thorpej/Electronics/Power_Supplies/RPI_Remote_Power_Controller/RPI_Remote_Power_Controller-pcb-front.jpg

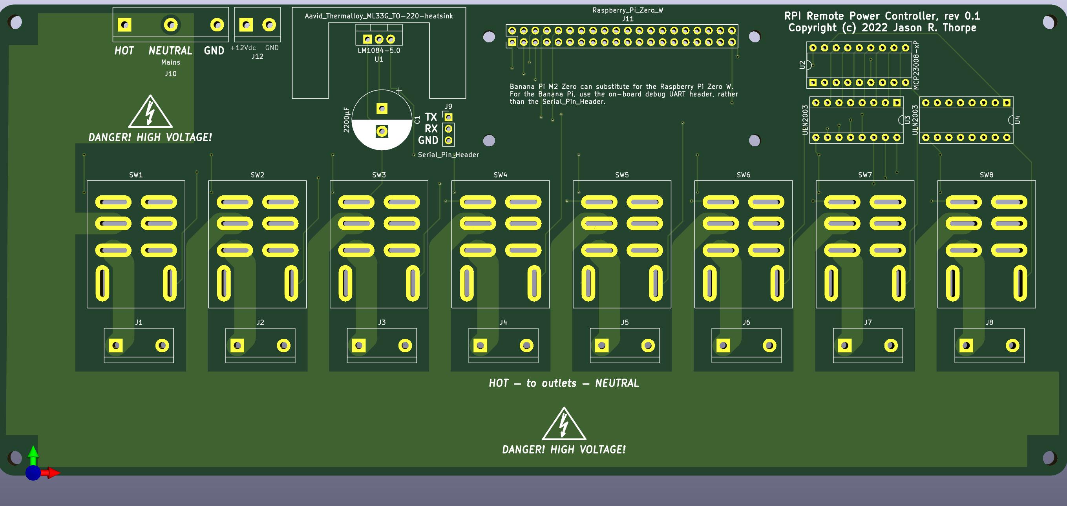
Power_Supplies/RPI_Remote_Power_Controller/RPI_Remote_Power_Controller-pcb-front.jpg
