thorpej/Electronics/Tube_Audio/Helper_Circuits/9A_9AJ_Heater_Helper/9A_9AJ_Heater_Helper-pcb.jpg

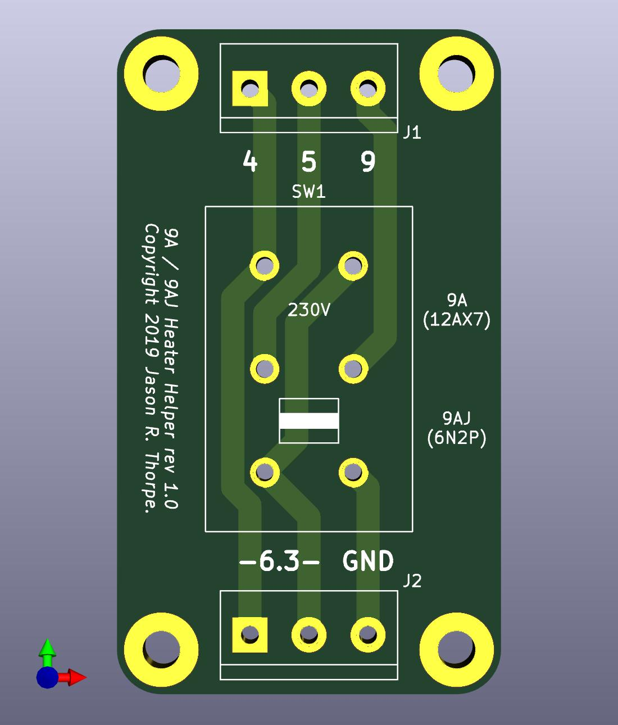
Tube_Audio/Helper_Circuits/9A_9AJ_Heater_Helper/9A_9AJ_Heater_Helper-pcb.jpg
