thorpej/Electronics/README.md

# Electronics
thorpej's electronics projects repository.  Tube audio, other tube stuff, and stuff with computers in it.

# **WARNING**
Some of the materials in this repository desribe circuits that employ **HIGH VOLTAGES** that can be **LETHAL**.
If you build or otherwise use any of these circuits, you do so **AT YOUR OWN RISK**.
