thorpej/Electronics/Tube_Audio/Helper_Circuits/Bias_Balance_Helper_x2/README.md

# 2-Channel Bias-Balance Helper

This is a simple helper board that helps simplify the wiring of a particular output tube
bias-balance circuit that I like to use:

	               A
	               |
	      +---R1---+-----C1-)|----+
	      |        |              |
	      |        |              |
	C- ---+       RV1<---R3---RV2-+-GND
	      |        |           ^--+
	      |        |              |
	      +---R2---+-----C2-)|----+
	               |
	               B

Where:
* C- is the input negative bias voltage from the bias supply.
* RV1 is the "balance" pot used to balance the quiescent current of the two output tubes.
* RV2 is the "bias" pot used to set the nominal bias voltage.  The wiper is connected to one end of the pot such that if the wiper fails for some reason, the maxiumum negative bias voltage will be applied to the output tubes, thereby preventing the tubes from melting down.

The circuit is essentially 2 parallel voltage dividers.  The divider for tube "A" is formed by R1,
RV1, R3, and RV2.  The divider for tube "B" formed by R2, RV1, R3, and RV2.  C1 and C2 are
there to smooth any ripple out of the bias voltage applied to the output tube grids.

This little board has connections for GND, C-, and 2 channels worth of R1, R2, C1, and C2.
All that is required finish the complete circuit is to make the appropriate connections to the pots
(RV1 and RV2) whereever they happen to be mounted (usually next to each other on the deck
so it's easy to adjust).  The wiper of RV1 is connected to one end of RV2 with R3, and that can
easily be done directly on the pots themselves.

The resistor footprints on the board can accommodate resistors 2.5mm in diameter; the pad
spacing is 10.16mm.  The capacitor footprints on the board can accommodate  radial electrolytics
up to 10mm in diameter; the lead spacing is 2.5mm.  The electrolytics must have a voltage rating
sufficient for the largest negative voltage your voltage divider network supply will produce.
