thorpej/Electronics/Power_Supplies/KWard_Adjustable_Bench_Power_Supply/design-files/panel-supply/README.md

# Panel supply

The panel supply board provides a regulated supply to the pass tube array's
cooling fan and the PSU's meters: B+ voltage, B+ current, and C- voltage.

The board is powered by a 12Vac @ 1A transformer, such as the Triad F5-12.
The AC input is rectified by a Rectron DB101 diode bridge chip, filtered,
and fed to an LM2940 12V LDO regulator.

The 12Vdc output for the cooling fan has a provision for a resistor that can
be used to limit the current or drop the voltage to the fan, if desired.  If
you don't want to put a resistor there, just install a jumper wire at the R1
position.  Note the resistor is mounted vertically (to save board space).

The board also has a provisions for 3 Murata MEE1S12xxDC DC-DC converters.
Even if your meters can operate on 12Vdc, use of these DC-DC converters is
**mandatory** because the inexpensive panel meters widely available from China
typically require isolated power supplies.  (Speculation: they are floating
their own internal supply on top of measured voltage?)

There is room on the board for a small heat sink for the LM2940, if necessary,
although there is no dedicated footprint outline for it.  If your LM2940 is
getting warm, there are a variety of heat sinks availble from outlets such as
Amazon (just search for "TO-220 heatsink") that should fit in the alotted space.

The board has standard M3 mounting holes, and is intended to be mounted on the
back of the PSU front panel using stand-offs.

## Parts list

* 12Vac @ 1A power transformer, such as the Triad F5-12.
_Mouser part number 553-F5-12._
* 5x 2-position screw terminal blocks, 2.54mm pitch (TE 282834-2 or equivalent).
_Mouser part number 571-282834-2._
* 1x Rectron DB101 diode bridge (any Rectron DB10x can substitute, if desired).
_Mouser part number 583-DB101._
* 1x 2200µF 25V electrolytic capacitor, up to 12.5mm diameter, 5mm lead spacing.
_Mouser part number 555-RJH-25V222MI9#._
* 1x 220µf 25V electrolytic capacitor, up to 6.3mm diameter, 2.5mm lead spacing.
This capacitor should have an ESR between 100 mOhm and 1 Ohm, per the LM2940 data
sheet.  _Mouser part number 232-25YXS220MEFC63X1._
* 1x LM2940 12V 1A LDO regulator or equivalent (see LM2940 data sheet for pinout).
_Mouser part number 926-LM2940T-50/LF08._
* Murata MEE1S12xxDC DC-DC converters (availble from Mouser or DigiKey).
