thorpej/Electronics/Power_Supplies/KWard_Adjustable_Bench_Power_Supply/KWard_original/Bench PSU Schematic Final.pdf

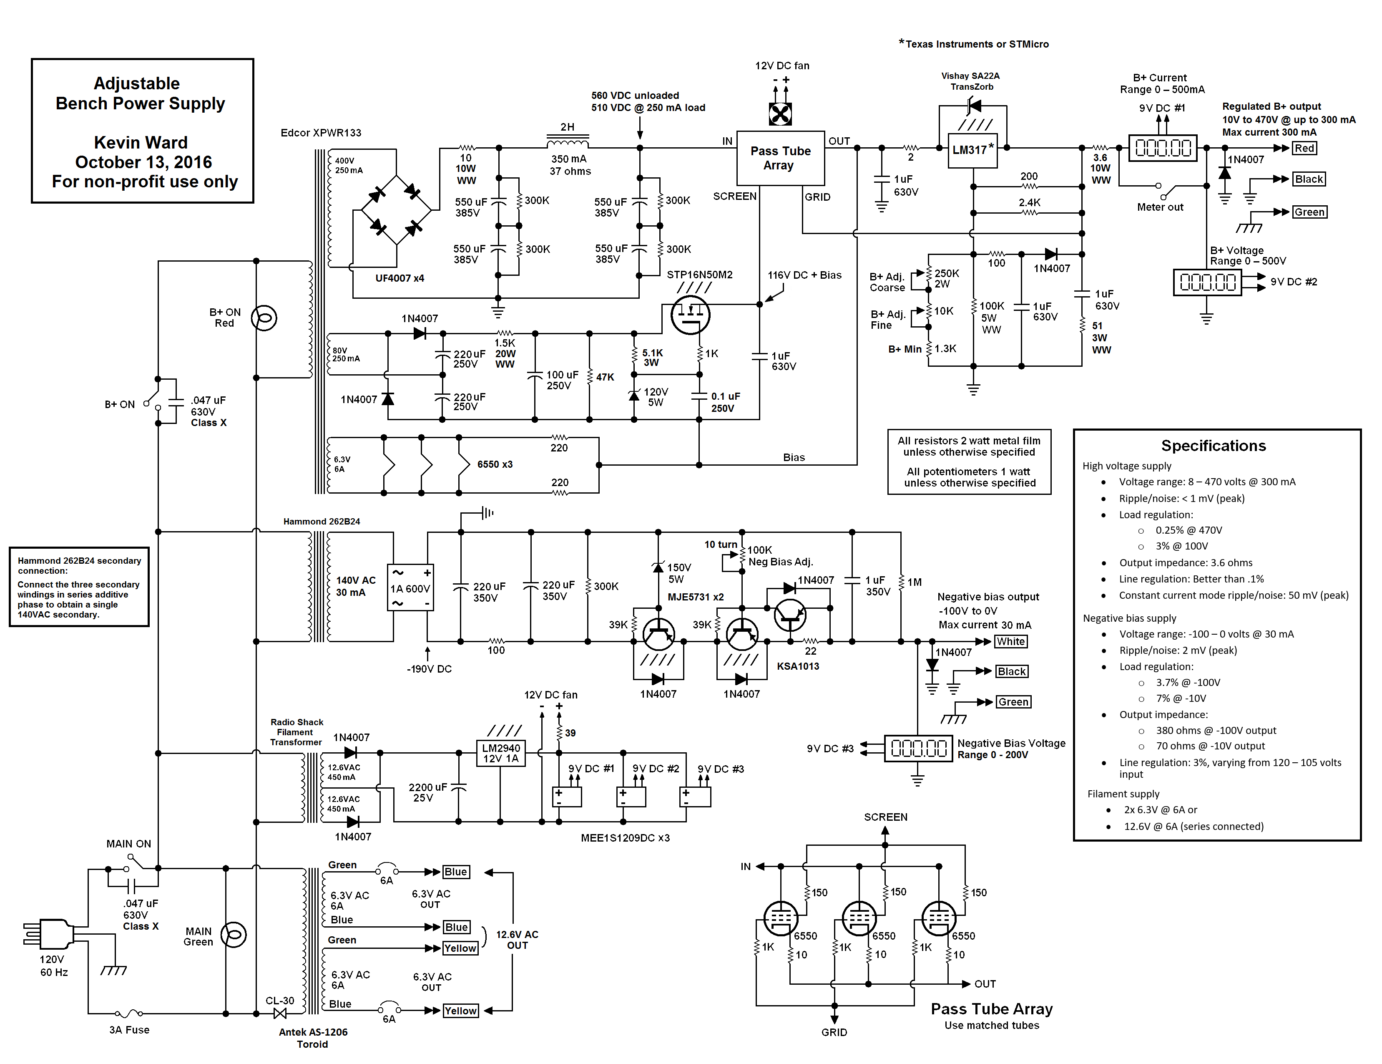
[picture p3: page 1]
