thorpej/Electronics/Power_Supplies/KWard_Adjustable_Bench_Power_Supply/design-files/bias-supply/bias-supply-pcb.jpg

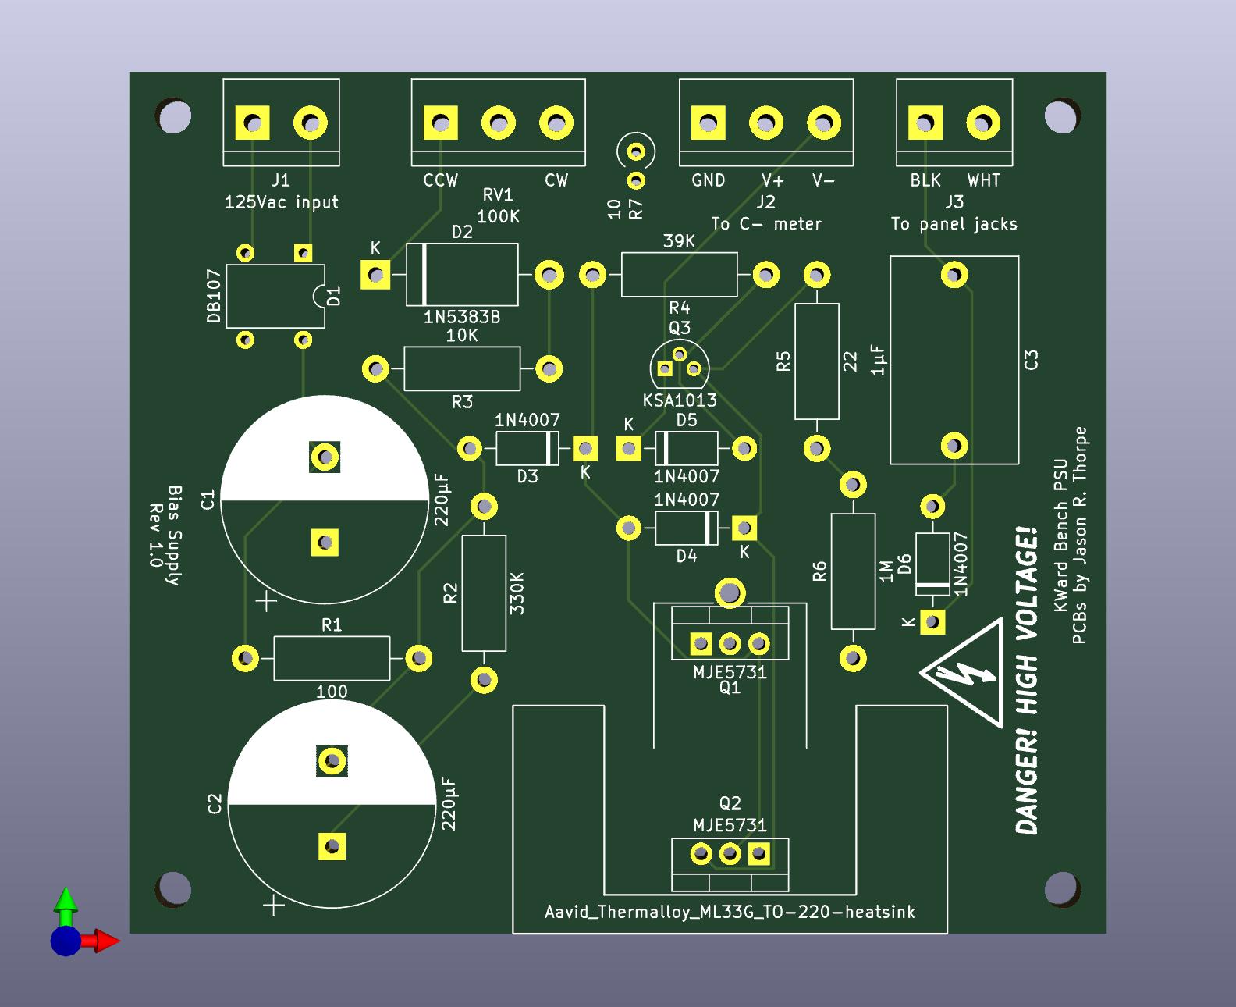
Power_Supplies/KWard_Adjustable_Bench_Power_Supply/design-files/bias-supply/bias-supply-pcb.jpg
