thorpej/Electronics/Power_Supplies/KWard_Adjustable_Bench_Power_Supply/KWard_original/POT setting vs. Output voltage.png

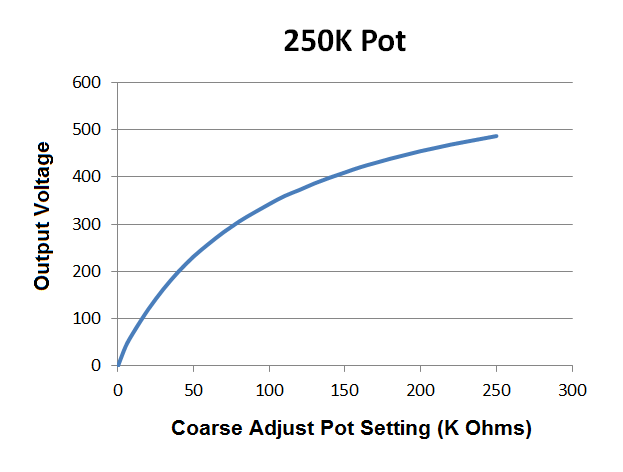
Power_Supplies/KWard_Adjustable_Bench_Power_Supply/KWard_original/POT setting vs. Output voltage.png
