thorpej/Electronics/Power_Supplies/RPI_Remote_Power_Controller/RPI_Remote_Power_Controller-pcb-back.jpg

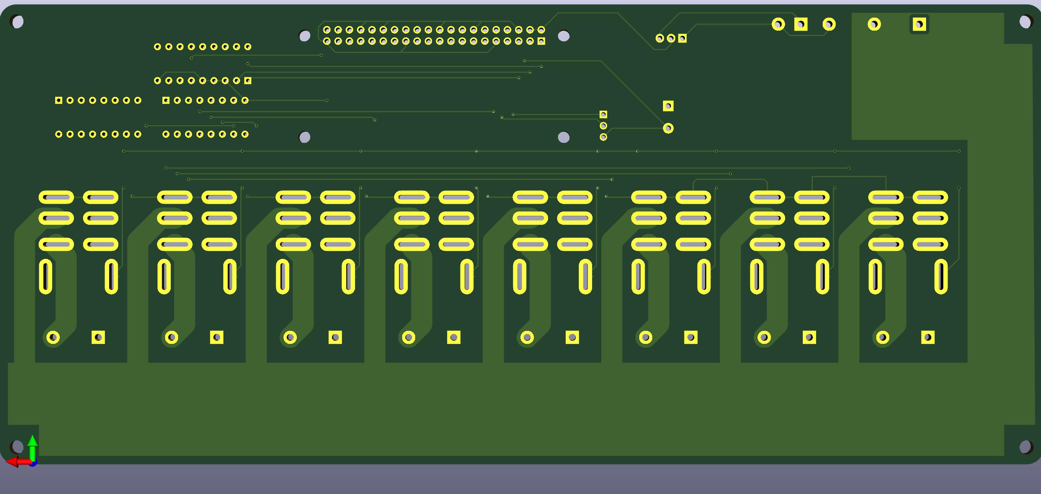
Power_Supplies/RPI_Remote_Power_Controller/RPI_Remote_Power_Controller-pcb-back.jpg
