thorpej/Electronics/Tube_Audio/Helper_Circuits/EFB_Bias_Supply/EFB_Bias_Supply_PCB.jpg

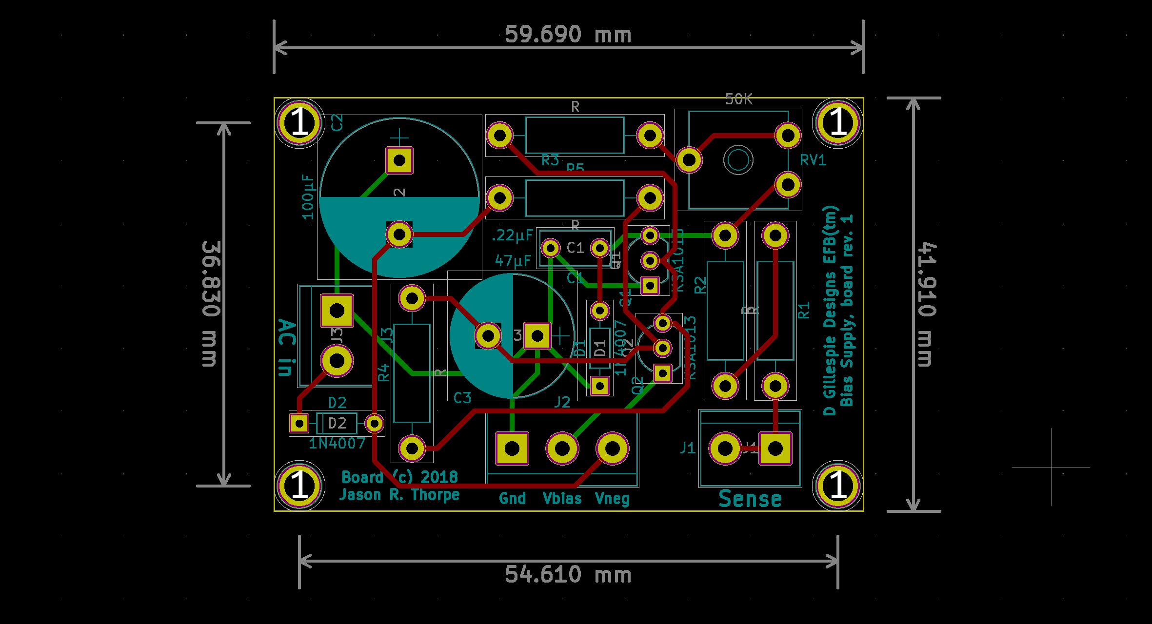
Tube_Audio/Helper_Circuits/EFB_Bias_Supply/EFB_Bias_Supply_PCB.jpg
