thorpej/Electronics/Tube_Audio/Helper_Circuits/SnapInCapStack/SnapInCapStack-pcb.jpg

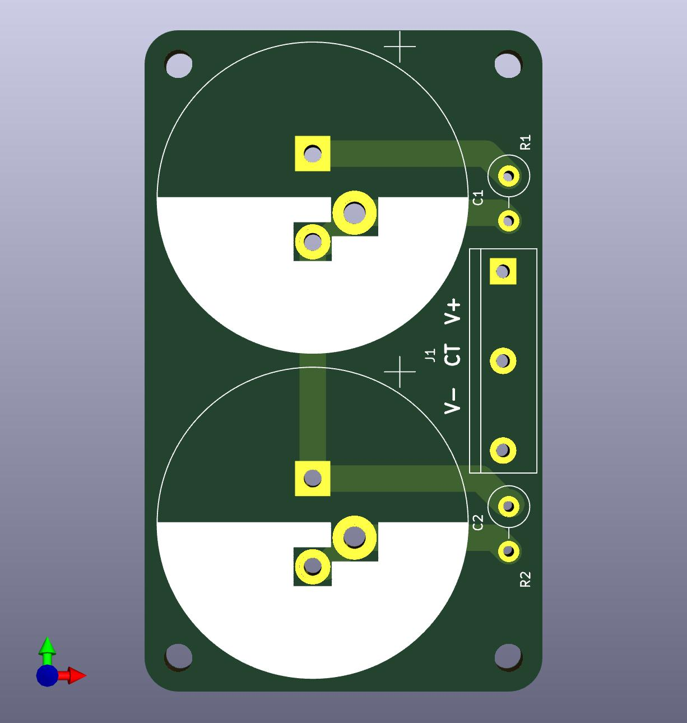
Tube_Audio/Helper_Circuits/SnapInCapStack/SnapInCapStack-pcb.jpg
