thorpej/Electronics/Power_Supplies/KWard_Adjustable_Bench_Power_Supply/KWard_original/capacitor discharge vulnerability fix.png

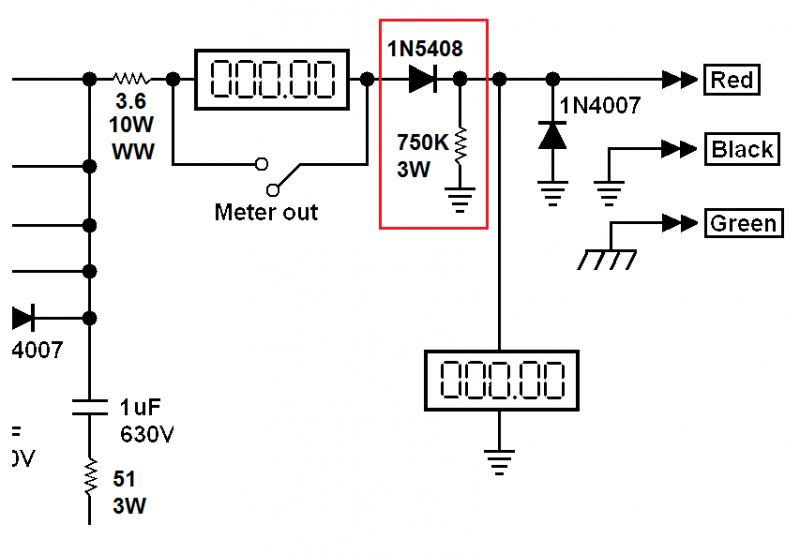
Power_Supplies/KWard_Adjustable_Bench_Power_Supply/KWard_original/capacitor discharge vulnerability fix.png
