thorpej/Electronics/(threads)

Thread 3 (2023-03-15):

The PCB and the DPDT power switch

muni2773, 2023-03-15:
Can you please give exact steps to getting the PCB and then attaching to the switch ?

I got some 6NLPs but can't replace the AX7s that are currently installed

Thanks
