thorpej/Electronics/Power_Supplies/RPI_Remote_Power_Controller/RPI_Remote_Power_Controller-schematic.pdf

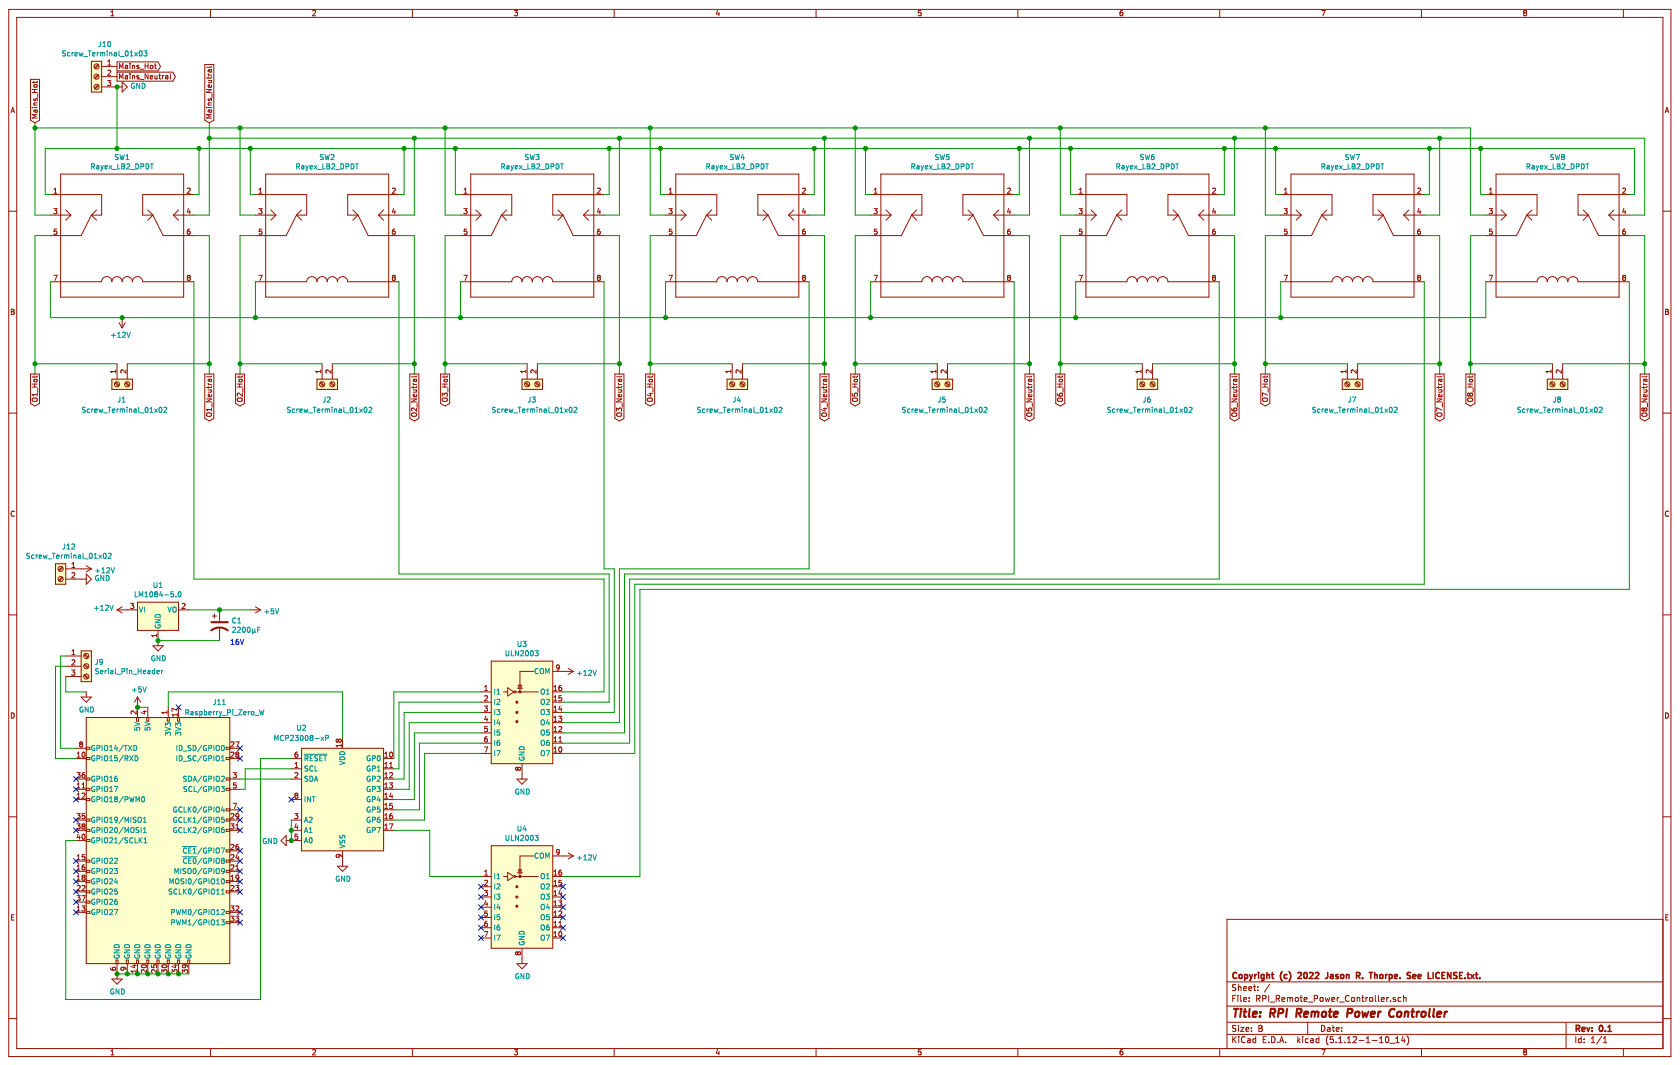
[picture p13: page 1]
