thorpej/Electronics/Tube_Audio/Helper_Circuits/EFB_Bias_Supply/EFB_Bias_Supply_Schematic.pdf

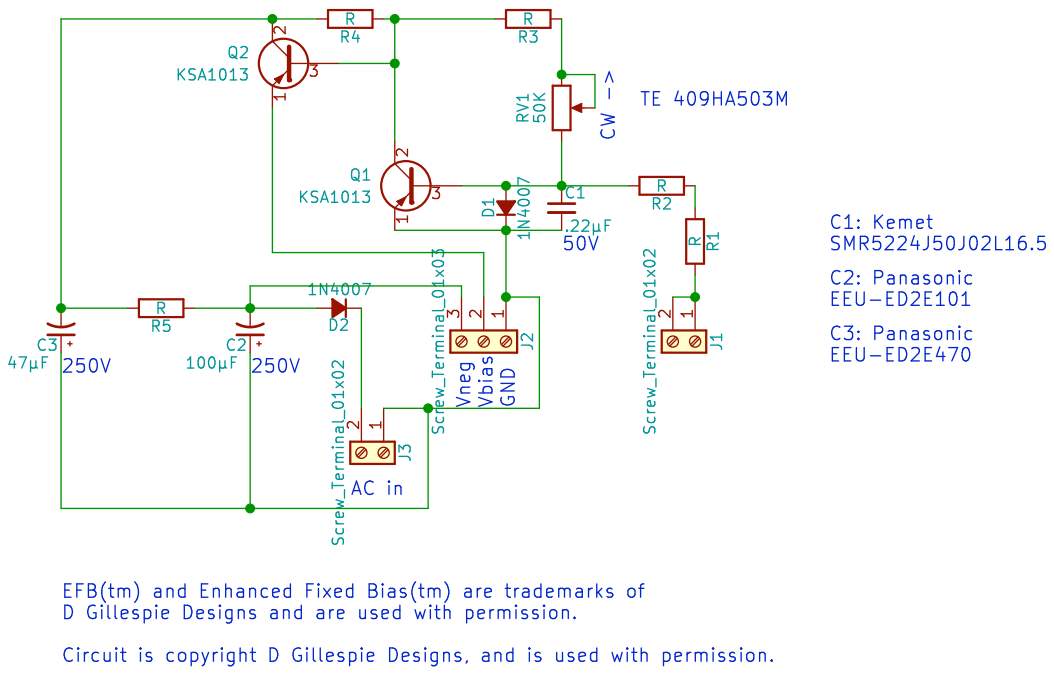
[picture p14: page 1]
