thorpej/Electronics/Tube_Audio/Helper_Circuits/SnapInCapStack/SnapInCapStack-schematic.pdf

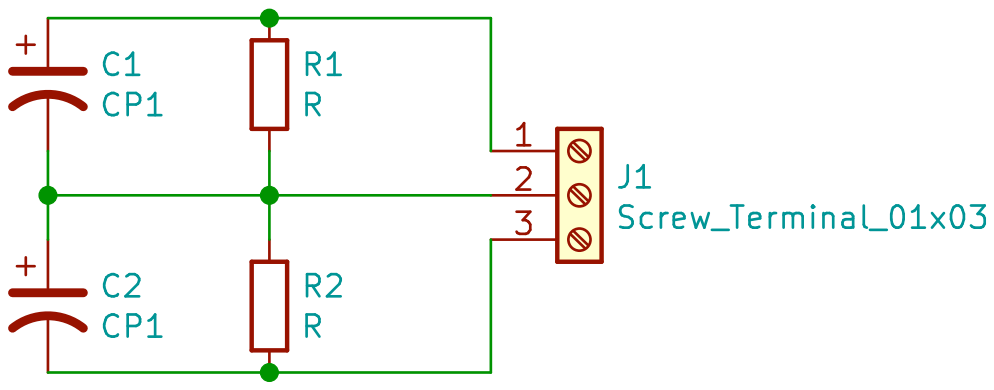
[picture p16: page 1]
