thorpej/Electronics/Power_Supplies/KWard_Adjustable_Bench_Power_Supply/design-files/hv-supply/hv-supply-schematic.pdf

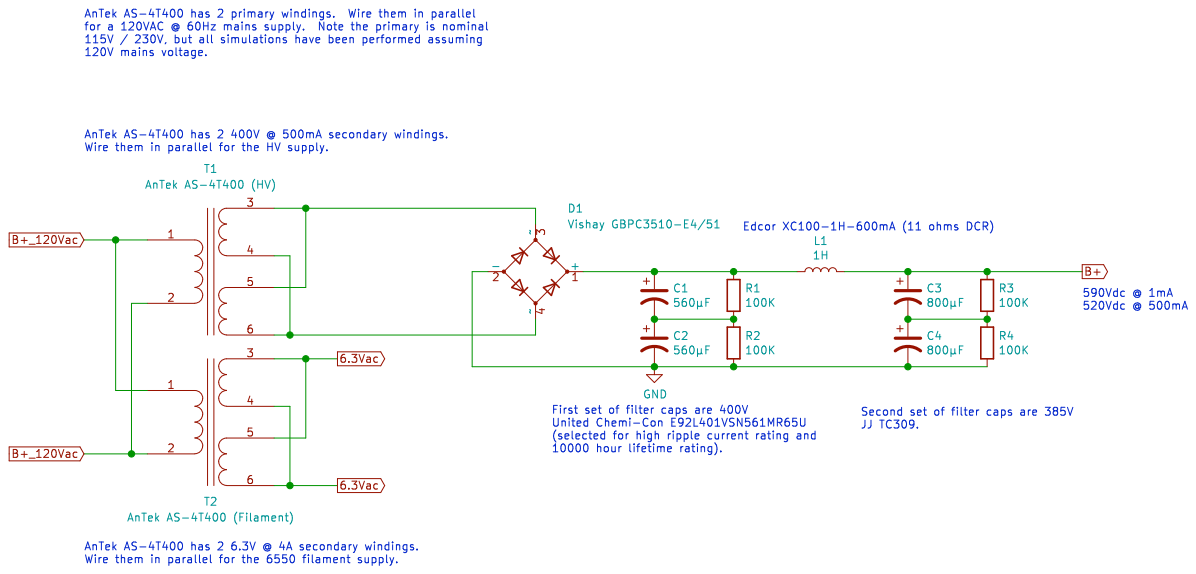
[picture p17: page 1]
