thorpej/Electronics/Power_Supplies/KWard_Adjustable_Bench_Power_Supply/design-files/pass-tube-array/pass-tube-array-pcb.pdf

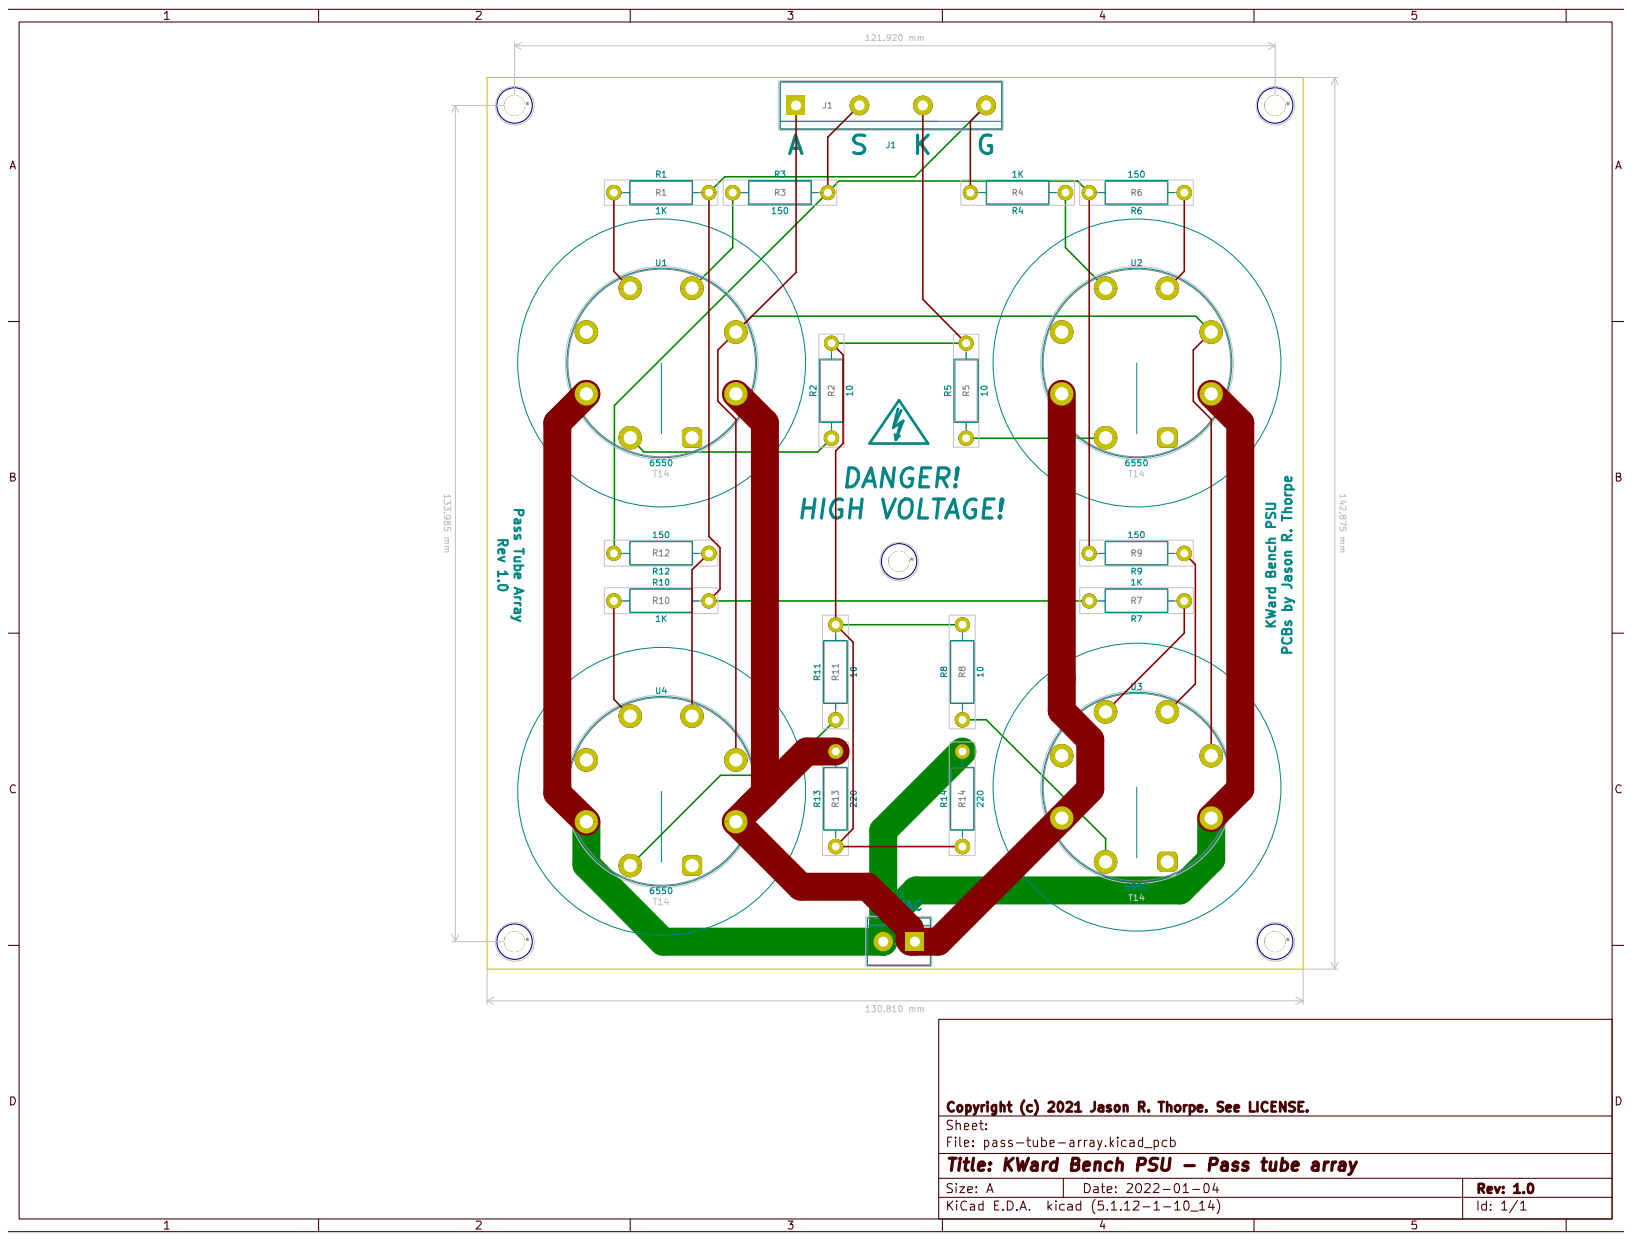
[picture p18: page 1]
