thorpej/Electronics/Power_Supplies/KWard_Adjustable_Bench_Power_Supply/design-files/pass-tube-array/pass-tube-array-schematic.pdf

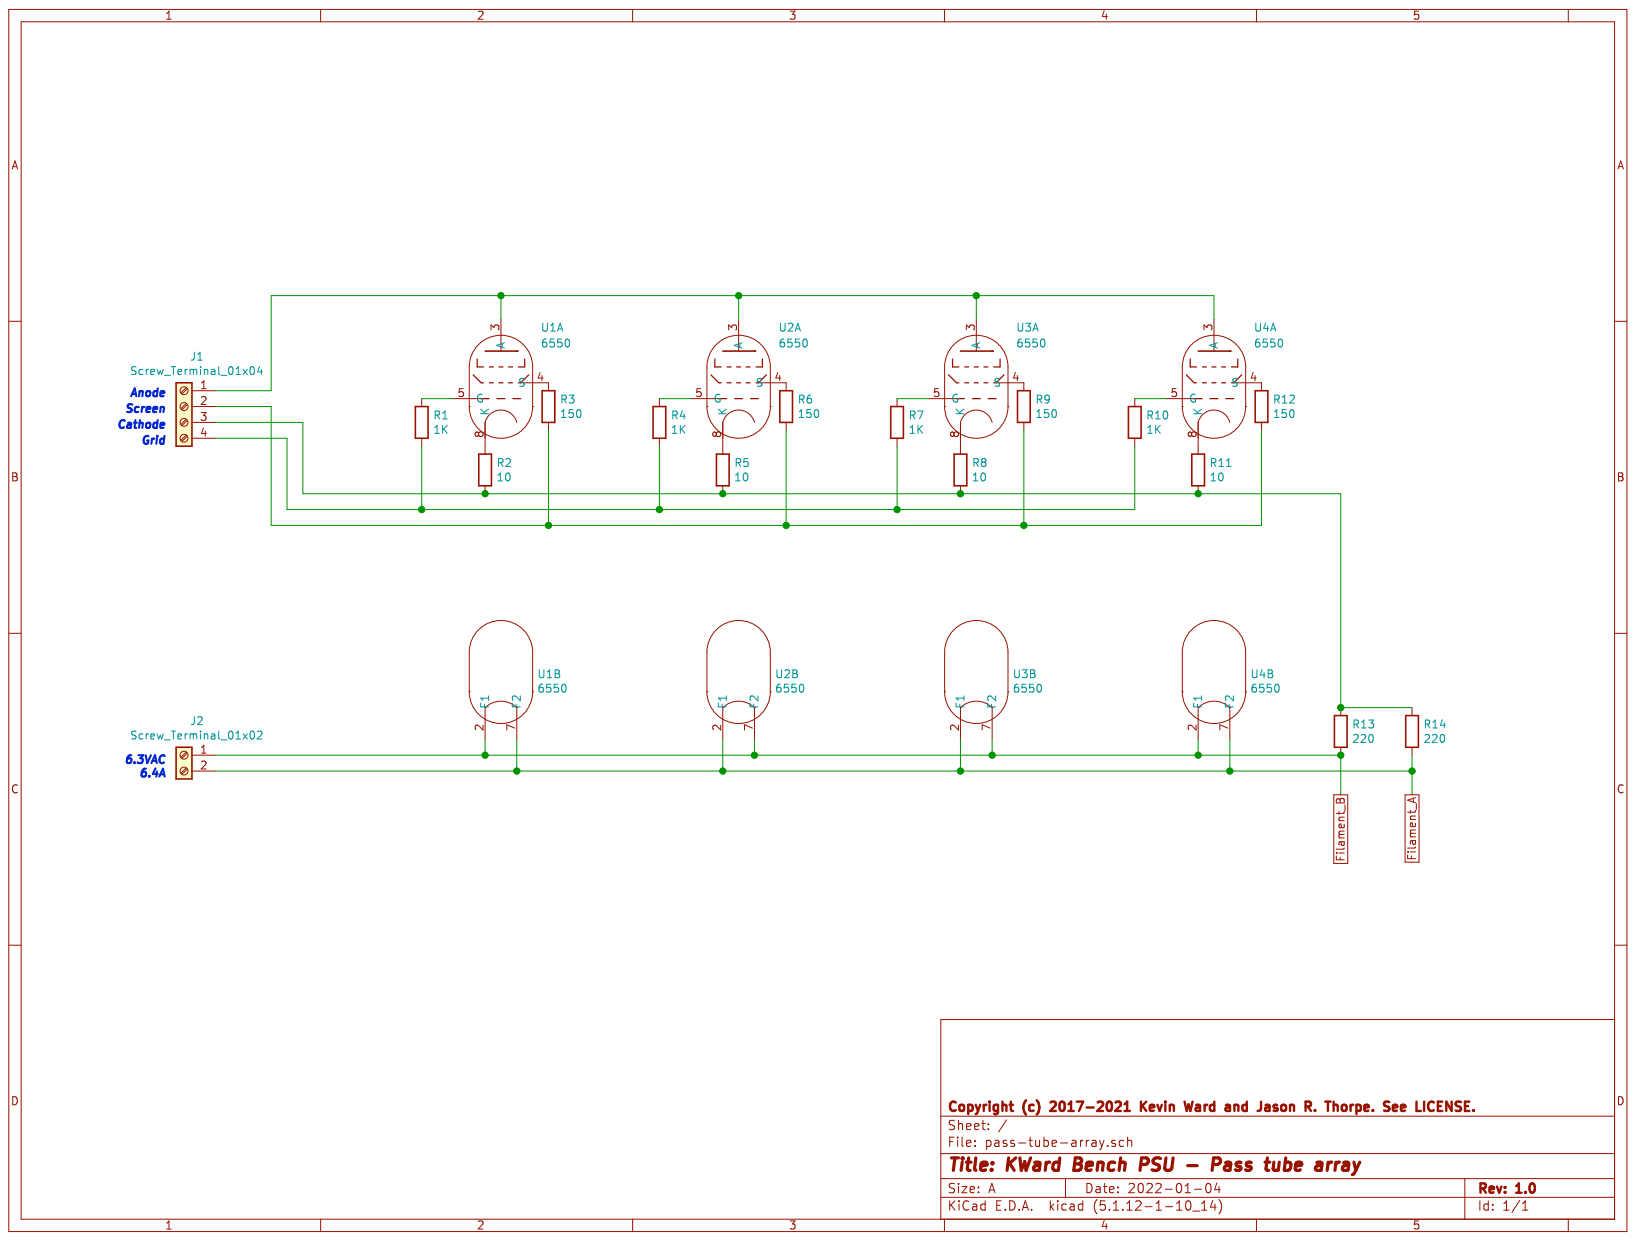
[picture p19: page 1]
