thorpej/Electronics/Power_Supplies/KWard_Adjustable_Bench_Power_Supply/design-files/panel-supply/panel-supply-pcb.pdf

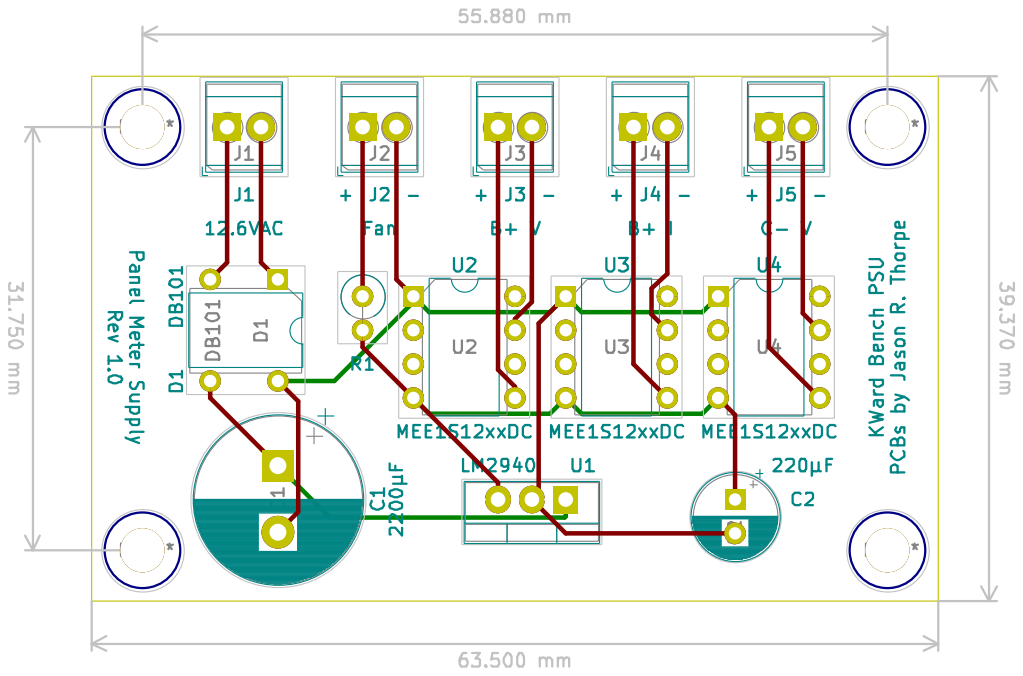
[picture p20: page 1]
