thorpej/Electronics/Power_Supplies/KWard_Adjustable_Bench_Power_Supply/design-files/bias-supply/bias-supply-pcb.pdf

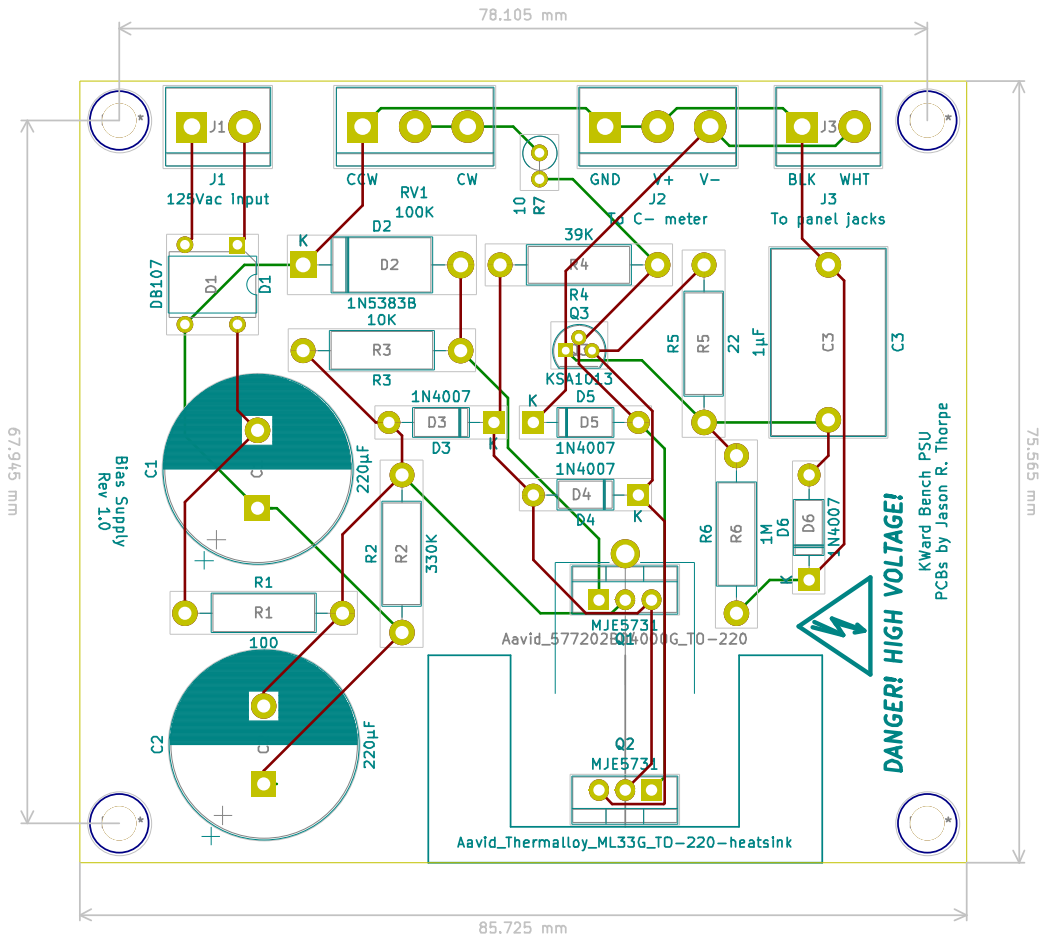
[picture p21: page 1]
