thorpej/Electronics/Power_Supplies/KWard_Adjustable_Bench_Power_Supply/design-files/bias-supply/bias-supply-schematic.pdf

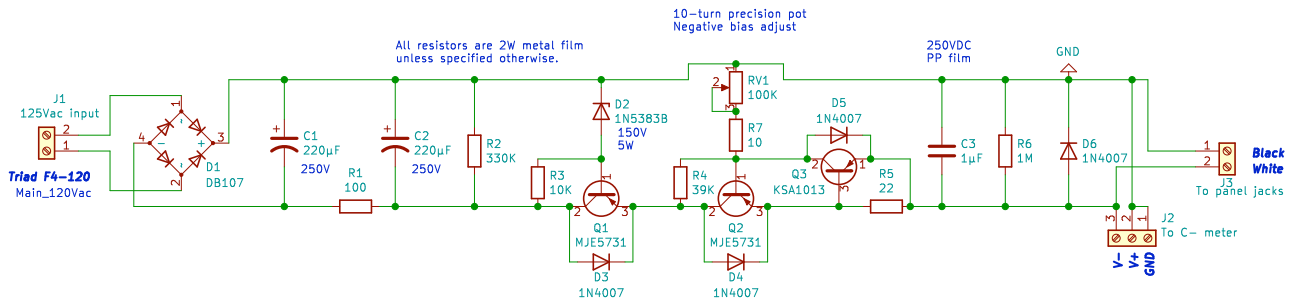
[picture p22: page 1]
