thorpej/Electronics/Power_Supplies/KWard_Adjustable_Bench_Power_Supply/design-files/panel-supply/panel-supply-schematic.pdf

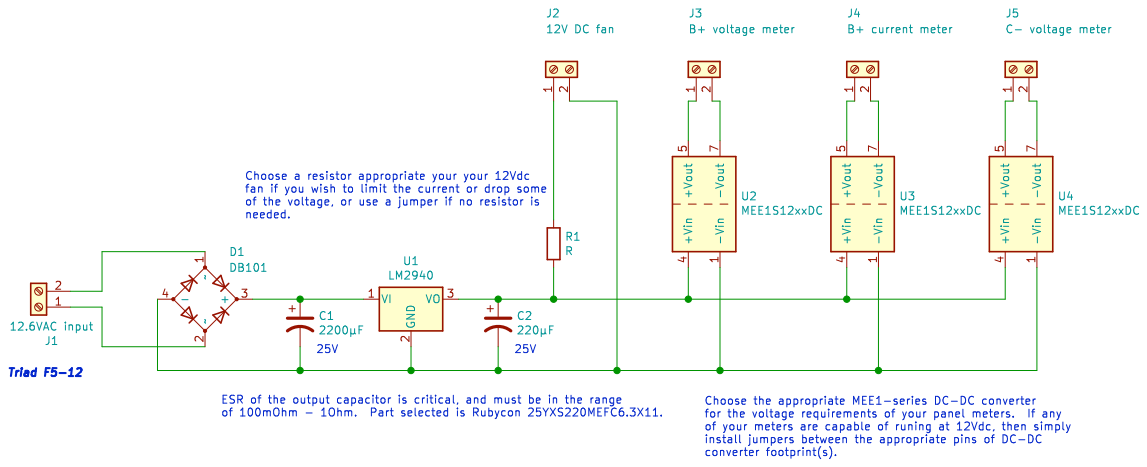
[picture p23: page 1]
