thorpej/Electronics/Power_Supplies/RPI_Remote_Power_Controller/RPI_Remote_Power_Controller-pcb.pdf

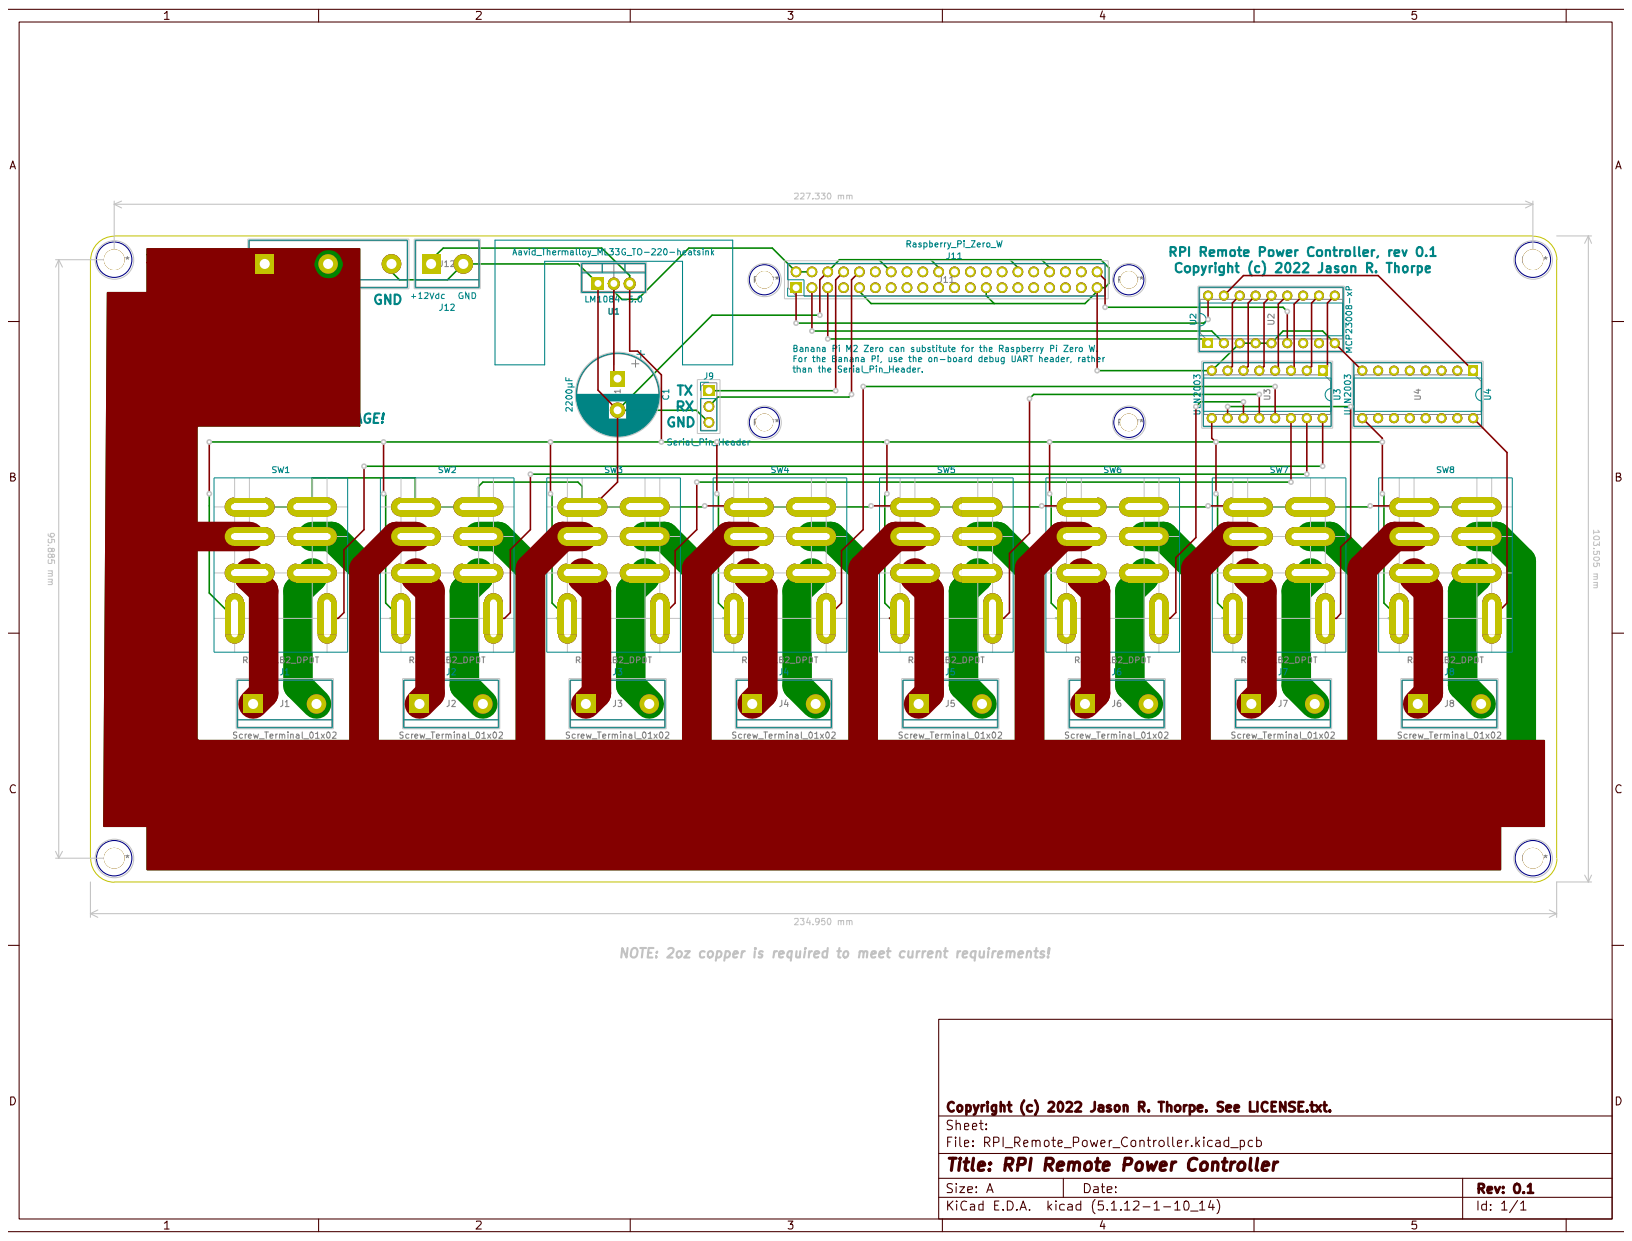
[picture p24: page 1]
