thorpej/Electronics/Tube_Audio/Helper_Circuits/SnapInCapStack/SnapInCapStack-pcb.pdf

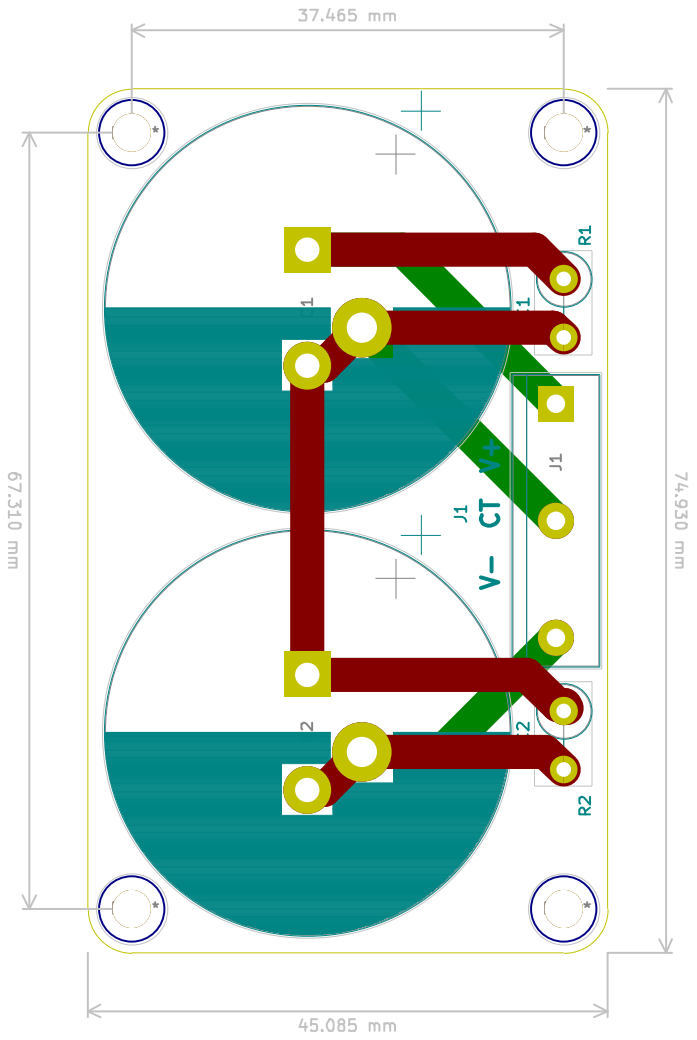
[picture p26: page 1]
