thorpej/Electronics/Tube_Audio/Helper_Circuits/9A_9AJ_Heater_Helper/9A_9AJ_Heater_Helper-pcb.pdf

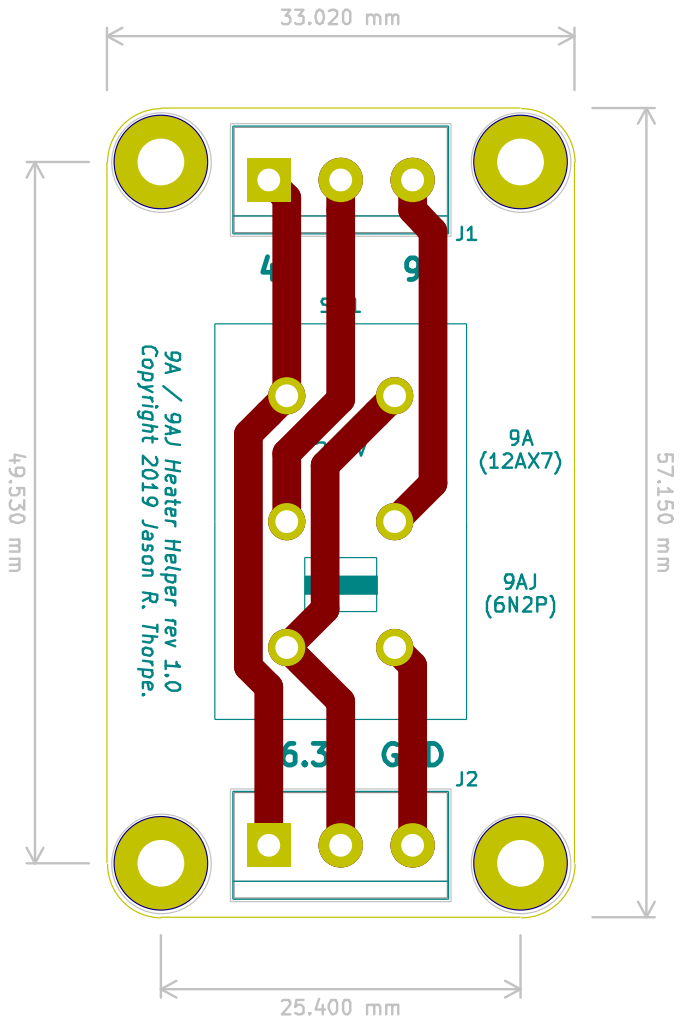
[picture p27: page 1]
