thorpej/Electronics/Misc_Audio/DumbDAC8/DumbDAC8_Sim.asc

R1: res; 200K
R2: res; 200K
R3: res; 200K
R4: res; 200K
R5: res; 200K
R6: res; 200K
R7: res; 200K
R8: res; 200K
R9: res; 100K
R10: res; 100K
R11: res; 100K
R12: res; 100K
R13: res; 100K
R14: res; 100K
R15: res; 100K
R16: res; 25K
R17: res; 200K
V1: voltage; 5
V2: voltage; 5
V3: voltage; 5
V4: voltage; 5
V5: voltage; 5
V6: voltage; 5
V7: voltage; 5
V8: voltage; 5
Named nets: 0
D0
D7
.tran 1
3.8mV
5.7mV
10.5mV
20.5mV
40.8mV
81.5mV
163.0mV
326.1mV
15K
5.8mV
8.7mV
16.1mV
31.5mV
62.6mV
125.0mV
250.0mV
500mV
25K
3.9mV
7.8mV
15.6mV
31.25mV
62.5mV
125.0mV
250.0mV
500mV
With R17
