thorpej/Electronics/Power_Supplies/KWard_Adjustable_Bench_Power_Supply/spice/ScreenSupply.asc

C1: polcap; 220µF
C2: polcap; 220µF
C3: cap; 0.47µF
C4: cap; 1µF
D1: diode
D2: diode
D3: diode
D4: diode
D5: zener; 1N5378B
D6: zener; EDZV20B
I1: current; 62.5mA
M1: nmos; STF16N50M2_V2
R1: res; 330
R2: res; 47K
R3: res; 2.2K
R4: res; 1K
V1: voltage; SINE(0 169 60)
Named nets: 0
.tran 2
.inc STF16N50M2_V2.LIB
100V
20V
Triad F6-120
MDA106G
Use a single 1N5380BG 120V 5W Zener.
630V
metalized film
630V
metalized film
10W WW
2x Nichicon UCS2E221MHD
250V
250V
