thorpej/Electronics/Power_Supplies/KWard_Adjustable_Bench_Power_Supply/spice/B+Supply.asc

C1: polcap; 560µF
C2: polcap; 560µF
C3: polcap; 800µF
C4: polcap; 800µF
D1: diode
D2: diode
D3: diode
D4: diode
I1: current; 500mA
L1: ind; 1H; Rser=11
R1: res; 10
R2: res; 100K
R3: res; 100K
R4: res; 100K
R5: res; 100K
V1: voltage; SINE(0 560 60)
Named nets: 0
.tran 5
AnTek AS-4T400
Vishay GBPC3510-E4/51
Edcor XC100-1H-600mA (11 ohms)
385V
385V
385V
385V
2x TDK B43501B3567M2
2x JJ TC309
