thorpej/Electronics/Tube_Audio/Helper_Circuits/EFB_Bias_Supply/Bias_Balance_Network.asc

C1: polcap; 10µF
C2: polcap; 10µF
C3: polcap; 10µF
C4: polcap; 10µF
R1: res; 9.1K
R2: res; 9.1K
R3: res; 5K
R4: res; 5K
R5: res; 6.2K
R6: res; 12.5K
R7: res; 9.1K
R8: res; 9.1K
R9: res; 5K
R10: res; 5K
R11: res; 6.2K
R12: res; 12.5K
V1: voltage; 43
Named nets: 0, A, B, C, D
.tran 5
Resistor pairs R3/R4 and R9/R10 are actually a 10K pot; this is a
DC balance adjustment for a push-pull pair.
While more complex than individual bias controls, this circuit provides
for easier DC balance adjustment, and provides protection against
a wiper failiure of the bias pot; if that happens, maximum negative
bias voltage will  be applied to the output tube grids, thus preventing
damage.
Resistors R6 and R12 are actually 25K pots with the wiper
connected to one end to form a variable resistor.  This is a bias
adjustment for a push-pull pair.
