thorpej/Electronics/Tube_Audio/Helper_Circuits/EFB_Bias_Supply/Individual_Bias_Network.asc

C1: polcap; 10µF
C2: polcap; 10µF
C3: polcap; 10µF
C4: polcap; 10µF
R1: res; 12.5K
R2: res; 12.5K
R3: res; 12.5K
R4: res; 12.5K
R5: res; 12.5K
R6: res; 12.5K
R7: res; 12.5K
R8: res; 12.5K
R9: res; 10K
V1: voltage; 63
Named nets: 0, A, B, C, D
.tran 5
Resistor pairs (R1/R2, R3/R4, R5/R6, and R7/R8) are actually a 25K
pot, with the junction in the middle being the wiper that connects to
a single output tube grid.  Each tube can be individually biased with
this topology.
