thorpej/Electronics/Power_Supplies/KWard_Adjustable_Bench_Power_Supply/spice/BiasSupply.asc

C1: polcap; 220µF
C2: polcap; 220µF
C4: cap; 1µF
D1: diode
D2: diode
D3: diode
D4: diode
D5: zener; 1N5378B
D6: zener; EDZV20B
D7: zener; EDZV30B
D8: diode
D9: diode
D10: diode
D11: diode
I1: current; 30mA
Q1: pnp; Qmje5730
Q2: pnp; Qmje5730
Q3: pnp
R1: res; 100
R2: res; 300K
R3: res; 10K
R4: res; 39K
R5: res; 1000K
R6: res; 100K
R7: res; 22
R8: res; 10
V1: voltage; SINE(0 168 60)
Named nets: 0
.tran 10
.inc MJE5730.LIB.txt
100V
20V
Triad F4-120
MDA106G
Use a single 1N5383BG 150V 5W Zener.
400V
metalized film
2x Nichicon UCS2E221MHD
250V
250V
30V
100K pot
2x MJE5370
KSA1013
