thorpej/Electronics/Power_Supplies/KWard_Adjustable_Bench_Power_Supply/design-files/screen-supply-and-regulator/screen-supply-and-regulator.kicad_pcb

## KiCad design Power_Supplies/KWard_Adjustable_Bench_Power_Supply/design-files/screen-supply-and-regulator/screen-supply-and-regulator.kicad_pcb (2022-04-21)

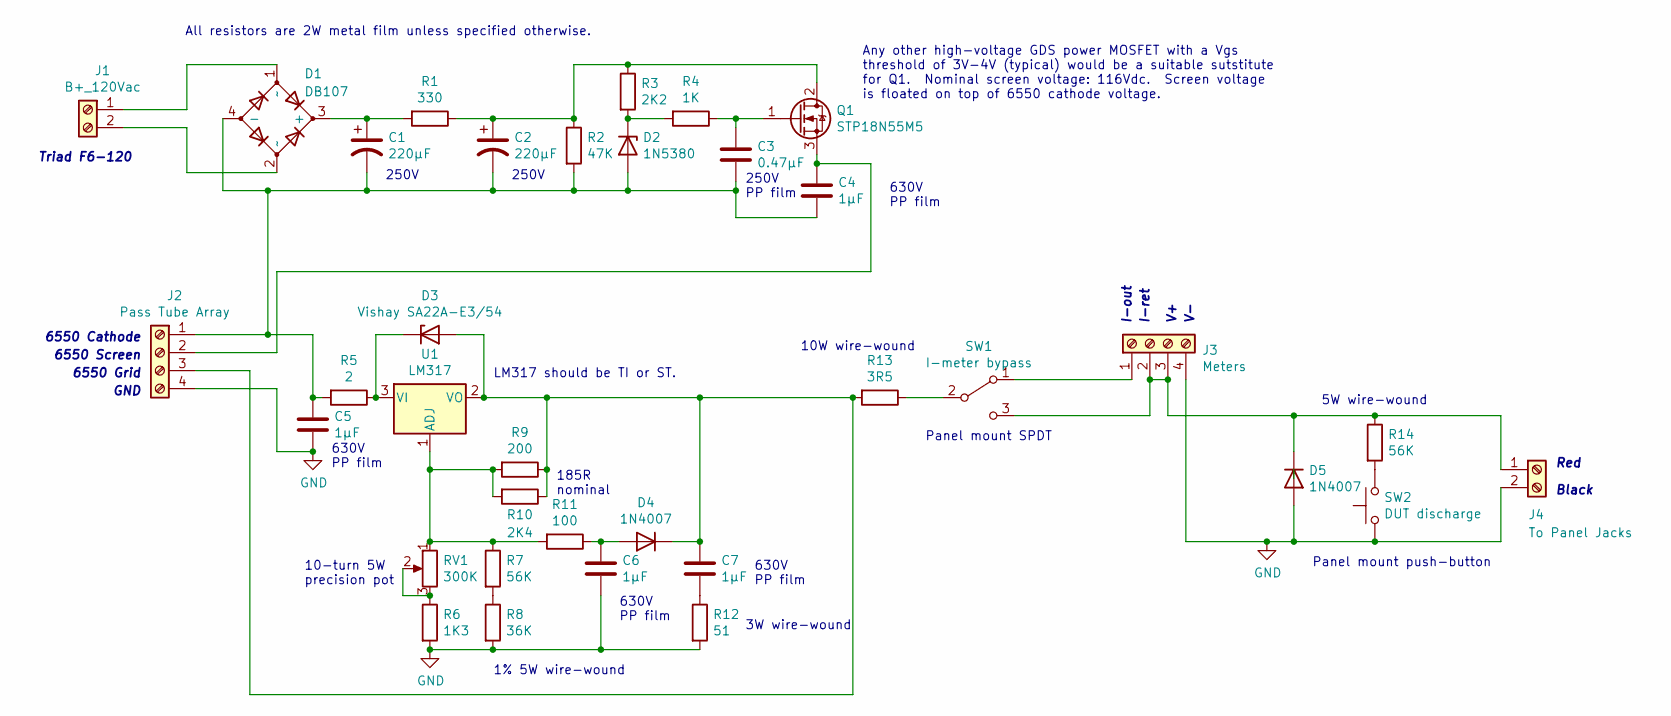
[picture p28: schematic screen-supply-and-regulator.sch, KWard Bench PSU - Screen supply and regulator circuit]

Parts:
C1, C2: 220µF; CP_Radial_D18.0mm_P7.50mm; Mouser 647-UCS2E221MHD
C3: 0.47µF; C_Rect_L18.0mm_W8.0mm_P15.00mm_FKS3_FKP3; Mouser 80-PHE426HB6470JR06
C4, C5, C6, C7: 1µF; C_Rect_L18.0mm_W18.0mm_P15.0mm; Mouser 667-ECW-FD2J105PC
D1: DB107; Diode_Bridge_DIP-4_W7.62mm_P5.08mm
D2: 1N5380; D_DO-201_P15.24mm_Horizontal
D3: Vishay SA22A-E3/54; D_DO-15_P15.24mm_Horizontal; Mouser 625-SA22A-E3/54
D4, D5: 1N4007; D_DO-41_SOD81_P10.16mm_Horizontal
J1: B+_120Vac; TerminalBlock_bornier-2_P5.08mm
J2: Pass Tube Array; TE_AMP-4_P10.16mm
J3: Meters; TE_AMP-4_P10.16mm
J4: To Panel Jacks; TE_AMP-2_P10.16mm
Q1: STP18N55M5; TO-220-3_Vertical
R1: 330; R_Axial_DIN0411_L9.9mm_D3.6mm_P15.24mm_Horizontal; Mouser 594-5083NW330R0J
R2: 47K; R_Axial_DIN0411_L9.9mm_D3.6mm_P15.24mm_Horizontal; Mouser 594-5083NW47K00JA100
R3: 2K2; R_Axial_DIN0411_L9.9mm_D3.6mm_P15.24mm_Horizontal; Mouser 594-5083NW2K200J
R4: 1K; R_Axial_DIN0411_L9.9mm_D3.6mm_P15.24mm_Horizontal; Mouser 594-5083NW1K000J
R5: 2; R_Axial_DIN0411_L9.9mm_D3.6mm_P15.24mm_Horizontal; Mouser 594-5083NW2R000J
R6: 1K3; R_Axial_DIN0411_L9.9mm_D3.6mm_P15.24mm_Horizontal; Mouser 594-5083NW1K300J
R7: 56K; R_Axial_Power_L25.0mm_W9.0mm_P30.48mm; Mouser 71-RS00556K00FE12
R8: 36K; R_Axial_Power_L25.0mm_W9.0mm_P30.48mm; Mouser 71-RS00236K00FB12
R9: 200; R_Axial_DIN0411_L9.9mm_D3.6mm_P15.24mm_Horizontal; Mouser 594-5083NW200R0J
R10: 2K4; R_Axial_DIN0411_L9.9mm_D3.6mm_P15.24mm_Horizontal; Mouser 594-5083NW2K400J
R11: 100; R_Axial_DIN0411_L9.9mm_D3.6mm_P15.24mm_Horizontal; Mouser 594-5083NW100R0JA100
R12: 51; R_Axial_DIN0614_L14.3mm_D5.7mm_P20.32mm_Horizontal; Mouser 71-NS02B51R00FE12
R13: 3R5; R_Axial_Power_L48.0mm_W12.5mm_P55.88mm; Mouser 71-RS0103R500FE12
R14: 56K; R_Axial_Power_L25.0mm_W6.4mm_P30.48mm; Mouser 71-CW00556K00JE12
RV1: 300K; TE_AMP-3_P10.16mm
SW1: I-meter bypass; TerminalBlock_bornier-3_P5.08mm
SW2: DUT discharge; TE_AMP-2_P10.16mm
U1: LM317; TO-220-3_Vertical; Mouser 926-LM317AT/NOPB

Connections:
GND: C5.2, C6.2, D5.2 (A), J2.4, J3.4, J4.2, R6.2, R8.2, R12.2, SW2.1
unnamed: C1.1, D1.3 (+), R1.2
unnamed: C1.2, C2.2, C3.2, C4.2, C5.1, D1.4 (-), D2.2 (A), J2.1, R2.2, R5.2
unnamed: C2.1, Q1.2 (D), R1.1, R2.1, R3.1
unnamed: C3.1, Q1.1 (G), R4.1
unnamed: C4.1, J2.2, Q1.3 (S)
unnamed: C6.1, D4.2 (A), R11.1
unnamed: C7.1, D3.2 (A), D4.1 (K), J2.3, R9.1, R10.1, R13.2, U1.2 (VO)
unnamed: C7.2, R12.1
unnamed: D1.1 (~~), J1.1
unnamed: D1.2 (~~), J1.2
unnamed: D2.1 (K), R3.2, R4.2
unnamed: D3.1 (K), R5.1, U1.3 (VI)
unnamed: D5.1 (K), J3.2, J3.3, J4.1, R14.1, SW1.3 (C)
unnamed: J3.1, SW1.1 (A)
unnamed: R6.1, RV1.2, RV1.3
unnamed: R7.2, R8.1
unnamed: R7.1, R9.2, R10.2, R11.2, RV1.1, U1.1 (ADJ)
unnamed: R13.1, SW1.2 (B)
unnamed: R14.2, SW2.2

Notes on the sheet:
Triad F6-120
Any other high-voltage GDS power MOSFET with a Vgs threshold of 3V-4V (typical) would be a suitable sutstitute for Q1. Nominal screen voltage: 116Vdc. Screen voltage is floated on top of 6550 cathode voltage.
6550 Cathode
6550 Grid
6550 Screen
630V PP film
185R nominal
10-turn 5W precision pot
3W wire-wound
1% 5W wire-wound
LM317 should be TI or ST.
All resistors are 2W metal film unless specified otherwise.
10W wire-wound
5W wire-wound
Panel mount SPDT
Panel mount push-button
Red
Black
I-out
I-ret
250V
250V PP film
GND

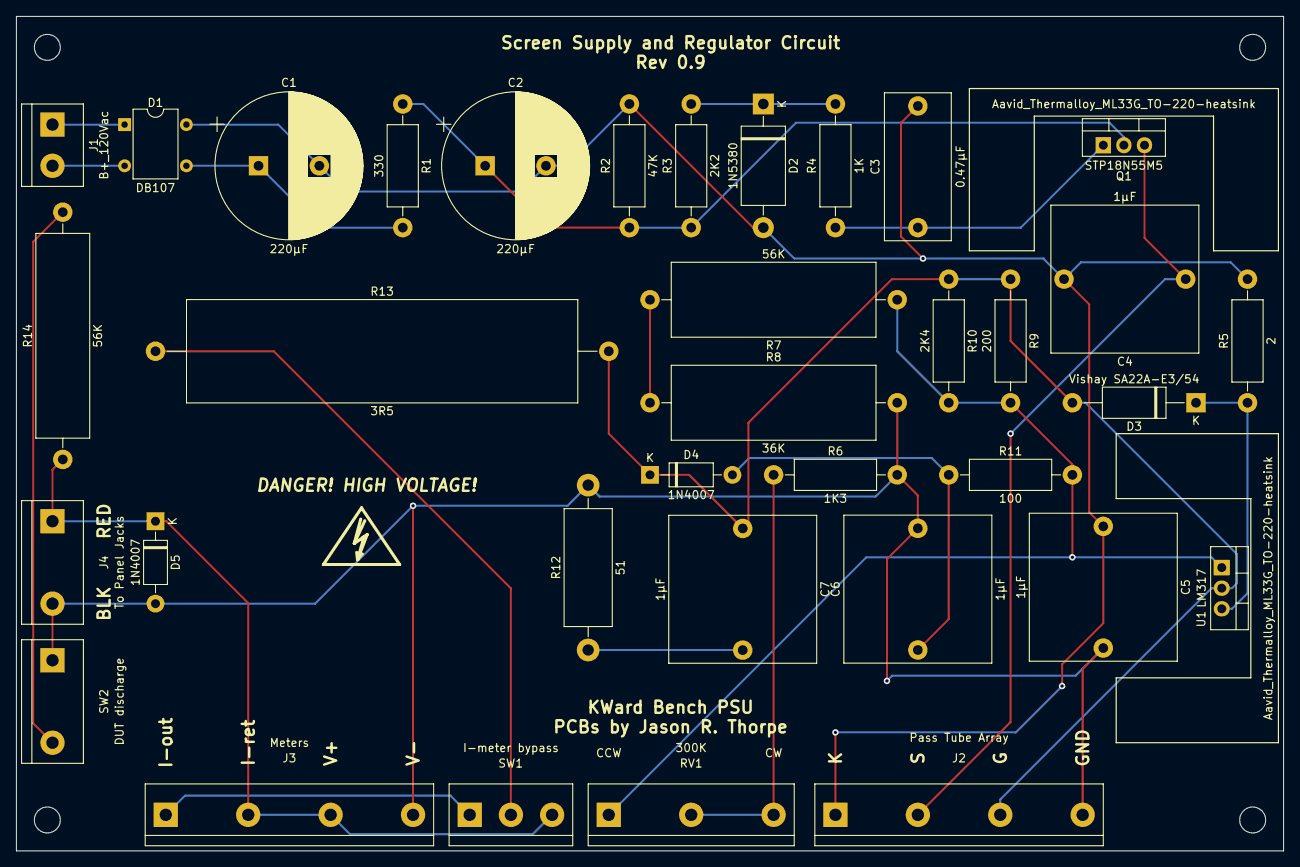
[picture p29: board screen-supply-and-regulator.kicad_pcb from above]

Board: 2 copper layers, 156.2 x 102.9 mm, 35 parts (0 on the bottom side), 20 nets.
