thorpej/Electronics/Power_Supplies/RPI_Remote_Power_Controller/RPI_Remote_Power_Controller.kicad_pcb

## KiCad design Power_Supplies/RPI_Remote_Power_Controller/RPI_Remote_Power_Controller.kicad_pcb (2022-01-09)

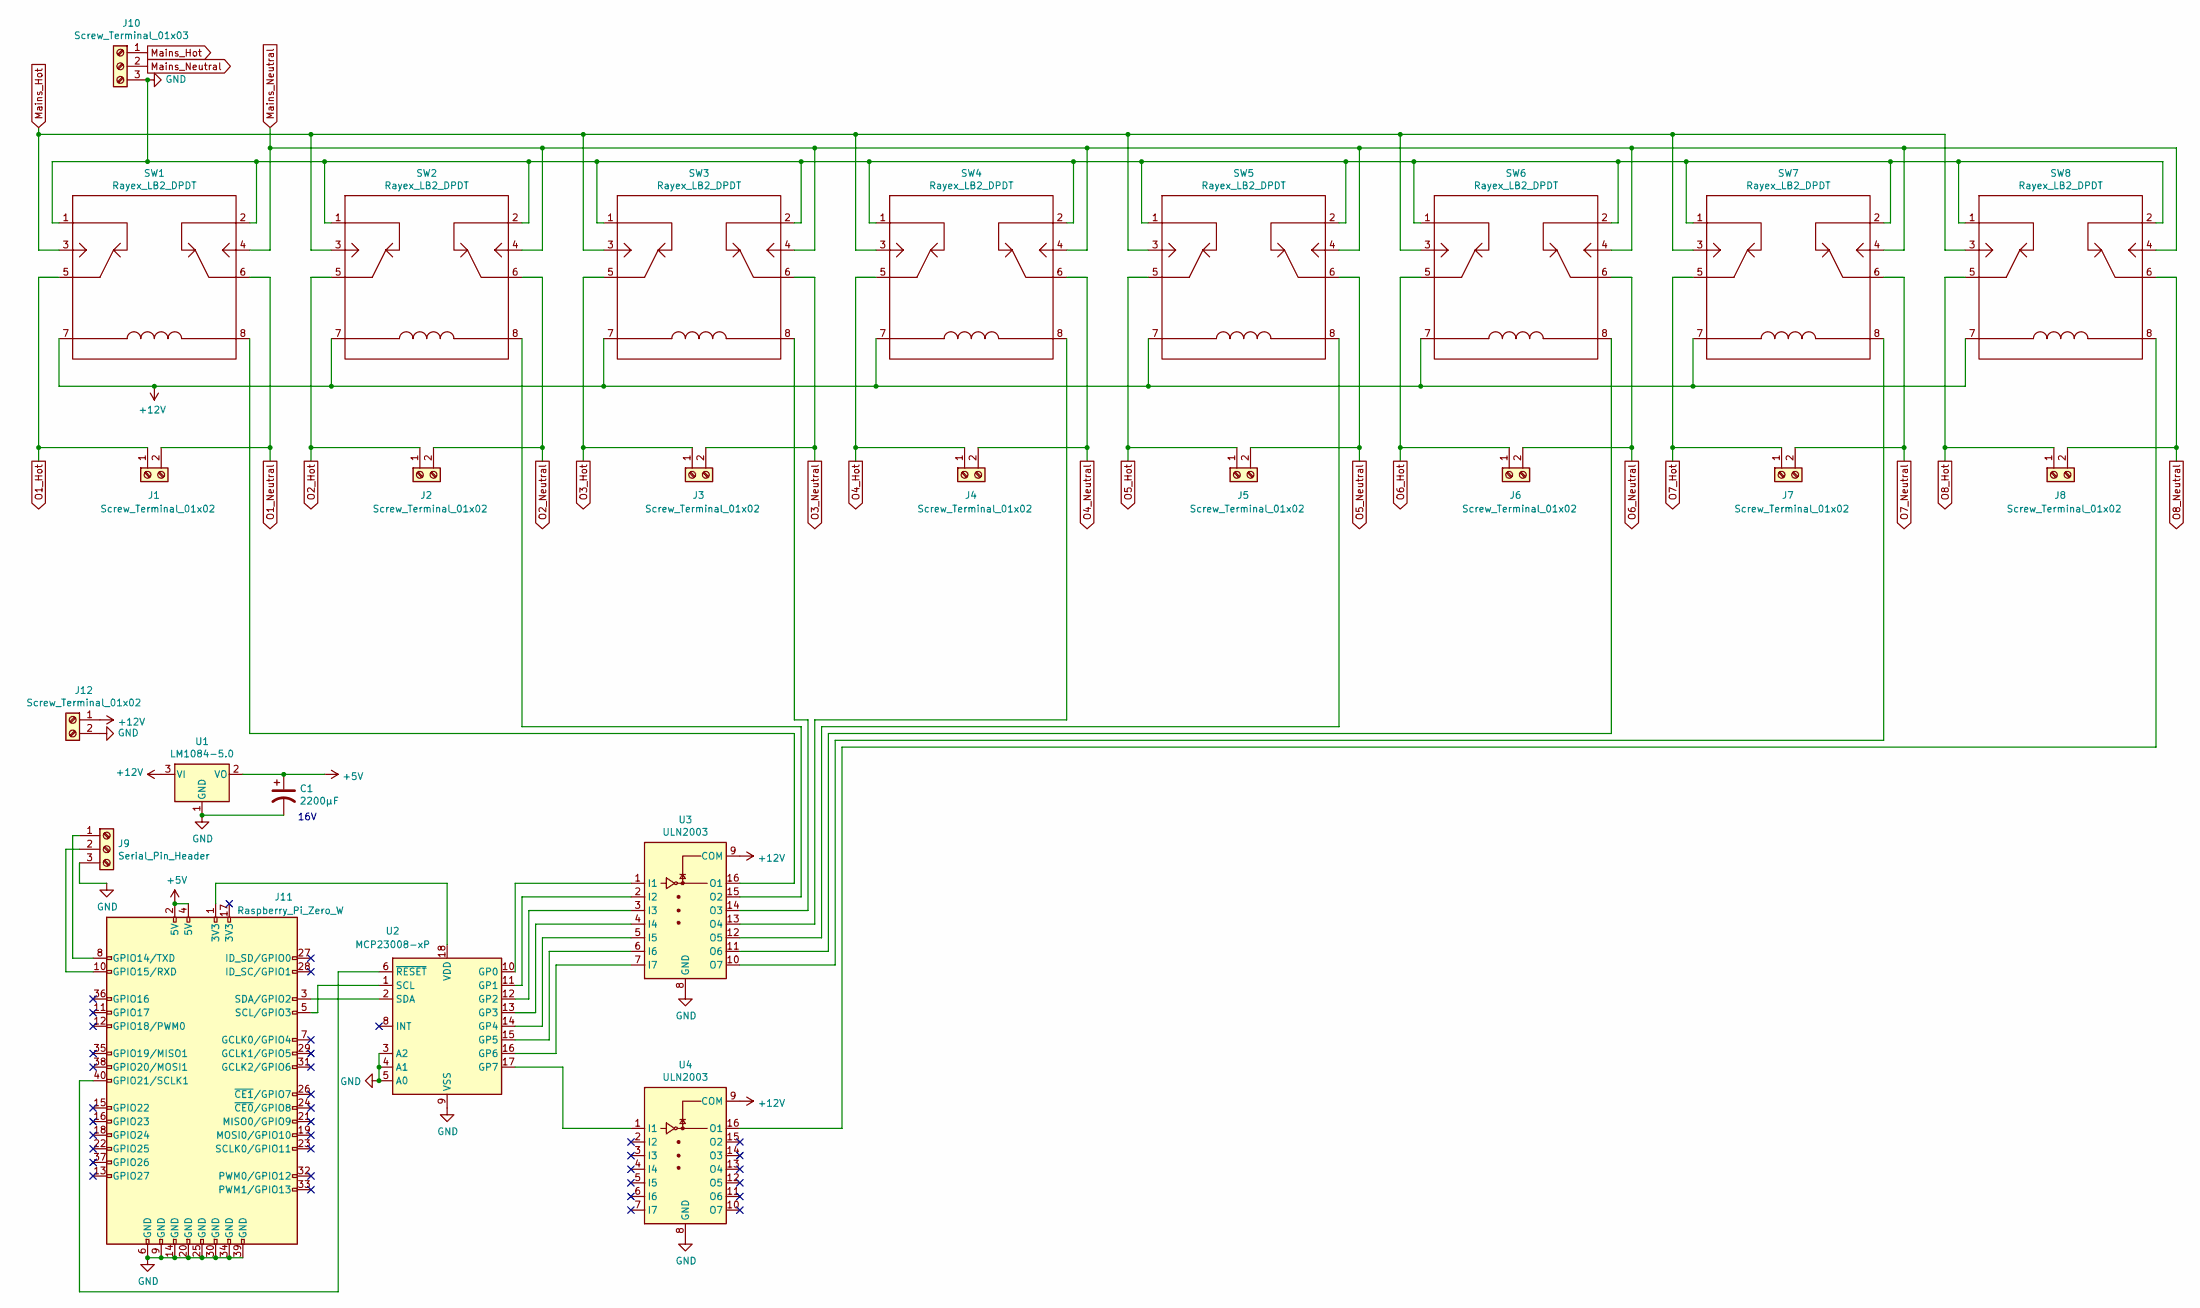
[picture p30: schematic RPI_Remote_Power_Controller.sch, RPI Remote Power Controller]

Parts:
C1: 2200µF; CP_Radial_D13.0mm_P5.00mm; Mouser 710-860040378015
J1, J2, J3, J4, J5, J6, J7, J8: Screw_Terminal_01x02; TE_AMP-2_P10.16mm
J9: Serial_Pin_Header; PinHeader_1x03_P2.54mm_Vertical
J10: Screw_Terminal_01x03; TE_AMP-3_P10.16mm
J11: Raspberry_Pi_Zero_W; PinHeader_2x20_P2.54mm_Vertical
J12: Screw_Terminal_01x02; TerminalBlock_bornier-2_P5.08mm
SW1, SW2, SW3, SW4, SW5, SW6, SW7, SW8: Rayex_LB2_DPDT; Rayex-LB2-lug
U1: LM1084-5.0; TO-220-3_Vertical
U2: MCP23008-xP; DIP-18_W7.62mm_Socket
U3, U4: ULN2003; DIP-16_W7.62mm_Socket

Connections:
+5V: C1.1, J11.2 (5V), J11.4 (5V), U1.2 (VO)
+12V: J12.1, SW1.7, SW2.7, SW3.7, SW4.7, SW5.7, SW6.7, SW7.7, SW8.7, U1.3 (VI), U3.9 (COM), U4.9 (COM)
GND: C1.2, J9.3, J10.3, J11.6 (GND), J11.9 (GND), J11.14 (GND), J11.20 (GND), J11.25 (GND), J11.30 (GND), J11.34 (GND), J11.39 (GND), J12.2, SW1.1, SW1.2, SW2.1, SW2.2, SW3.1, SW3.2, SW4.1, SW4.2, SW5.1, SW5.2, SW6.1, SW6.2, SW7.1, SW7.2, SW8.1, SW8.2, U1.1 (GND), U2.3 (A2), U2.4 (A1), U2.5 (A0), U2.9 (VSS), U3.8 (GND), U4.8 (GND)
Mains_Hot: J10.1, SW1.3, SW2.3, SW3.3, SW4.3, SW5.3, SW6.3, SW7.3, SW8.3
Mains_Neutral: J10.2, SW1.4, SW2.4, SW3.4, SW4.4, SW5.4, SW6.4, SW7.4, SW8.4
unnamed: J11.1 (3V3), U2.18 (VDD)
unnamed: J11.3 (SDA/GPIO2), U2.2 (SDA)
unnamed: J11.5 (SCL/GPIO3), U2.1 (SCL)
unnamed: J9.1, J11.8 (GPIO14/TXD)
unnamed: J9.2, J11.10 (GPIO15/RXD)
unnamed: J11.40 (GPIO21/SCLK1), U2.6 (~RESET)
unnamed: SW1.8, U3.16 (O1)
unnamed: SW2.8, U3.15 (O2)
unnamed: SW3.8, U3.14 (O3)
unnamed: SW4.8, U3.13 (O4)
unnamed: SW5.8, U3.12 (O5)
unnamed: SW6.8, U3.11 (O6)
unnamed: SW7.8, U3.10 (O7)
unnamed: SW8.8, U4.16 (O1)
unnamed: U2.10 (GP0), U3.1 (I1)
unnamed: U2.11 (GP1), U3.2 (I2)
unnamed: U2.12 (GP2), U3.3 (I3)
unnamed: U2.13 (GP3), U3.4 (I4)
unnamed: U2.14 (GP4), U3.5 (I5)
unnamed: U2.15 (GP5), U3.6 (I6)
unnamed: U2.16 (GP6), U3.7 (I7)
unnamed: U2.17 (GP7), U4.1 (I1)
O1_Hot: J1.1, SW1.5
O1_Neutral: J1.2, SW1.6
O2_Hot: J2.1, SW2.5
O2_Neutral: J2.2, SW2.6
O3_Hot: J3.1, SW3.5
O3_Neutral: J3.2, SW3.6
O4_Hot: J4.1, SW4.5
O4_Neutral: J4.2, SW4.6
O5_Hot: J5.1, SW5.5
O5_Neutral: J5.2, SW5.6
O6_Hot: J6.1, SW6.5
O6_Neutral: J6.2, SW6.6
O7_Hot: J7.1, SW7.5
O7_Neutral: J7.2, SW7.6
O8_Hot: J8.1, SW8.5
O8_Neutral: J8.2, SW8.6

Notes on the sheet:
16V

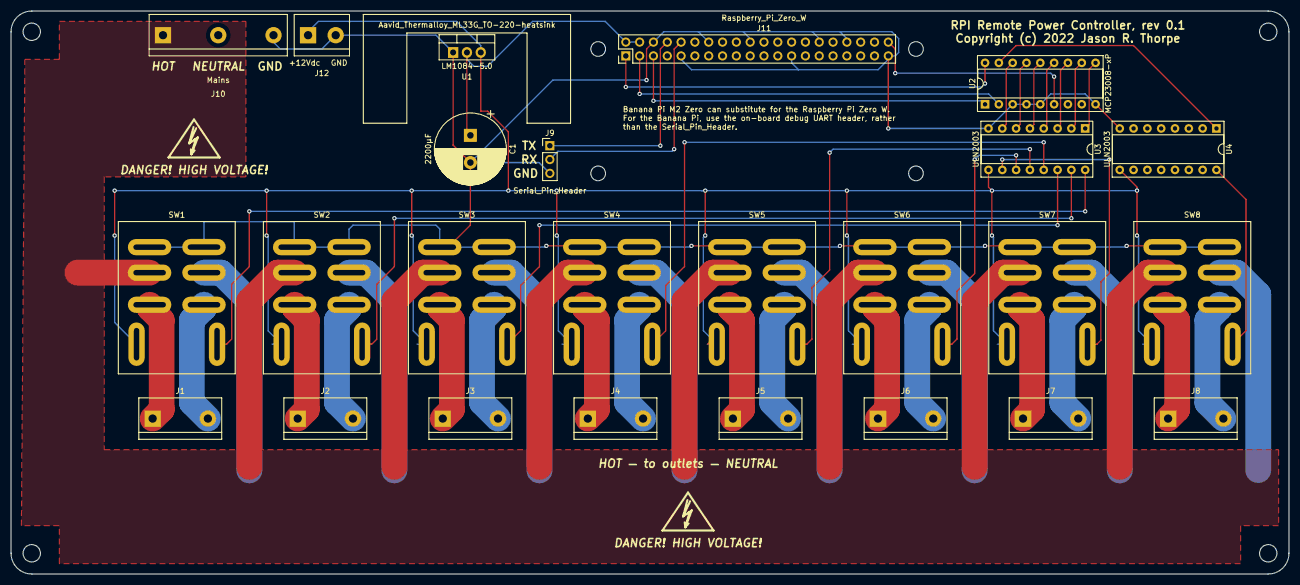
[picture p31: board RPI_Remote_Power_Controller.kicad_pcb from above]

Board: 2 copper layers, 234.9 x 103.5 mm, 25 parts (0 on the bottom side), 43 nets.
