thorpej/Electronics/Tube_Audio/Helper_Circuits/SnapInCapStack/SnapInCapStack.kicad_pcb

## KiCad design Tube_Audio/Helper_Circuits/SnapInCapStack/SnapInCapStack.kicad_pcb (2022-01-05)

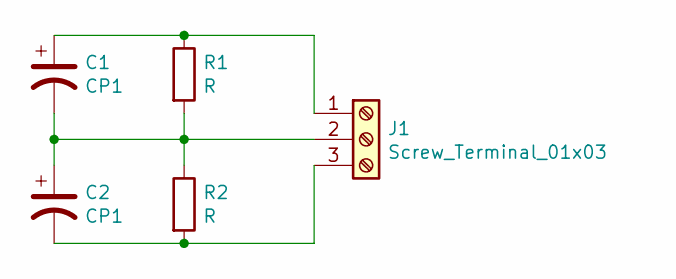
[picture p32: schematic SnapInCapStack.sch, Snap-in Capacitor Stack board]

Parts:
C1, C2: CP1; CP_Radial_D35.0mm_P10.00mm_3pin_SnapIn
J1: Screw_Terminal_01x03; TE_AMP-3_P10.16mm
R1, R2: R; R_Axial_DIN0414_L11.9mm_D4.5mm_P5.08mm_Vertical

Connections:
unnamed: C1.1, J1.1, R1.1
unnamed: C1.2, C2.1, J1.2, R1.2, R2.1
unnamed: C2.2, J1.3, R2.2

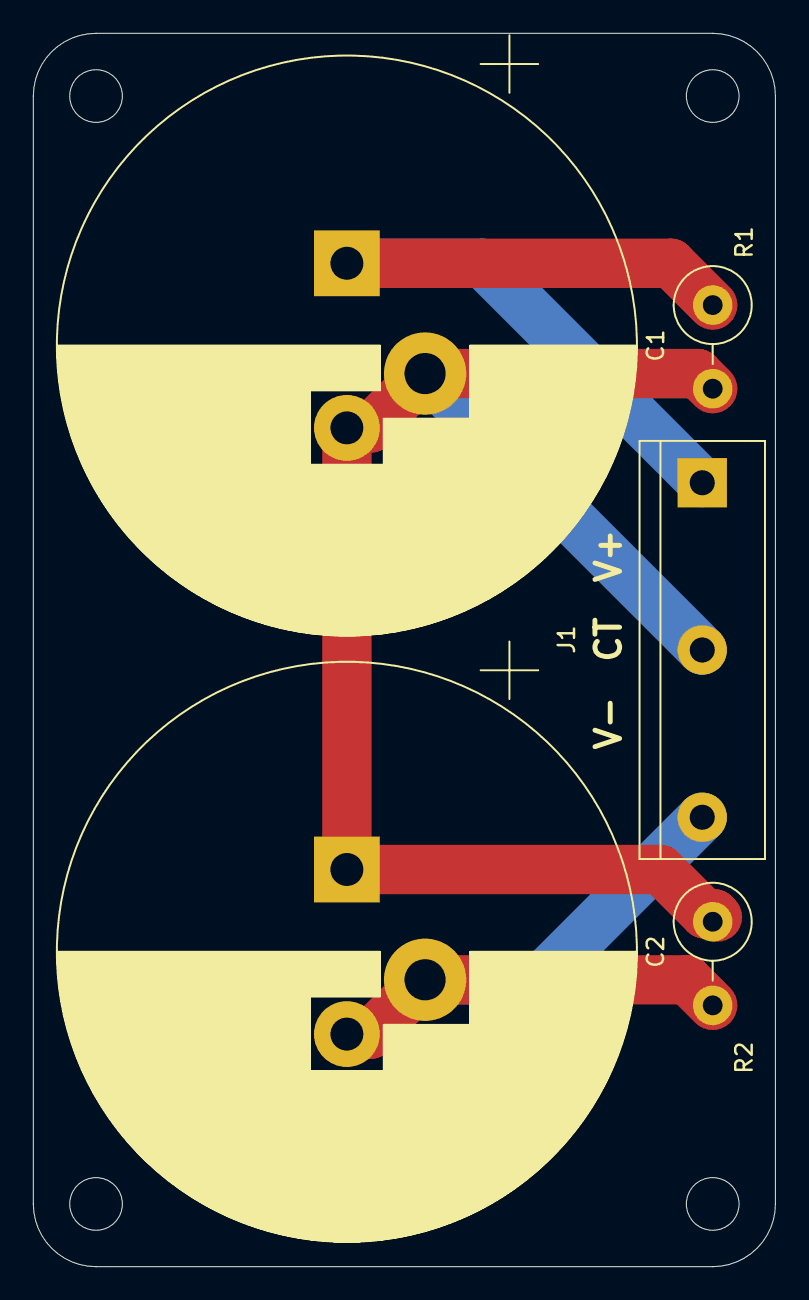
[picture p33: board SnapInCapStack.kicad_pcb from above]

Board: 2 copper layers, 45.1 x 74.9 mm, 5 parts (0 on the bottom side), 3 nets.
