thorpej/Electronics/Tube_Audio/Helper_Circuits/9A_9AJ_Heater_Helper/9A_9AJ_Heater_Helper.kicad_pcb

## KiCad design Tube_Audio/Helper_Circuits/9A_9AJ_Heater_Helper/9A_9AJ_Heater_Helper.kicad_pcb (2022-01-05)

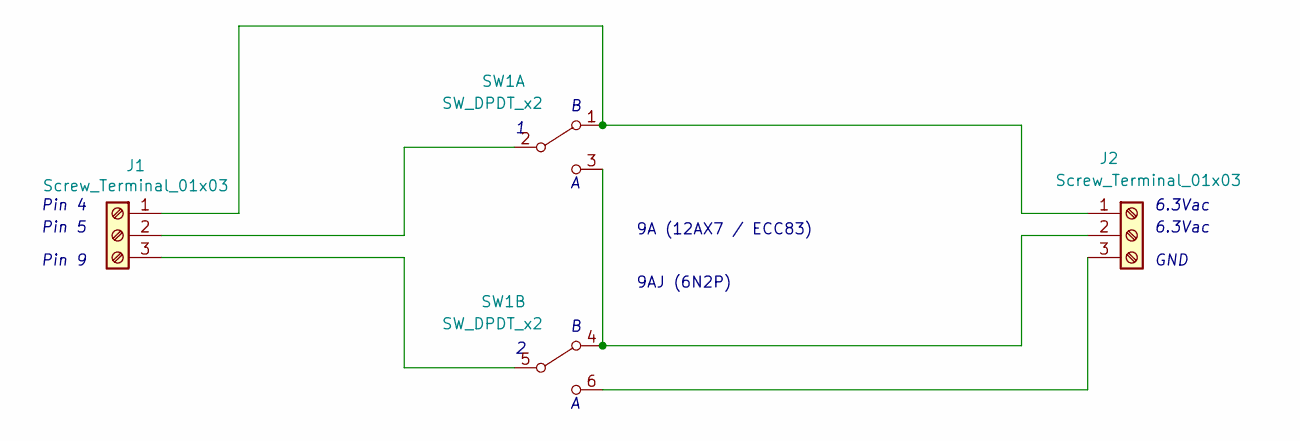
[picture p34: schematic 9A_9AJ_Heater_Helper.sch, 9A / 9AJ Heater Helper]

Parts:
J1, J2: Screw_Terminal_01x03; TerminalBlock_bornier-3_P5.08mm
SW1: SW_DPDT_x2; SW_SPDT_CandK-V80212MS02Q; Part C&K V80212MS02Q

Connections:
unnamed: J1.1, J2.1, SW1.1 (A)
unnamed: J1.2, SW1.2 (B)
unnamed: J1.3, SW1.5 (B)
unnamed: J2.2, SW1.3 (C), SW1.4 (A)
unnamed: J2.3, SW1.6 (C)

Notes on the sheet:
9A (12AX7 / ECC83) 9AJ (6N2P)
Pin 4
Pin 5
Pin 9
GND
6.3Vac

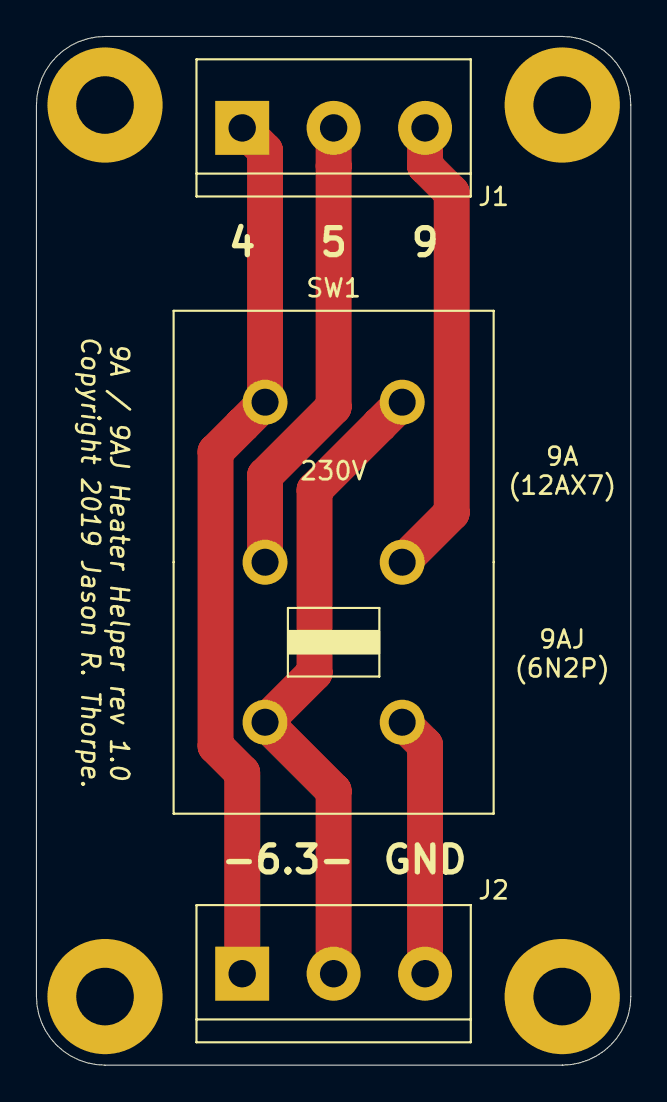
[picture p35: board 9A_9AJ_Heater_Helper.kicad_pcb from above]

Board: 2 copper layers, 33.0 x 57.2 mm, 3 parts (0 on the bottom side), 5 nets.
