thorpej/Electronics/Power_Supplies/KWard_Adjustable_Bench_Power_Supply/design-files/pass-tube-array/pass-tube-array.kicad_pcb

## KiCad design Power_Supplies/KWard_Adjustable_Bench_Power_Supply/design-files/pass-tube-array/pass-tube-array.kicad_pcb (2022-01-05)

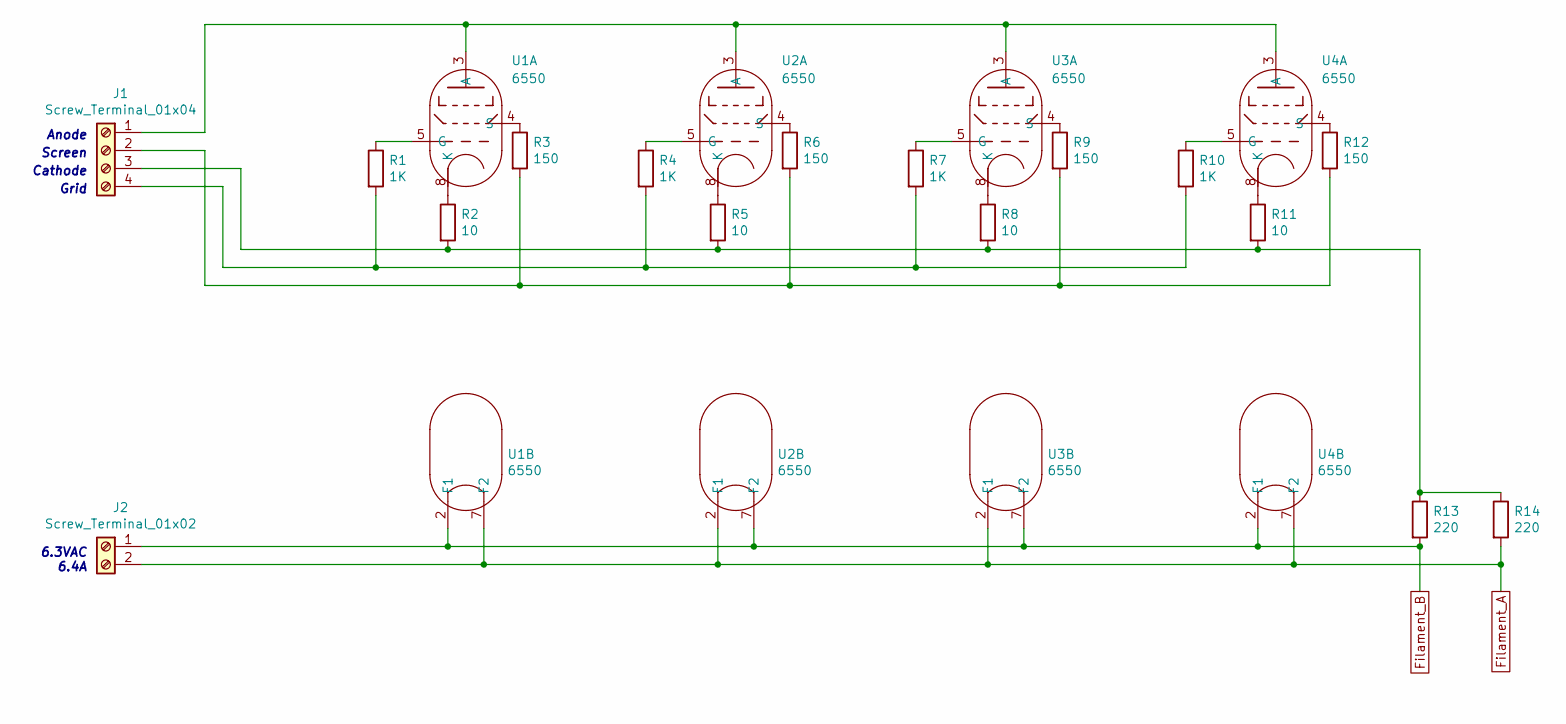
[picture p36: schematic pass-tube-array.sch, KWard Bench PSU - Pass tube array]

Parts:
J1: Screw_Terminal_01x04; TE_AMP-4_P10.16mm
J2: Screw_Terminal_01x02; TerminalBlock_bornier-2_P5.08mm
R1, R4, R7, R10: 1K; R_Axial_DIN0411_L9.9mm_D3.6mm_P15.24mm_Horizontal; Mouser 594-5083NW1K000J
R2, R5, R8, R11: 10; R_Axial_DIN0411_L9.9mm_D3.6mm_P15.24mm_Horizontal; Mouser 594-5083NW10R00J
R3, R6, R9, R12: 150; R_Axial_DIN0411_L9.9mm_D3.6mm_P15.24mm_Horizontal; Mouser 594-5083NW150R0J
R13, R14: 220; R_Axial_DIN0411_L9.9mm_D3.6mm_P15.24mm_Horizontal; Mouser 594-5083NW220R0J
U1, U2, U3, U4: 6550; AES_P-ST8-193_Octal_T14

Connections:
Filament_A: J2.2, R14.2, U1.7 (F2), U2.2 (F1), U3.2 (F1), U4.7 (F2)
Filament_B: J2.1, R13.2, U1.2 (F1), U2.7 (F2), U3.7 (F2), U4.2 (F1)
unnamed: J1.1, U1.3 (A), U2.3 (A), U3.3 (A), U4.3 (A)
unnamed: J1.2, R3.2, R6.2, R9.2, R12.2
unnamed: J1.3, R2.2, R5.2, R8.2, R11.2, R13.1, R14.1
unnamed: J1.4, R1.2, R4.2, R7.2, R10.2
unnamed: R1.1, U1.5 (G)
unnamed: R2.1, U1.8 (K)
unnamed: R3.1, U1.4 (S)
unnamed: R4.1, U2.5 (G)
unnamed: R5.1, U2.8 (K)
unnamed: R6.1, U2.4 (S)
unnamed: R7.1, U3.5 (G)
unnamed: R8.1, U3.8 (K)
unnamed: R9.1, U3.4 (S)
unnamed: R10.1, U4.5 (G)
unnamed: R11.1, U4.8 (K)
unnamed: R12.1, U4.4 (S)

Notes on the sheet:
Anode
Screen
Grid
Cathode
6.3VAC 6.4A

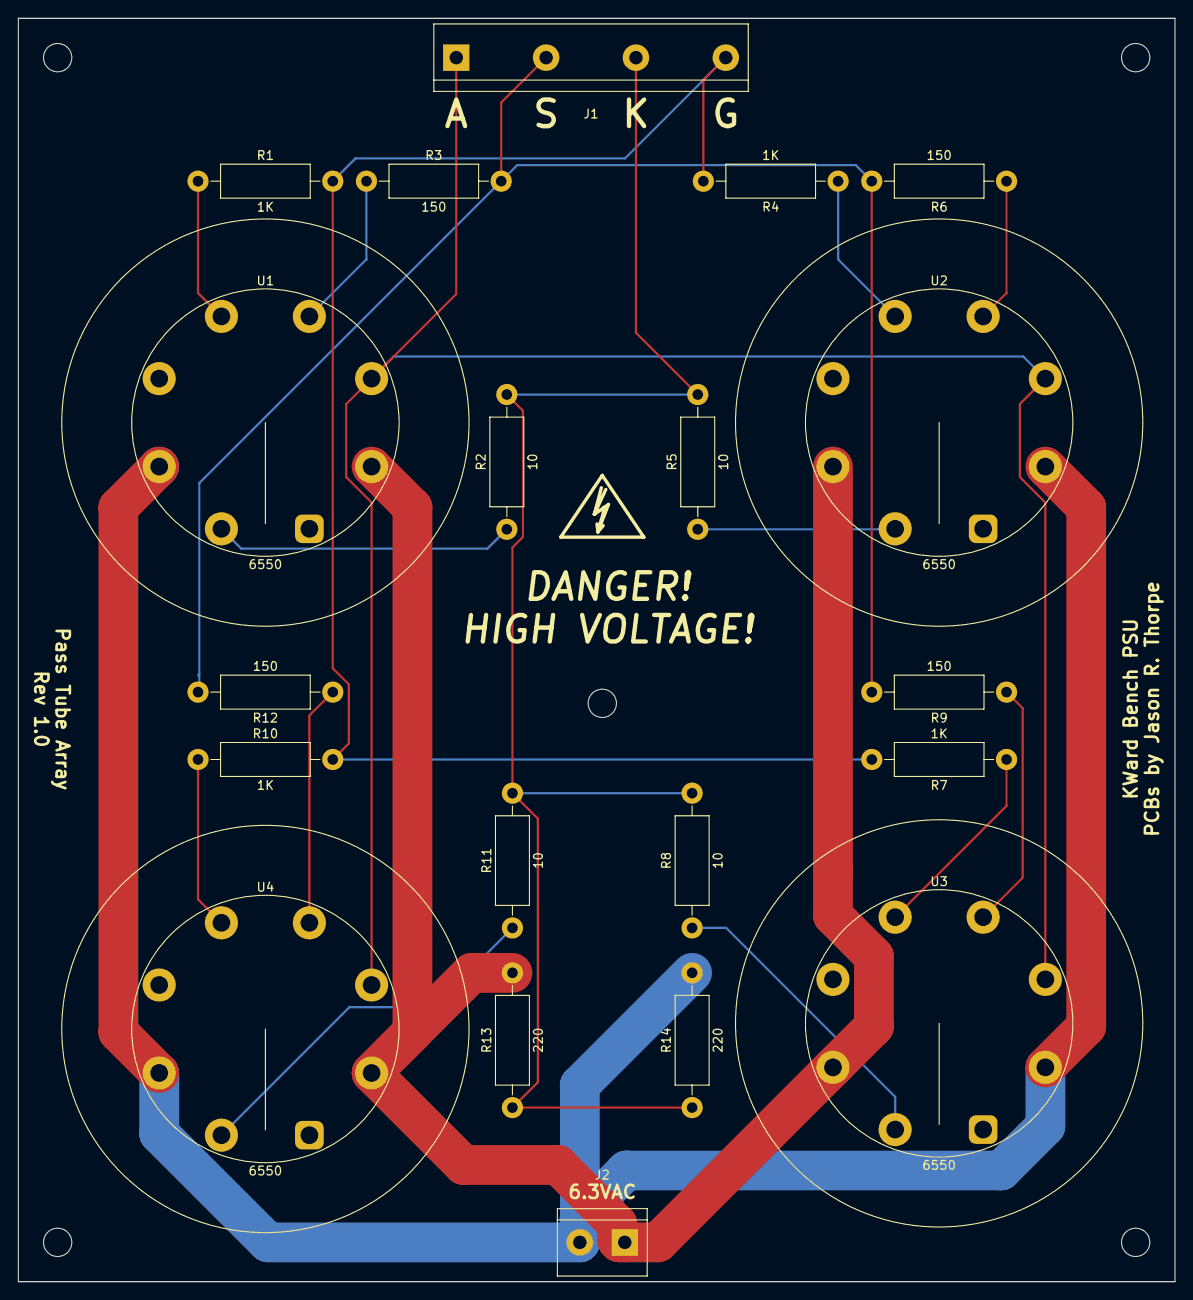
[picture p37: board pass-tube-array.kicad_pcb from above]

Board: 2 copper layers, 130.8 x 142.9 mm, 20 parts (0 on the bottom side), 18 nets.
