thorpej/Electronics/Power_Supplies/KWard_Adjustable_Bench_Power_Supply/design-files/panel-supply/panel-supply.kicad_pcb

## KiCad design Power_Supplies/KWard_Adjustable_Bench_Power_Supply/design-files/panel-supply/panel-supply.kicad_pcb (2022-01-02)

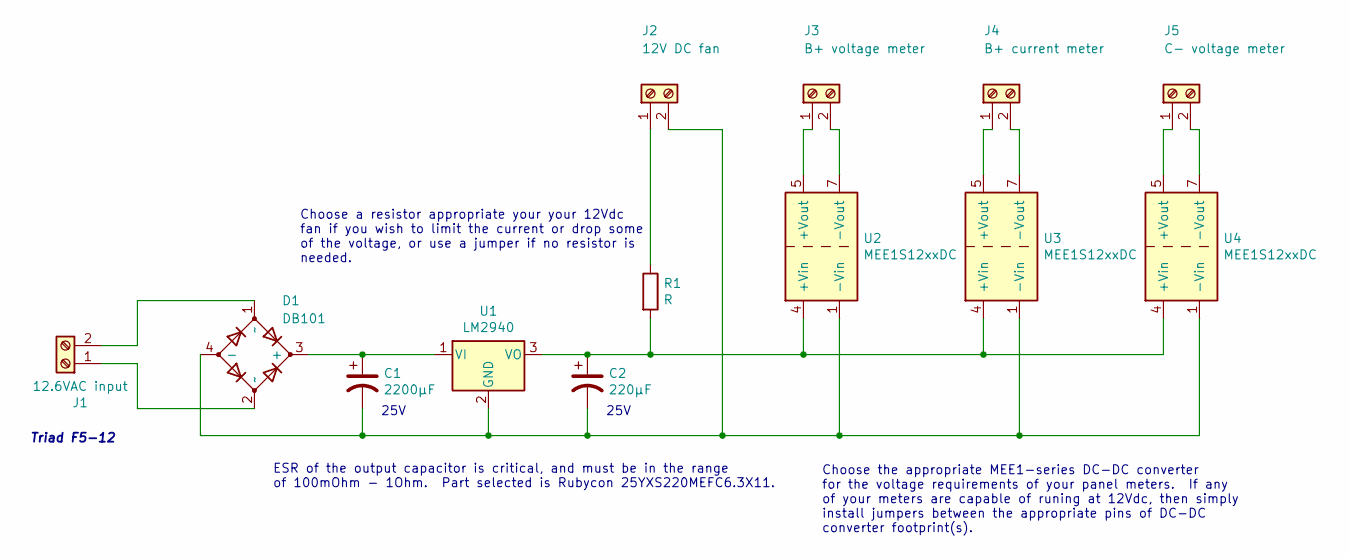
[picture p38: schematic panel-supply.sch, KWard Bench PSU - Panel meter supply]

Parts:
C1: 2200µF; CP_Radial_D12.5mm_P5.00mm; Mouser 555-RJH-25V222MI9#
C2: 220µF; CP_Radial_D6.3mm_P2.50mm; Mouser 232-25YXS220MEFC63X1
D1: DB101; Diode_Bridge_DIP-4_W7.62mm_P5.08mm; Mouser 583-DB101
J1: 12.6VAC input; TerminalBlock_TE_282834-2_1x02_P2.54mm_Horizontal
J2: 12V DC fan; TerminalBlock_TE_282834-2_1x02_P2.54mm_Horizontal
J3: B+ voltage meter; TerminalBlock_TE_282834-2_1x02_P2.54mm_Horizontal
J4: B+ current meter; TerminalBlock_TE_282834-2_1x02_P2.54mm_Horizontal
J5: C- voltage meter; TerminalBlock_TE_282834-2_1x02_P2.54mm_Horizontal
R1: R; R_Axial_DIN0309_L9.0mm_D3.2mm_P2.54mm_Vertical
U1: LM2940; TO-220-3_Vertical
U2, U3, U4: MEE1S12xxDC; DIP-8_W7.62mm

Connections:
unnamed: C1.1, D1.3 (+), U1.1 (VI)
unnamed: C1.2, C2.2, D1.4 (-), J2.2, U1.2 (GND), U2.1 (-Vin), U3.1 (-Vin), U4.1 (-Vin)
unnamed: C2.1, R1.2, U1.3 (VO), U2.4 (+Vin), U3.4 (+Vin), U4.4 (+Vin)
unnamed: D1.1 (~~), J1.2
unnamed: D1.2 (~~), J1.1
unnamed: J2.1, R1.1
unnamed: J3.1, U2.5 (+Vout)
unnamed: J3.2, U2.7 (-Vout)
unnamed: J4.1, U3.5 (+Vout)
unnamed: J4.2, U3.7 (-Vout)
unnamed: J5.1, U4.5 (+Vout)
unnamed: J5.2, U4.7 (-Vout)

Notes on the sheet:
25V
Choose the appropriate MEE1-series DC-DC converter for the voltage requirements of your panel meters. If any of your meters are capable of runing at 12Vdc, then simply install jumpers between the appropriate pins of DC-DC converter footprint(s).
Choose a resistor appropriate your your 12Vdc fan if you wish to limit the current or drop some of the voltage, or use a jumper if no resistor is needed.
ESR of the output capacitor is critical, and must be in the range of 100mOhm - 1Ohm. Part selected is Rubycon 25YXS220MEFC6.3X11.
Triad F5-12

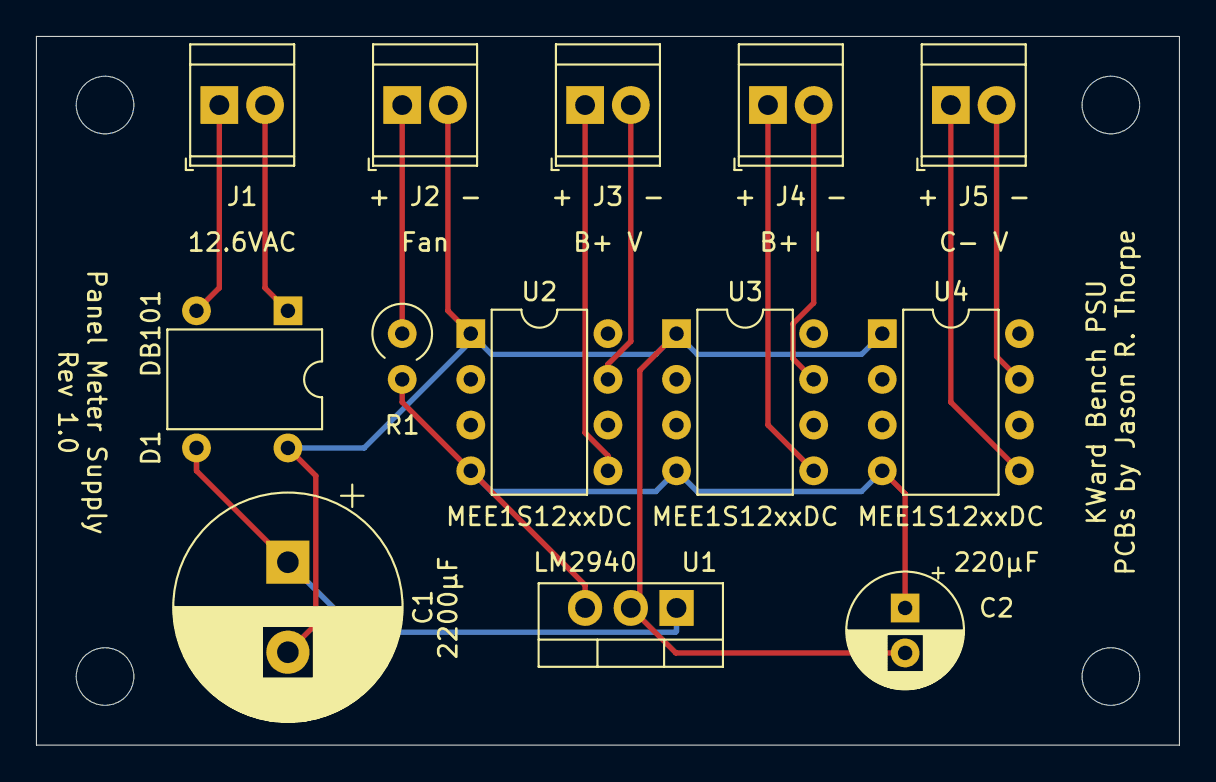
[picture p39: board panel-supply.kicad_pcb from above]

Board: 2 copper layers, 63.5 x 39.4 mm, 13 parts (0 on the bottom side), 12 nets.
