thorpej/Electronics/Power_Supplies/KWard_Adjustable_Bench_Power_Supply/design-files/bias-supply/bias-supply.kicad_pcb

## KiCad design Power_Supplies/KWard_Adjustable_Bench_Power_Supply/design-files/bias-supply/bias-supply.kicad_pcb (2022-01-02)

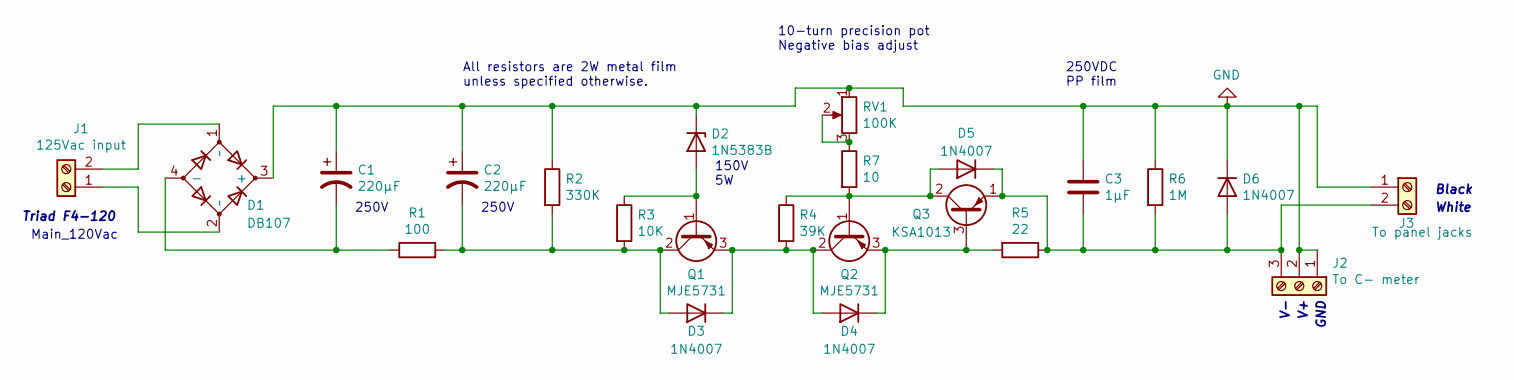
[picture p40: schematic bias-supply.sch, KWard Bench PSU - Bias supply]

Parts:
C1, C2: 220µF; CP_Radial_D18.0mm_P7.50mm; Mouser 647-UCS2E221MHD
C3: 1µF; C_Rect_L18.0mm_W11.0mm_P15.00mm_FKS3_FKP3; Mouser 871-B32672L2105J000
D1: DB107; Diode_Bridge_DIP-4_W7.62mm_P5.08mm
D2: 1N5383B; D_DO-201_P15.24mm_Horizontal; Mouser 863-1N5383BG
D3, D4, D5: 1N4007; D_DO-41_SOD81_P10.16mm_Horizontal
D6: 1N4007; D_DO-41_SOD81_P10.16mm_Horizontal; Mouser 621-1N4007G-T
J1: 125Vac input; TerminalBlock_bornier-2_P5.08mm
J2: To C- meter; TerminalBlock_bornier-3_P5.08mm
J3: To panel jacks; TerminalBlock_bornier-2_P5.08mm
Q1, Q2: MJE5731; TO-220-3_Vertical; Mouser 863-MJE5731G
Q3: KSA1013; TO-92L; Mouser 512-KSA1013YBU
R1: 100; R_Axial_DIN0411_L9.9mm_D3.6mm_P15.24mm_Horizontal; Mouser 594-5083NW100R0JA100
R2: 330K; R_Axial_DIN0411_L9.9mm_D3.6mm_P15.24mm_Horizontal; Mouser 594-5083NW330K0J
R3: 10K; R_Axial_DIN0411_L9.9mm_D3.6mm_P15.24mm_Horizontal; Mouser 594-5083NW10K00J
R4: 39K; R_Axial_DIN0411_L9.9mm_D3.6mm_P15.24mm_Horizontal; Mouser 594-5083NW39K00J
R5: 22; R_Axial_DIN0411_L9.9mm_D3.6mm_P15.24mm_Horizontal; Mouser 594-5083NW22R00J
R6: 1M; R_Axial_DIN0411_L9.9mm_D3.6mm_P15.24mm_Horizontal; Mouser 594-5083NW1M000F
R7: 10; R_Axial_DIN0309_L9.0mm_D3.2mm_P2.54mm_Vertical; Mouser 594-5083NW10R00J
RV1: 100K; TerminalBlock_bornier-3_P5.08mm

Connections:
GND: C1.1, C2.1, C3.1, D1.3 (+), D2.1 (K), D6.1 (K), J2.1, J2.2, J3.1, R2.1, R6.1, RV1.1
unnamed: C1.2, D1.4 (-), R1.1
unnamed: C2.2, D3.2 (A), Q1.2 (C), R1.2, R2.2, R3.2
unnamed: C3.2, D5.1 (K), D6.2 (A), J2.3, J3.2, Q3.1 (E), R5.1, R6.2
unnamed: D1.1 (~~), J1.2
unnamed: D1.2 (~~), J1.1
unnamed: D2.2 (A), Q1.1 (B), R3.1
unnamed: D3.1 (K), D4.2 (A), Q1.3 (E), Q2.2 (C), R4.2
unnamed: D4.1 (K), Q2.3 (E), Q3.3 (B), R5.2
unnamed: D5.2 (A), Q2.1 (B), Q3.2 (C), R4.1, R7.2
unnamed: R7.1, RV1.2, RV1.3

Notes on the sheet:
250V
150V 5W
10-turn precision pot Negative bias adjust
250VDC PP film
White
Black
All resistors are 2W metal film unless specified otherwise.
Triad F4-120
Main_120Vac
GND

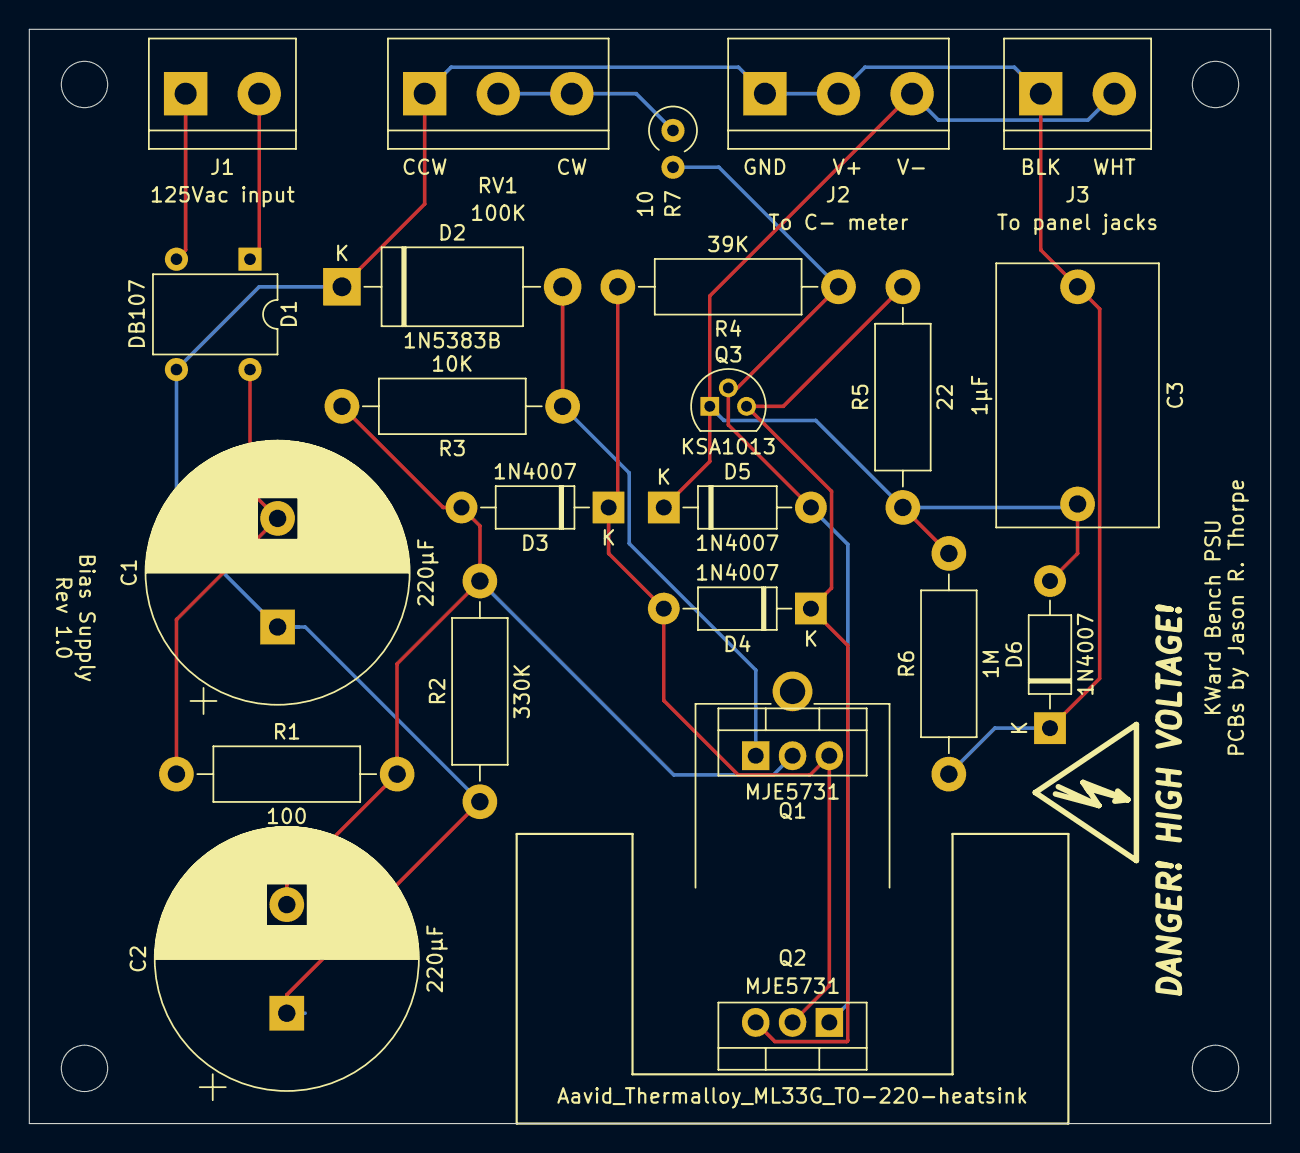
[picture p41: board bias-supply.kicad_pcb from above]

Board: 2 copper layers, 85.7 x 75.6 mm, 24 parts (0 on the bottom side), 11 nets.

Other parts of the board:
**REF: Aavid_Thermalloy_ML33G_TO-220-heatsink
