thorpej/Electronics/Misc_Audio/RAdLib/RAdLib.kicad_pcb

## KiCad design Misc_Audio/RAdLib/RAdLib.kicad_pcb (2019-10-31)

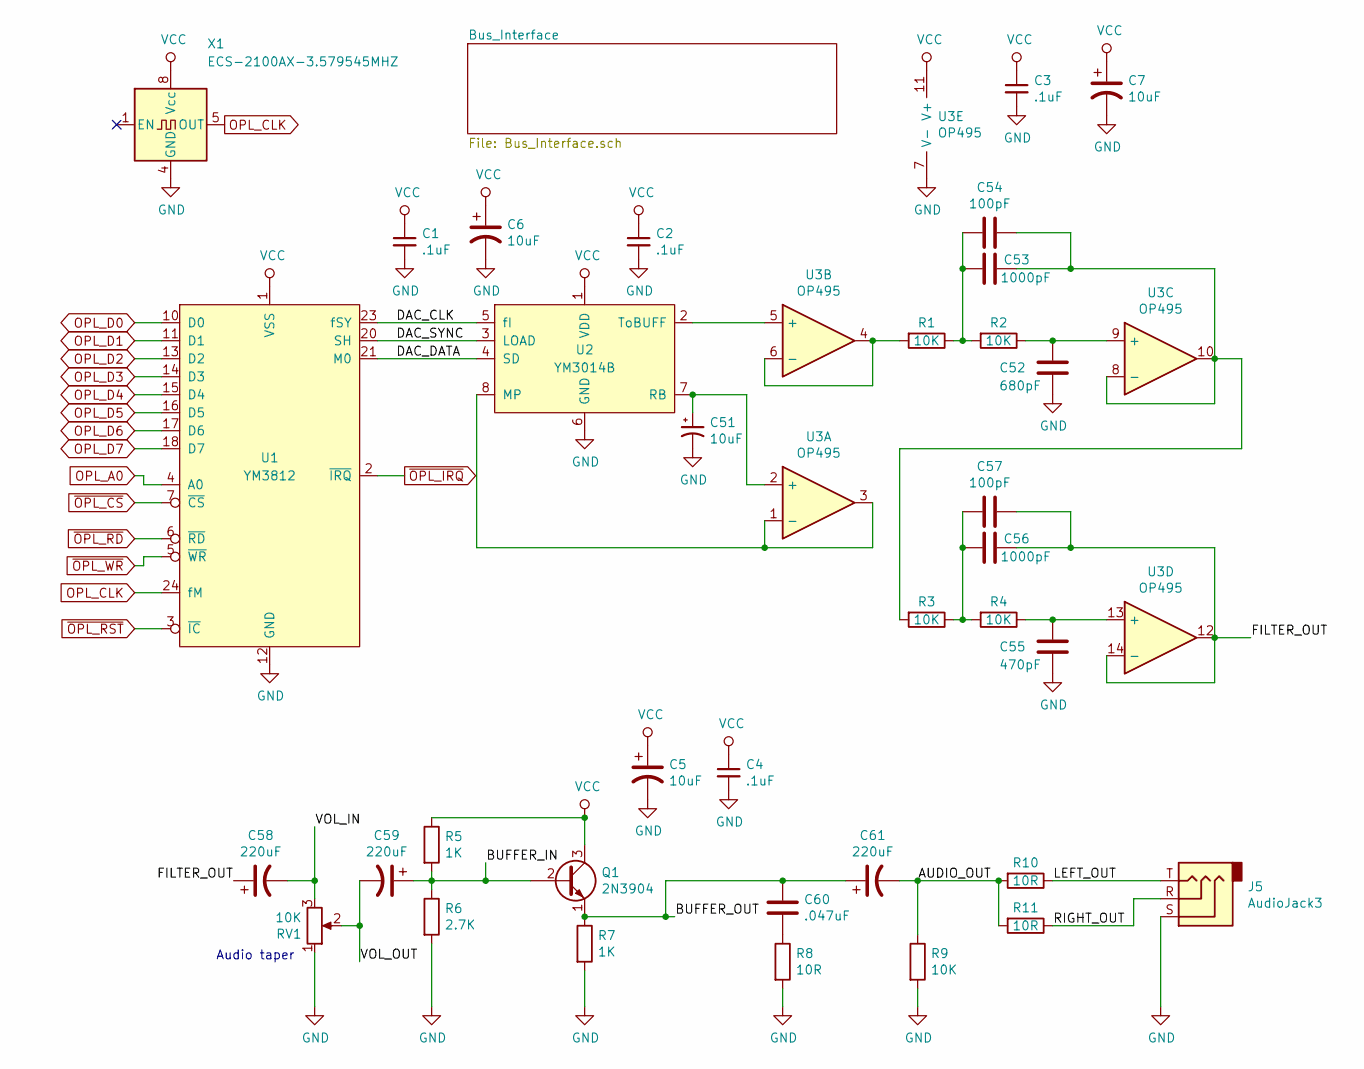
[picture p42: schematic RAdLib.sch, RAdLib - OPL2 FM Synthesizer for Raspberry Pi]

Parts:
C1, C2, C3, C4: .1uF; C_Disc_D5.0mm_W2.5mm_P2.50mm
C5, C6, C7: 10uF; CP_Radial_D5.0mm_P2.50mm
C51: 10uF; CP_Radial_D5.0mm_P2.50mm; Part AVX TAP106K016SCS
C52: 680pF; C_Disc_D5.0mm_W2.5mm_P2.50mm
C53, C56: 1000pF; C_Disc_D5.0mm_W2.5mm_P2.50mm
C54, C57: 100pF; C_Disc_D5.0mm_W2.5mm_P2.50mm
C55: 470pF; C_Disc_D5.0mm_W2.5mm_P2.50mm
C58, C59, C61: 220uF; CP_Axial_L18.0mm_D8.0mm_P25.00mm_Horizontal
C60: .047uF; C_Disc_D5.0mm_W2.5mm_P2.50mm
J5: AudioJack3; Jack_3.5mm_STX-3120-3B; Part Kycon STX-3120-3B-577C
Q1: 2N3904; TO-92_HandSolder
R1, R2, R3, R4, R9: 10K; R_Axial_DIN0204_L3.6mm_D1.6mm_P5.08mm_Horizontal
R5, R7: 1K; R_Axial_DIN0204_L3.6mm_D1.6mm_P5.08mm_Horizontal
R6: 2.7K; R_Axial_DIN0204_L3.6mm_D1.6mm_P5.08mm_Horizontal
R8, R10, R11: 10R; R_Axial_DIN0204_L3.6mm_D1.6mm_P5.08mm_Horizontal
RV1: 10K; Potentiometer_Bourns_91A1x_A24; Part Bourns 91A1A-B24-D15L
U1: YM3812; DIP-24_W15.24mm_Socket
U2: YM3014B; DIP-8_W7.62mm_Socket
U3: OP495; DIP-14_W7.62mm_Socket
X1: ECS-2100AX-3.579545MHZ; Oscillator_DIP-8; Part ECS-2100AX-3.579545MHZ

Connections:
+5V: C1.1, C2.1, C3.1, C4.1, C5.1, C6.1, C7.1, Q1.3 (C), R5.1, U1.1 (VSS), U2.1 (VDD), U3.11 (V+), X1.8 (Vcc); also elsewhere on the board
/AUDIO_OUT: C61.2, R9.1, R10.2, R11.2
/BUFFER_IN: C59.1, Q1.2 (B), R5.2, R6.1
/BUFFER_OUT: C60.1, C61.1, Q1.1 (E), R7.1
/DAC_CLK: U1.23 (fSY), U2.5 (fI)
/DAC_DATA: U1.21 (M0), U2.4 (SD)
/DAC_SYNC: U1.20 (SH), U2.3 (LOAD)
/FILTER_OUT: C56.1, C57.1, C58.1, U3.12, U3.14 (-)
/LEFT_OUT: J5.T, R10.1
/RIGHT_OUT: J5.R, R11.1
/VOL_IN: C58.2, RV1.3; also elsewhere on the board
/VOL_OUT: C59.2, RV1.2; also elsewhere on the board
GND: C1.2, C2.2, C3.2, C4.2, C5.2, C6.2, C7.2, C51.2, C52.2, C55.2, J5.S, R6.2, R7.2, R8.2, R9.2, RV1.1, U1.12 (GND), U2.6 (GND), U3.7 (V-), X1.4 (GND); also elsewhere on the board
unnamed: C51.1, U2.7 (RB), U3.2 (+)
unnamed: C52.1, R2.1, U3.9 (+)
unnamed: C53.1, C54.1, R3.2, U3.8 (-), U3.10
unnamed: C53.2, C54.2, R1.1, R2.2
unnamed: C55.1, R4.1, U3.13 (+)
unnamed: C56.2, C57.2, R3.1, R4.2
unnamed: C60.2, R8.1
unnamed: R1.2, U3.4, U3.6 (-)
unnamed: U2.2 (ToBUFF), U3.5 (+)
unnamed: U2.8 (MP), U3.1 (-), U3.3
OPL_A0: U1.4 (A0); also elsewhere on the board
OPL_CLK: U1.24 (fM), X1.5 (OUT)
OPL_D0: U1.10 (D0); also elsewhere on the board
OPL_D1: U1.11 (D1); also elsewhere on the board
OPL_D2: U1.13 (D2); also elsewhere on the board
OPL_D3: U1.14 (D3); also elsewhere on the board
OPL_D4: U1.15 (D4); also elsewhere on the board
OPL_D5: U1.16 (D5); also elsewhere on the board
OPL_D6: U1.17 (D6); also elsewhere on the board
OPL_D7: U1.18 (D7); also elsewhere on the board
~OPL_CS: U1.7 (~CS); also elsewhere on the board
~OPL_IRQ: U1.2 (~IRQ); also elsewhere on the board
~OPL_RD: U1.6 (~RD); also elsewhere on the board
~OPL_RST: U1.3 (~IC); also elsewhere on the board
~OPL_WR: U1.5 (~WR); also elsewhere on the board

Notes on the sheet:
Audio taper

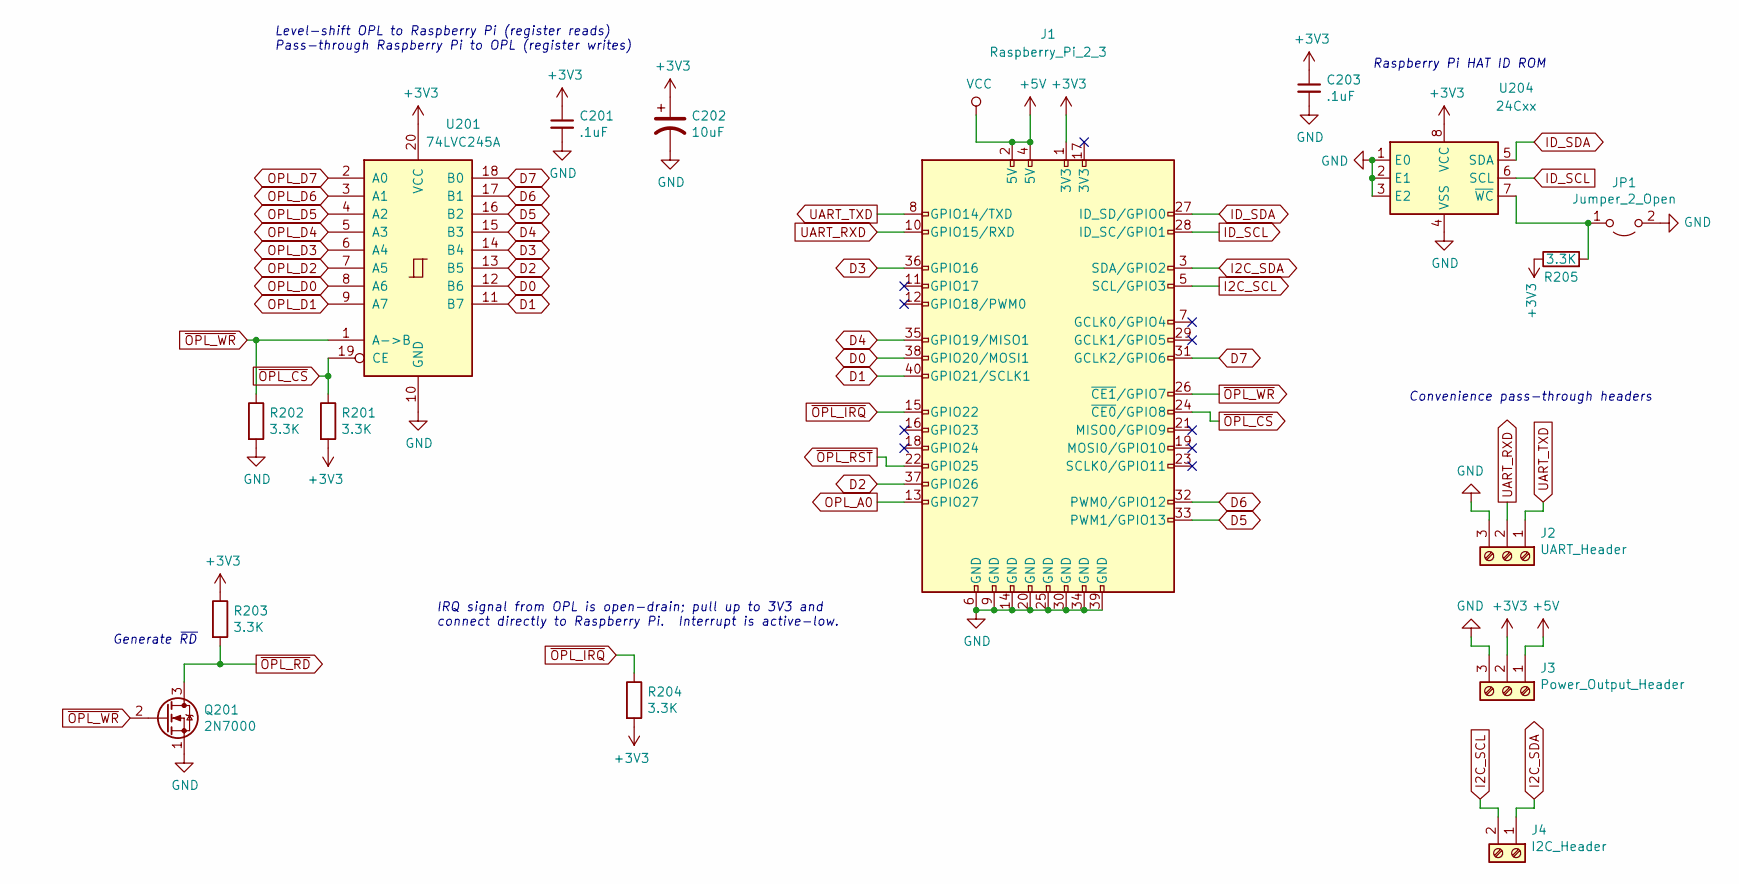
[picture p43: schematic Bus_Interface.sch, RAdLib - OPL2 FM Synthesizer for Raspberry Pi]

Parts:
C201, C203: .1uF; C_Disc_D5.0mm_W2.5mm_P2.50mm
C202: 10uF; CP_Radial_D5.0mm_P2.50mm
J1: Raspberry_Pi_2_3; PinHeader_2x20_P2.54mm_Vertical
J2: UART_Header; PinHeader_1x03_P2.54mm_Vertical
J3: Power_Output_Header; PinHeader_1x03_P2.54mm_Vertical
J4: I2C_Header; PinHeader_1x02_P2.54mm_Vertical
JP1: Jumper_2_Open; PinHeader_1x02_P2.54mm_Vertical
Q201: 2N7000; TO-92_HandSolder
R201, R202, R204: 3.3K; R_Axial_DIN0204_L3.6mm_D1.6mm_P5.08mm_Horizontal; Part Xicon 270-3.3K/REEL-RC
R203, R205: 3.3K; R_Axial_DIN0204_L3.6mm_D1.6mm_P5.08mm_Horizontal
U201: 74LVC245A; DIP-20_W7.62mm
U204: 24Cxx; DIP-8_W7.62mm_Socket

Connections:
+3V3: C201.1, C202.1, C203.1, J1.1 (3V3), J3.2, R201.2, R203.1, R204.2, R205.1, U201.20 (VCC), U204.8 (VCC)
+5V: J1.2 (5V), J1.4 (5V), J3.1; also elsewhere on the board
D0: J1.38 (GPIO20/MOSI1), U201.12 (B6)
D1: J1.40 (GPIO21/SCLK1), U201.11 (B7)
D2: J1.37 (GPIO26), U201.13 (B5)
D3: J1.36 (GPIO16), U201.14 (B4)
D4: J1.35 (GPIO19/MISO1), U201.15 (B3)
D5: J1.33 (PWM1/GPIO13), U201.16 (B2)
D6: J1.32 (PWM0/GPIO12), U201.17 (B1)
D7: J1.31 (GCLK2/GPIO6), U201.18 (B0)
GND: C201.2, C202.2, C203.2, J1.6 (GND), J1.9 (GND), J1.14 (GND), J1.20 (GND), J1.25 (GND), J1.30 (GND), J1.34 (GND), J1.39 (GND), J2.3, J3.3, JP1.2 (B), Q201.1 (S), R202.2, U201.10 (GND), U204.1 (E0), U204.2 (E1), U204.3 (E2), U204.4 (VSS); also elsewhere on the board
I2C_SCL: J1.5 (SCL/GPIO3), J4.2
I2C_SDA: J1.3 (SDA/GPIO2), J4.1
ID_SCL: J1.28 (ID_SC/GPIO1), U204.6 (SCL)
ID_SDA: J1.27 (ID_SD/GPIO0), U204.5 (SDA)
unnamed: JP1.1 (A), R205.2, U204.7 (~WC)
OPL_A0: J1.13 (GPIO27); also elsewhere on the board
OPL_D0: U201.8 (A6); also elsewhere on the board
OPL_D1: U201.9 (A7); also elsewhere on the board
OPL_D2: U201.7 (A5); also elsewhere on the board
OPL_D3: U201.6 (A4); also elsewhere on the board
OPL_D4: U201.5 (A3); also elsewhere on the board
OPL_D5: U201.4 (A2); also elsewhere on the board
OPL_D6: U201.3 (A1); also elsewhere on the board
OPL_D7: U201.2 (A0); also elsewhere on the board
UART_RXD: J1.10 (GPIO15/RXD), J2.2
UART_TXD: J1.8 (GPIO14/TXD), J2.1
~OPL_CS: J1.24 (~CE0~/GPIO8), R201.1, U201.19 (CE); also elsewhere on the board
~OPL_IRQ: J1.15 (GPIO22), R204.1; also elsewhere on the board
~OPL_RD: Q201.3 (D), R203.2; also elsewhere on the board
~OPL_RST: J1.22 (GPIO25); also elsewhere on the board
~OPL_WR: J1.26 (~CE1~/GPIO7), Q201.2 (G), R202.1, U201.1 (A->B); also elsewhere on the board

Notes on the sheet:
Level-shift OPL to Raspberry Pi (register reads) Pass-through Raspberry Pi to OPL (register writes)
Generate ~RD
Raspberry Pi HAT ID ROM
Convenience pass-through headers
IRQ signal from OPL is open-drain; pull up to 3V3 and connect directly to Raspberry Pi. Interrupt is active-low.

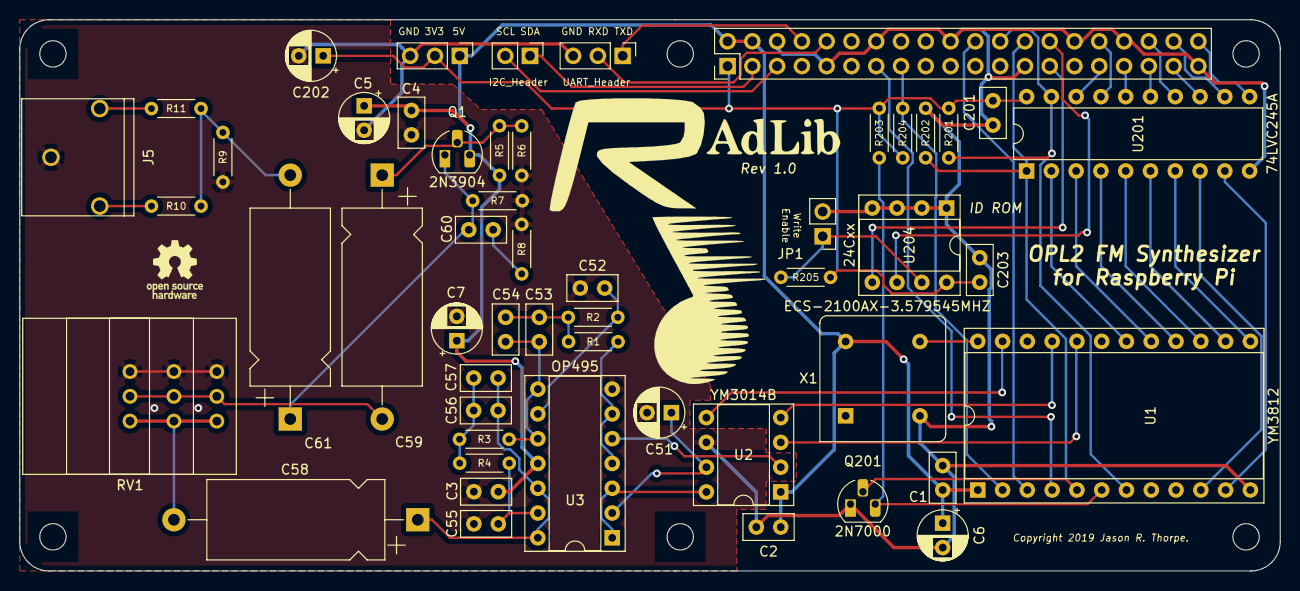
[picture p44: board RAdLib.kicad_pcb from above]

Board: 2 copper layers, 129.2 x 56.5 mm, 54 parts (0 on the bottom side), 54 nets.

Other parts of the board:
RV1#2, RV1#3: 10K; Potentiometer_Bourns_91A1x_A24

Their connections:
/VOL_IN: RV1#2.3, RV1#3.3; also elsewhere on the board
/VOL_OUT: RV1#2.2, RV1#3.2; also elsewhere on the board
GND: RV1#2.1, RV1#3.1; also elsewhere on the board
