thorpej/Electronics/Tube_Audio/Helper_Circuits/CCS_Load_x2/CCS_Load_x2.kicad_pcb

## KiCad design Tube_Audio/Helper_Circuits/CCS_Load_x2/CCS_Load_x2.kicad_pcb (2019-09-25)

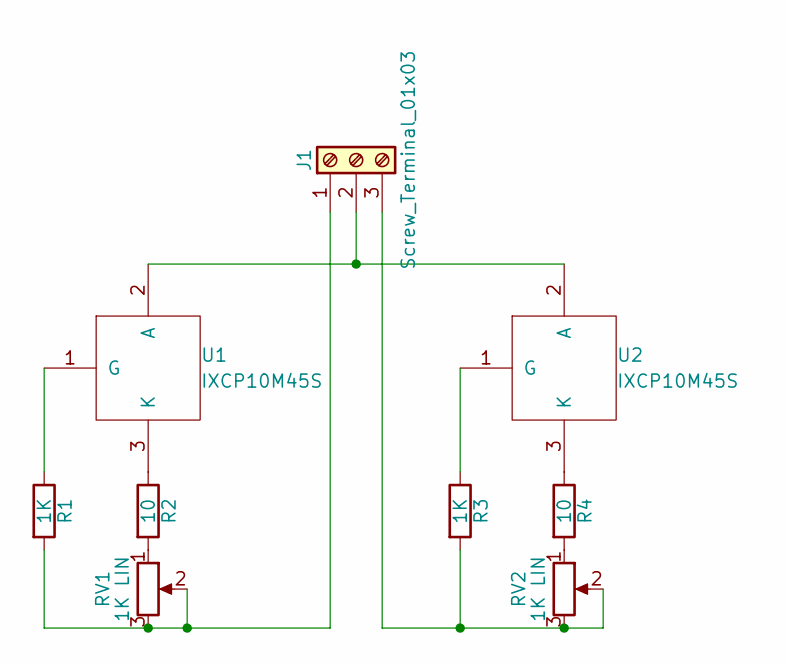
[picture p45: schematic CCS_Load_x2.sch, 2 Channel CCS Load]

Parts:
J1: Screw_Terminal_01x03; TerminalBlock_bornier-3_P5.08mm
R1, R3: 1K; R_Axial_DIN0414_L11.9mm_D4.5mm_P15.24mm_Horizontal
R2, R4: 10; R_Axial_DIN0414_L11.9mm_D4.5mm_P15.24mm_Horizontal
RV1, RV2: 1K LIN; Potentiometer_Bourns_3339P_Vertical_HandSoldering
U1, U2: IXCP10M45S; TO-220-3_Vertical

Connections:
unnamed: J1.1, R1.2, RV1.2, RV1.3
unnamed: J1.2, U1.2 (A), U2.2 (A)
unnamed: J1.3, R3.2, RV2.2, RV2.3
unnamed: R1.1, U1.1 (G)
unnamed: R2.1, U1.3 (K)
unnamed: R2.2, RV1.1
unnamed: R3.1, U2.1 (G)
unnamed: R4.1, U2.3 (K)
unnamed: R4.2, RV2.1

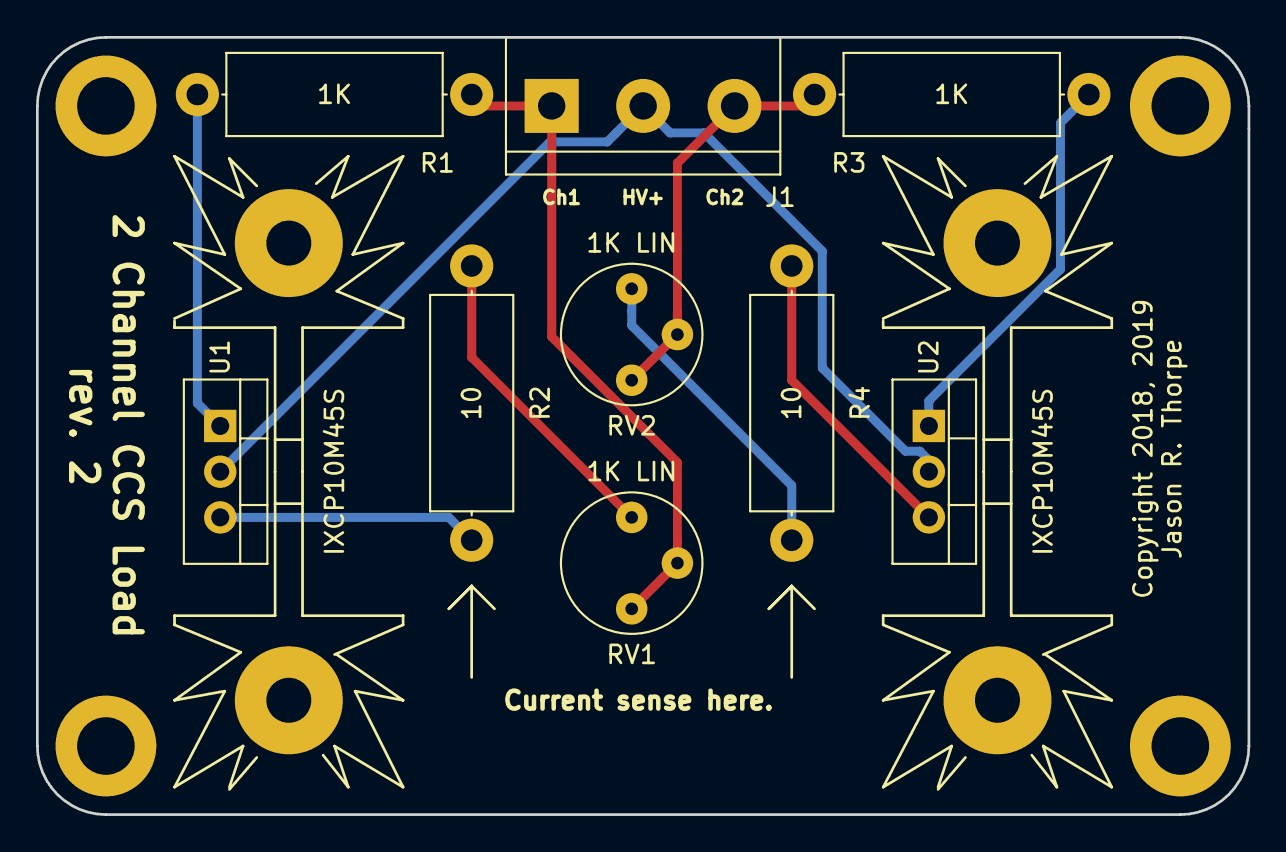
[picture p46: board CCS_Load_x2.kicad_pcb from above]

Board: 2 copper layers, 67.3 x 43.2 mm, 11 parts (0 on the bottom side), 9 nets.

Other parts of the board:
Sink1, Sink1#2: Heatsink_Fischer_SK104-STC-STIC_35x13mm_2xDrill2.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; Heatsink_Fischer_SK104-STC-STIC_35x13mm_2xDrill2.5mm
