thorpej/Electronics/Tube_Audio/6AS7_Pre_amp_Mk_I/STPre6080PCB.kicad_pcb

## KiCad design Tube_Audio/6AS7_Pre_amp_Mk_I/STPre6080PCB.kicad_pcb (2019-09-24)

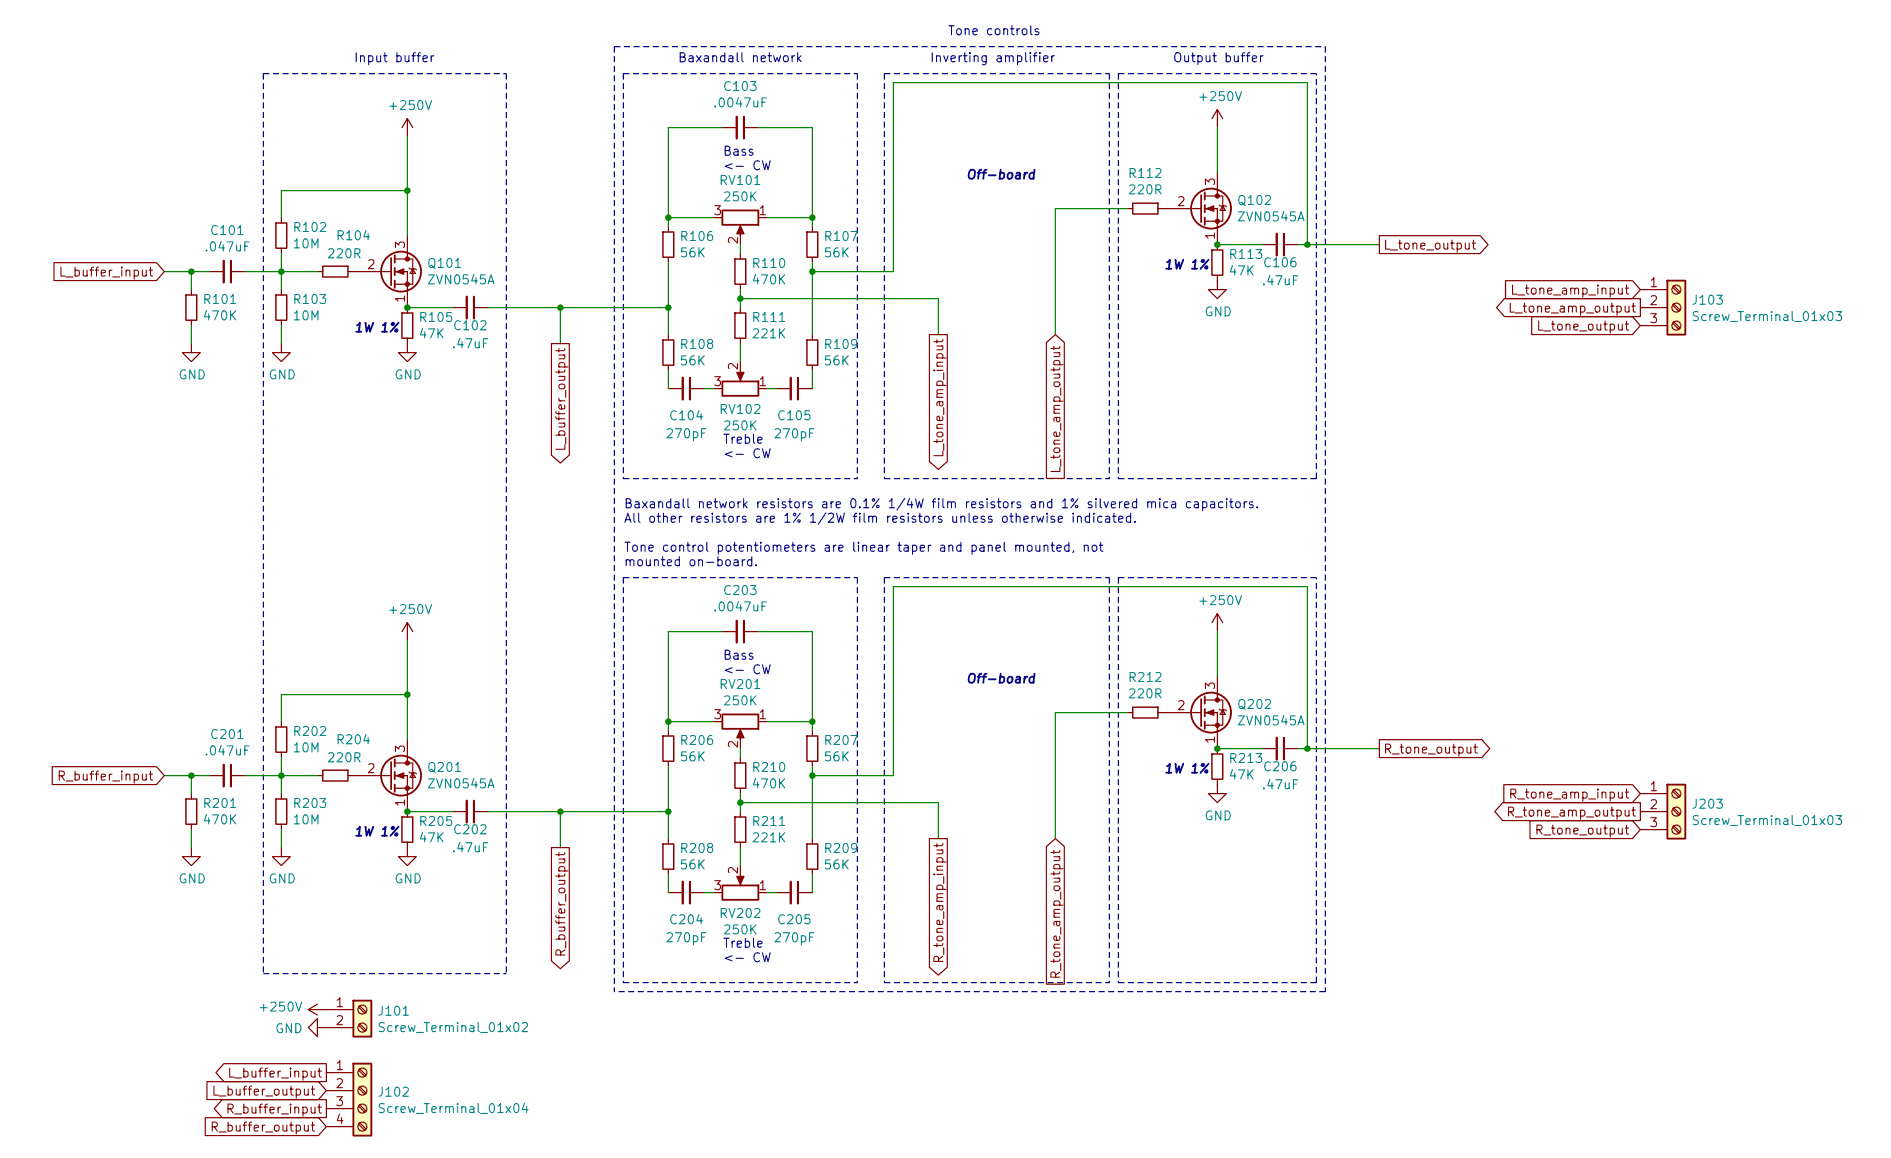
[picture p47: schematic STPre6080PCB.sch, 6AS7 Pre-amp Mk I PCB]

Parts:
C101, C201: .047uF; C_Rect_L13.0mm_W5.0mm_P7.50mm; Part Panasonic ECW-FD2J473J4
C102, C106, C202, C206: .47uF; C_Rect_L18.0mm_W8.0mm_P15.00mm_FKS3_FKP3; Part Panasonic ECW-FD2J474JC
C103, C203: .0047uF; C_Rect_L18.0mm_W9.0mm_P8.70mm; Part CDE CD19FD472FO3F
C104, C105, C204, C205: 270pF; C_Rect_L13.0mm_W6.0mm_P5.90mm; Part CDE CD15FD271FO3F
J101: Screw_Terminal_01x02; TerminalBlock_bornier-2_P5.08mm
J102: Screw_Terminal_01x04; TerminalBlock_bornier-4_P5.08mm
J103, J203: Screw_Terminal_01x03; TerminalBlock_bornier-3_P5.08mm
Q101, Q102, Q201, Q202: ZVN0545A; TO-92_Wide
R101, R201: 470K; R_Axial_DIN0414_L11.9mm_D4.5mm_P15.24mm_Horizontal; Part KOA Speer MF1/2DC4703F
R102, R202, R203: 10M; R_Axial_DIN0414_L11.9mm_D4.5mm_P15.24mm_Horizontal; Part Vishay HVR3700001005FR500
R103: 10M; R_Axial_DIN0414_L11.9mm_D4.5mm_P15.24mm_Horizontal; Part HVR3700001005FR500
R104, R112, R204, R212: 220R; R_Axial_DIN0414_L11.9mm_D4.5mm_P15.24mm_Horizontal
R105, R113, R205, R213: 47K; R_Axial_DIN0414_L11.9mm_D4.5mm_P15.24mm_Horizontal; Part TE H4P47KFZA
R106, R107, R108, R109, R206, R207, R208, R209: 56K; R_Axial_DIN0207_L6.3mm_D2.5mm_P10.16mm_Horizontal; Part TE H856KBDA
R110, R210: 470K; R_Axial_DIN0207_L6.3mm_D2.5mm_P10.16mm_Horizontal; Part TE H8470KBZA
R111, R211: 221K; R_Axial_DIN0207_L6.3mm_D2.5mm_P10.16mm_Horizontal; Part TE YR1B221KCC
RV101, RV102, RV201, RV202: 250K; PinHeader_1x03_P2.54mm_Vertical

Connections:
+250V: J101.1, Q101.3 (D), Q102.3 (D), Q201.3 (D), Q202.3 (D), R102.1, R202.1
GND: J101.2, R101.2, R103.2, R105.2, R113.2, R201.2, R203.2, R205.2, R213.2
L_buffer_input: C101.2, J102.1, R101.1
L_buffer_output: C102.1, J102.2, R106.2, R108.1
L_tone_amp_input: J103.1, R110.2, R111.1
L_tone_amp_output: J103.2, R112.2
L_tone_output: C106.1, J103.3, R107.2, R109.1
unnamed: C101.1, R102.2, R103.1, R104.2
unnamed: C102.2, Q101.1 (S), R105.1
unnamed: C103.1, R107.1, RV101.1
unnamed: C103.2, R106.1, RV101.3
unnamed: C104.1, RV102.3
unnamed: C104.2, R108.2
unnamed: C105.1, R109.2
unnamed: C105.2, RV102.1
unnamed: C106.2, Q102.1 (S), R113.1
unnamed: C201.1, R202.2, R203.1, R204.2
unnamed: C202.2, Q201.1 (S), R205.1
unnamed: C203.1, R207.1, RV201.1
unnamed: C203.2, R206.1, RV201.3
unnamed: C204.1, RV202.3
unnamed: C204.2, R208.2
unnamed: C205.1, R209.2
unnamed: C205.2, RV202.1
unnamed: C206.2, Q202.1 (S), R213.1
unnamed: Q101.2 (G), R104.1
unnamed: Q102.2 (G), R112.1
unnamed: Q201.2 (G), R204.1
unnamed: Q202.2 (G), R212.1
unnamed: R110.1, RV101.2
unnamed: R111.2, RV102.2
unnamed: R210.1, RV201.2
unnamed: R211.2, RV202.2
R_buffer_input: C201.2, J102.3, R201.1
R_buffer_output: C202.1, J102.4, R206.2, R208.1
R_tone_amp_input: J203.1, R210.2, R211.1
R_tone_amp_output: J203.2, R212.2
R_tone_output: C206.1, J203.3, R207.2, R209.1

Notes on the sheet:
Input buffer
Baxandall network resistors are 0.1% 1/4W film resistors and 1% silvered mica capacitors. All other resistors are 1% 1/2W film resistors unless otherwise indicated. Tone control potentiometers are linear taper and panel mounted, not mounted on-board.
Tone controls
Inverting amplifier
Baxandall network
Treble <- CW
Bass <- CW
Output buffer
Off-board
1W 1%

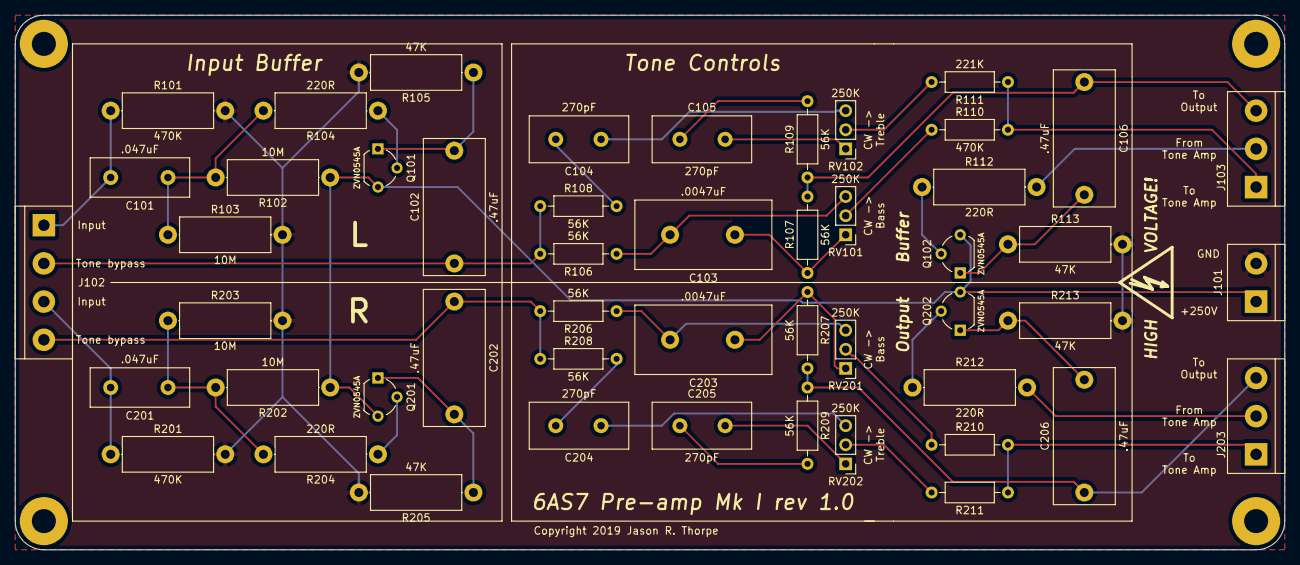
[picture p48: board STPre6080PCB.kicad_pcb from above]

Board: 2 copper layers, 168.9 x 71.1 mm, 50 parts (0 on the bottom side), 38 nets.
