thorpej/Electronics/Tube_Audio/6AS7_Pre_amp_Mk_I/STPre6080PSU.kicad_pcb

## KiCad design Tube_Audio/6AS7_Pre_amp_Mk_I/STPre6080PSU.kicad_pcb (2019-09-24)

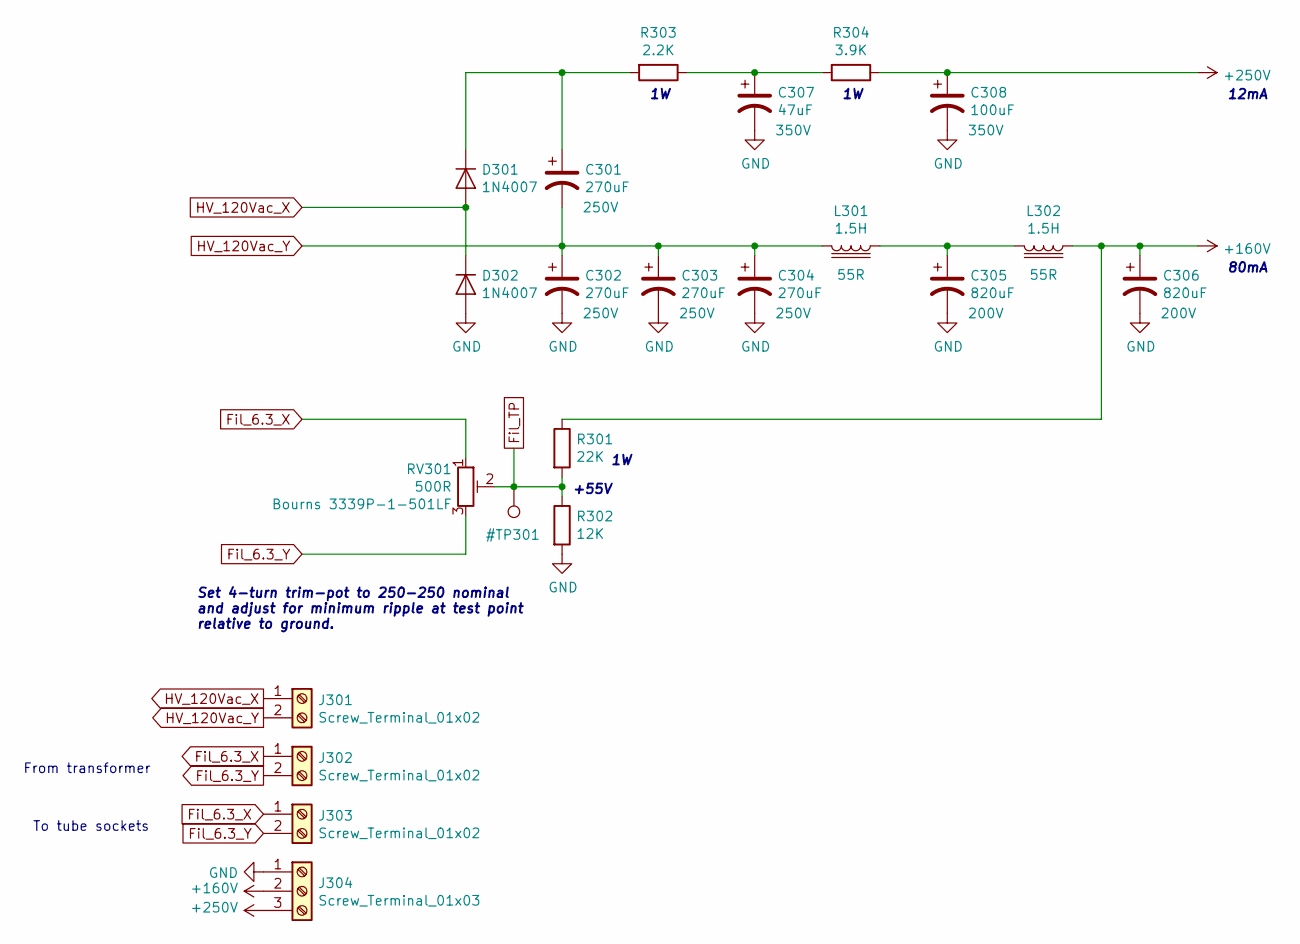
[picture p49: schematic STPre6080PSU.sch, 6AS7 Pre-amp Mk 1 power supply]

Parts:
C301, C302, C303, C304: 270uF; CP_Radial_D18.0mm_P7.50mm; Part Nichicon UCY2E271MHD
C305, C306: 820uF; CP_Radial_D25.0mm_P12.50mm; Part Nichicon UPT2D821MRD
C307: 47uF; CP_Radial_D12.5mm_P5.00mm; Part United Chemi-Con EGXF351ELL470MK30S
C308: 100uF; CP_Radial_D18.0mm_P7.50mm; Part Panasonic EEU-EB2V101
D301, D302: 1N4007; D_DO-41_SOD81_P10.16mm_Horizontal
J301, J302, J303: Screw_Terminal_01x02; TerminalBlock_bornier-2_P5.08mm
J304: Screw_Terminal_01x03; TerminalBlock_bornier-3_P5.08mm
L301, L302: 1.5H; TerminalBlock_bornier-2_P5.08mm; Part Triode C354
R301: 22K; R_Axial_DIN0207_L6.3mm_D2.5mm_P7.62mm_Horizontal; Part Vishay / BC PR01000102202JR500
R302: 12K; R_Axial_DIN0207_L6.3mm_D2.5mm_P7.62mm_Horizontal; Part Vishay / BC SFR16S0001202JA500
R303: 2.2K; R_Axial_DIN0207_L6.3mm_D2.5mm_P7.62mm_Horizontal; Part Vishay / BC PR01000102201JA100
R304: 3.9K; R_Axial_DIN0207_L6.3mm_D2.5mm_P7.62mm_Horizontal; Part Vishay / BC PR01000103901JR500
RV301: 500R; Potentiometer_Bourns_3339P_Vertical_HandSoldering; Part Bourns 3339P-1-501LF

Connections:
+160V: C306.1, J304.2, L302.1, R301.1
+250V: C308.1, J304.3, R304.1
Fil_6.3_X: J302.1, J303.1, RV301.1
Fil_6.3_Y: J302.2, J303.2, RV301.3
Fil_TP: R301.2, R302.1, RV301.2; also elsewhere on the board
GND: C302.2, C303.2, C304.2, C305.2, C306.2, C307.2, C308.2, D302.2 (A), J304.1, R302.2
HV_120Vac_X: D301.2 (A), D302.1 (K), J301.1
HV_120Vac_Y: C301.2, C302.1, C303.1, C304.1, J301.2, L301.2
unnamed: C301.1, D301.1 (K), R303.2
unnamed: C305.1, L301.1, L302.2
unnamed: C307.1, R303.1, R304.2

Notes on the sheet:
12mA
80mA
+55V
Set 4-turn trim-pot to 250-250 nominal and adjust for minimum ripple at test point relative to ground.
From transformer
To tube sockets

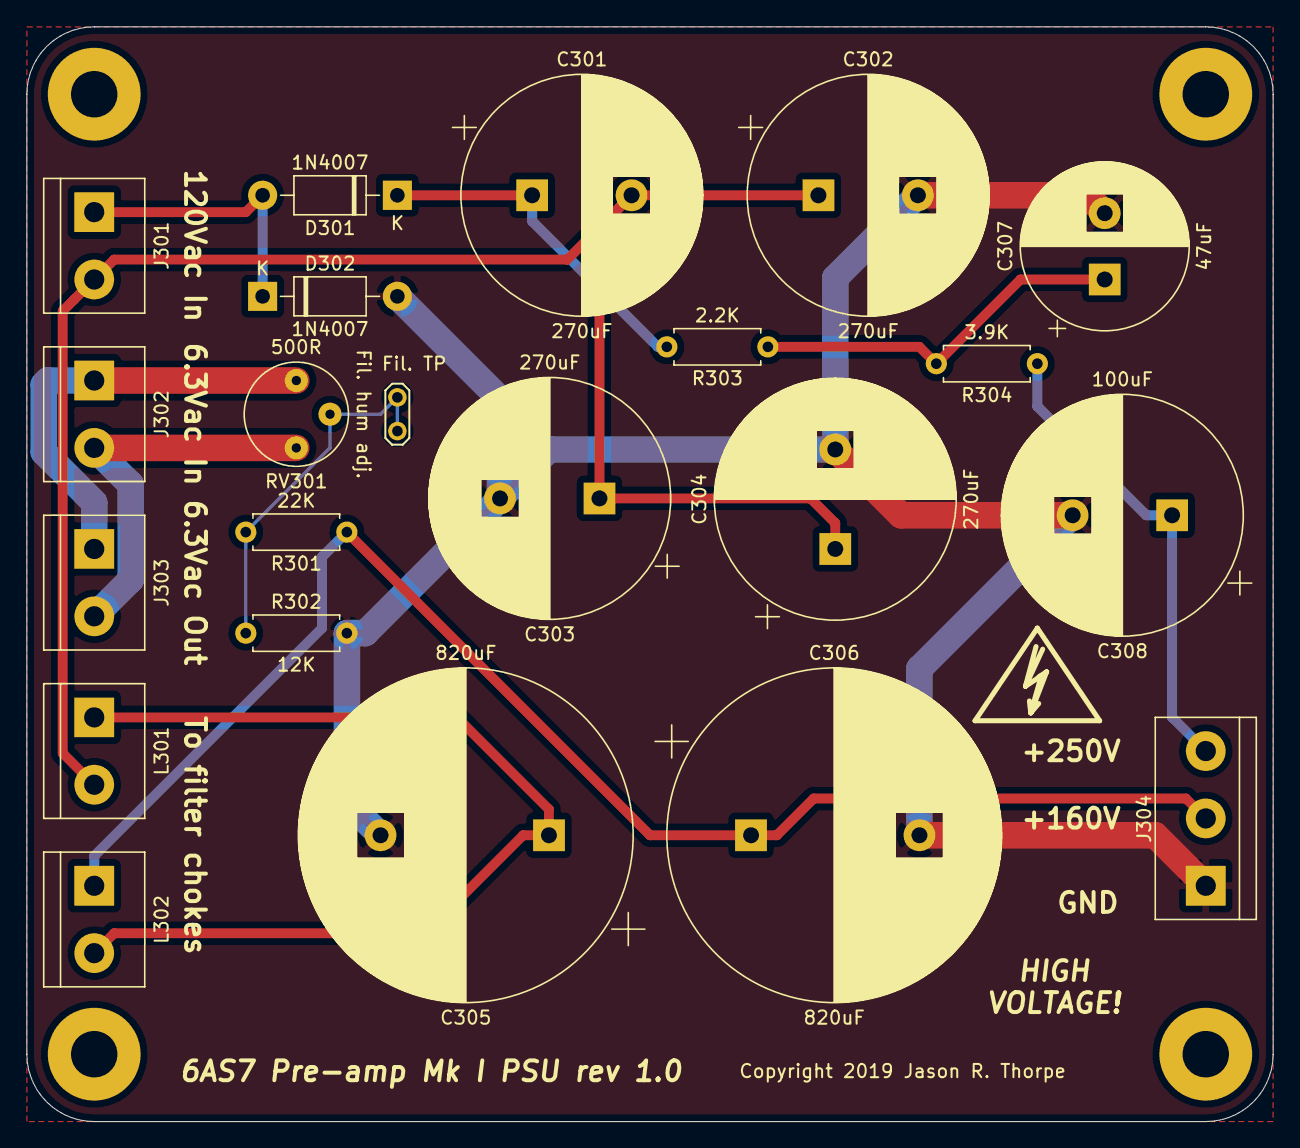
[picture p50: board STPre6080PSU.kicad_pcb from above]

Board: 2 copper layers, 94.0 x 82.5 mm, 22 parts (0 on the bottom side), 11 nets.

Other parts of the board:
Fil. TP: TestPoint_2Pads_Pitch2.54mm_Drill0.8mm

Their connections:
Fil_TP: Fil. TP.1, Fil. TP.2; also elsewhere on the board
