thorpej/Electronics/Power_Supplies/MOSFET_Pass_Regulator/MOSFET_Pass_Regulator.kicad_pcb

## KiCad design Power_Supplies/MOSFET_Pass_Regulator/MOSFET_Pass_Regulator.kicad_pcb (2018-10-03)

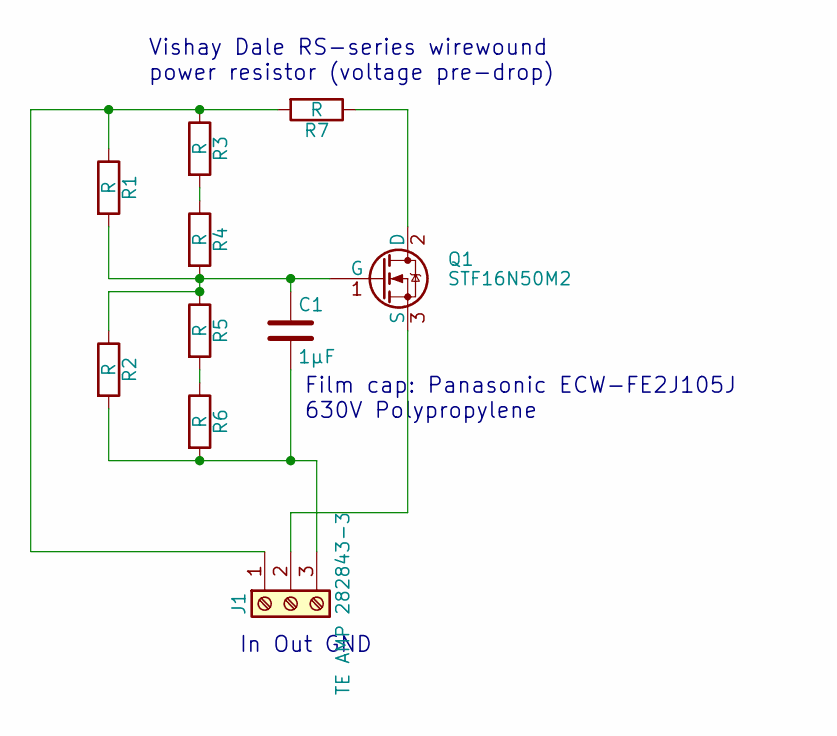
[picture p51: schematic MOSFET_Pass_Regulator.sch]

Parts:
C1: 1µF; C_Rect_L26.5mm_W10.5mm_P22.50mm_MKS4
J1: TE AMP 282843-3; TerminalBlock_AMP-3_P10.16mm
Q1: STF16N50M2; TO-220-3_Vertical
R1, R2, R3, R4, R5, R6: R; R_Axial_DIN0411_L9.9mm_D3.6mm_P15.24mm_Horizontal
R7: R; R_Axial_Power_L48.0mm_W12.5mm_P55.88mm

Connections:
unnamed: C1.1, Q1.1 (G), R1.2, R2.1, R4.2, R5.1
unnamed: C1.2, J1.3, R2.2, R6.2
unnamed: J1.1, R1.1, R3.1, R7.2
unnamed: J1.2, Q1.3 (S)
unnamed: Q1.2 (D), R7.1
unnamed: R3.2, R4.1
unnamed: R5.2, R6.1

Notes on the sheet:
Film cap: Panasonic ECW-FE2J105J 630V Polypropylene
In Out GND
Vishay Dale RS-series wirewound power resistor (voltage pre-drop)

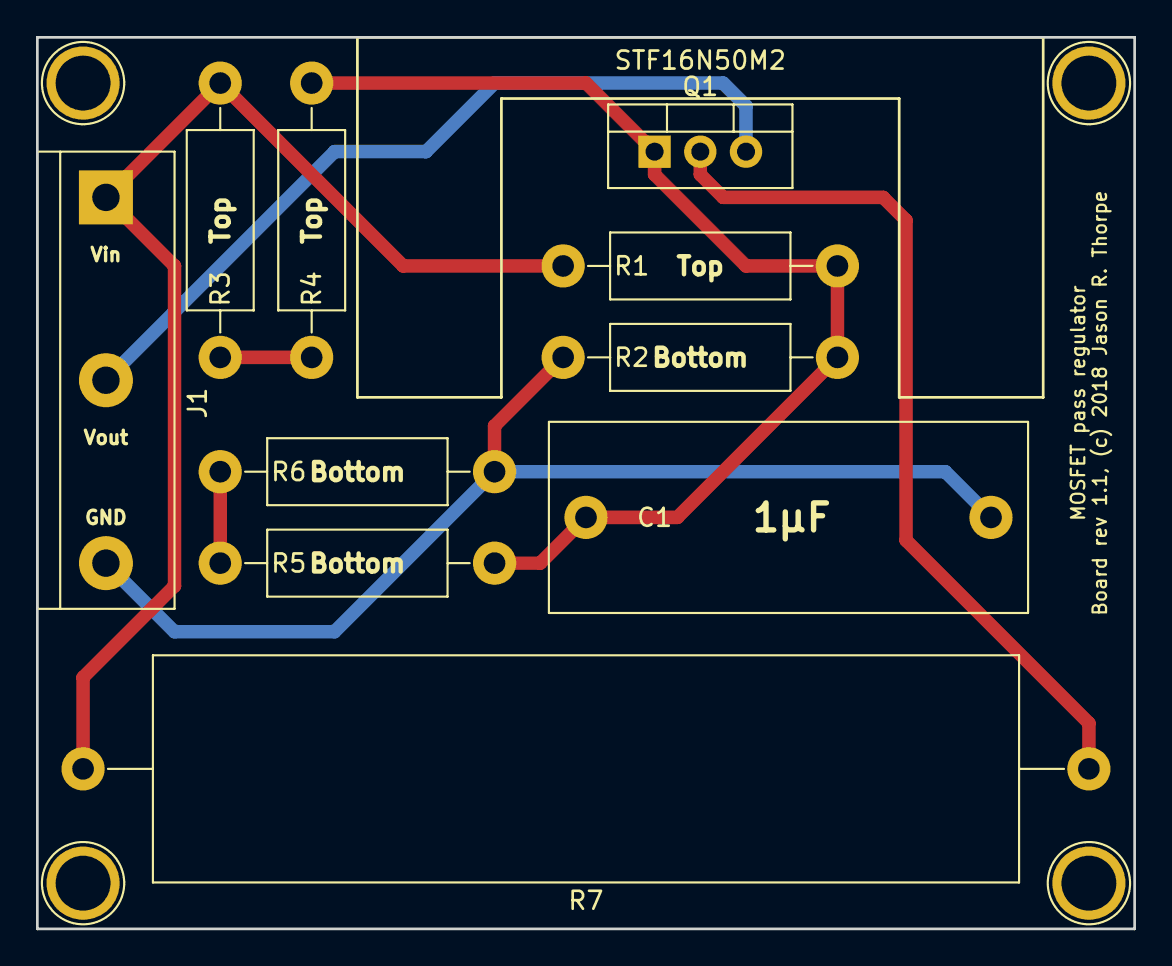
[picture p52: board MOSFET_Pass_Regulator.kicad_pcb from above]

Board: 2 copper layers, 61.0 x 49.5 mm, 11 parts (0 on the bottom side), 7 nets.

Other parts of the board:
STF16N50M2: Aavid_Thermalloy_ML33G_TO-220-heatsink
