thorpej/Electronics/Tube_Audio/Helper_Circuits/EFB_Cathode_Regulator/EFB_Cathode_Regulator.kicad_pcb

## KiCad design Tube_Audio/Helper_Circuits/EFB_Cathode_Regulator/EFB_Cathode_Regulator.kicad_pcb (2018-09-26)

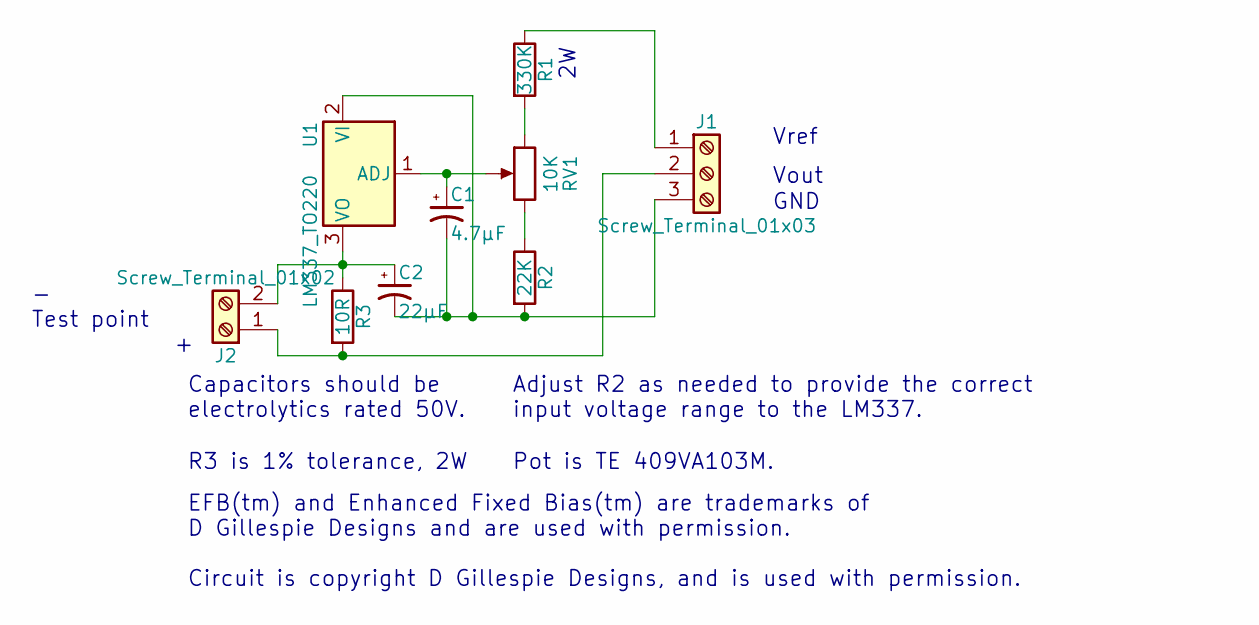
[picture p53: schematic EFB_Cathode_Regulator.sch]

Parts:
C1: 4.7µF; CP_Radial_D5.0mm_P2.00mm
C2: 22µF; CP_Radial_D6.3mm_P2.50mm
J1: Screw_Terminal_01x03; TerminalBlock_bornier-3_P5.08mm
J2: Screw_Terminal_01x02; TerminalBlock_bornier-2_P5.08mm
R1: 330K; R_Axial_DIN0414_L11.9mm_D4.5mm_P15.24mm_Horizontal
R2: 22K; R_Axial_DIN0309_L9.0mm_D3.2mm_P12.70mm_Horizontal
R3: 10R; R_Axial_DIN0411_L9.9mm_D3.6mm_P12.70mm_Horizontal
RV1: 10K; Potentiometer_Trimmer_Piher_PT-10h2.5_Vertical_Px2.5mm_Py5.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
U1: LM337_TO220; TO-220-3_Vertical

Connections:
unnamed: C1.1, RV1.2, U1.1 (ADJ)
unnamed: C1.2, C2.2, J1.3, R2.2, U1.2 (VI)
unnamed: C2.1, J2.2, R3.1, U1.3 (VO)
unnamed: J1.1, R1.1
unnamed: J1.2, J2.1, R3.2
unnamed: R1.2, RV1.1
unnamed: R2.1, RV1.3

Notes on the sheet:
Vref
Vout
GND
- Test point +
Adjust R2 as needed to provide the correct input voltage range to the LM337.
Capacitors should be electrolytics rated 50V.
Pot is TE 409VA103M.
R3 is 1% tolerance, 2W
EFB(tm) and Enhanced Fixed Bias(tm) are trademarks of D Gillespie Designs and are used with permission. Circuit is copyright D Gillespie Designs, and is used with permission.

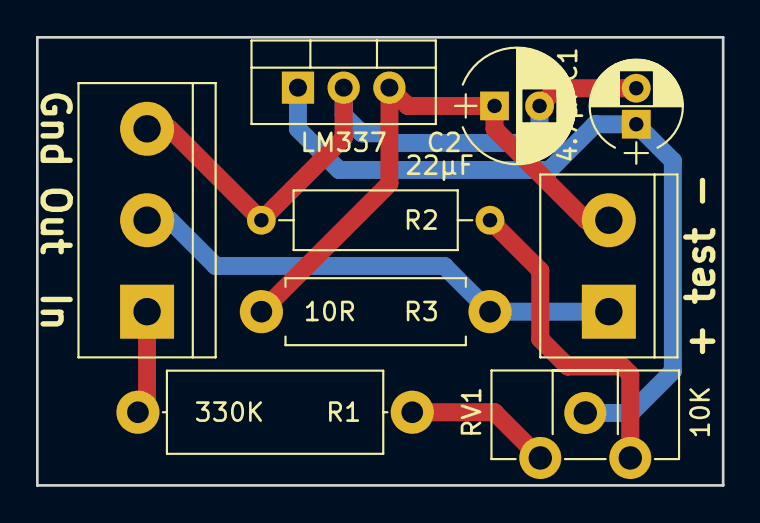
[picture p54: board EFB_Cathode_Regulator.kicad_pcb from above]

Board: 2 copper layers, 38.1 x 24.9 mm, 9 parts (0 on the bottom side), 7 nets.
