thorpej/Electronics/Tube_Audio/Helper_Circuits/EFB_Bias_Supply/EFB_Bias_Supply.kicad_pcb

## KiCad design Tube_Audio/Helper_Circuits/EFB_Bias_Supply/EFB_Bias_Supply.kicad_pcb (2018-09-26)

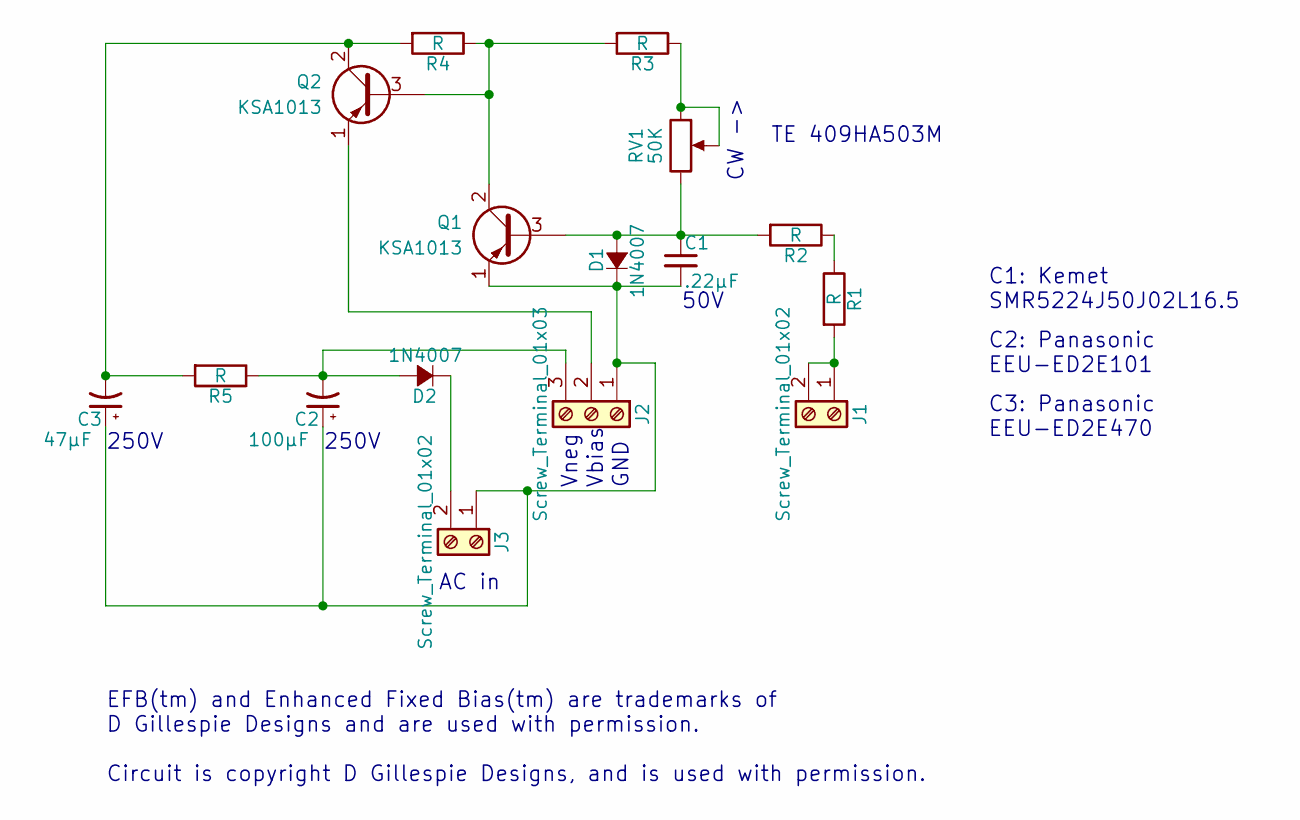
[picture p55: schematic EFB_Bias_Supply.sch]

Parts:
C1: .22µF; C_Rect_L7.2mm_W3.5mm_P5.00mm_FKS2_FKP2_MKS2_MKP2
C2: 100µF; CP_Radial_D16.0mm_P7.50mm
C3: 47µF; CP_Radial_D12.5mm_P5.00mm
D1, D2: 1N4007; D_DO-35_SOD27_P7.62mm_Horizontal
J1, J3: Screw_Terminal_01x02; TerminalBlock_bornier-2_P5.08mm
J2: Screw_Terminal_01x03; TerminalBlock_bornier-3_P5.08mm
Q1, Q2: KSA1013; TO-92_Inline_Wide
R1, R2, R3, R4, R5: R; R_Axial_DIN0411_L9.9mm_D3.6mm_P15.24mm_Horizontal
RV1: 50K; Potentiometer_Trimmer_ACP_CA9v_Horizontal_Px10.0mm_Py5.0mm

Connections:
unnamed: C1.1, D1.2 (A), Q1.3 (B), R2.2, RV1.3
unnamed: C1.2, C2.1, C3.1, D1.1 (K), J2.1, J3.1, Q1.1 (E)
unnamed: C2.2, D2.2 (A), J2.3, R5.1
unnamed: C3.2, Q2.2 (C), R4.2, R5.2
unnamed: D2.1 (K), J3.2
unnamed: J1.1, J1.2, R1.2
unnamed: J2.2, Q2.1 (E)
unnamed: Q1.2 (C), Q2.3 (B), R3.2, R4.1
unnamed: R1.1, R2.1
unnamed: R3.1, RV1.1, RV1.2

Notes on the sheet:
CW ->
GND
Vbias
Vneg
AC in
250V
C2: Panasonic EEU-ED2E101
50V
C1: Kemet SMR5224J50J02L16.5
C3: Panasonic EEU-ED2E470
TE 409HA503M
EFB(tm) and Enhanced Fixed Bias(tm) are trademarks of D Gillespie Designs and are used with permission. Circuit is copyright D Gillespie Designs, and is used with permission.

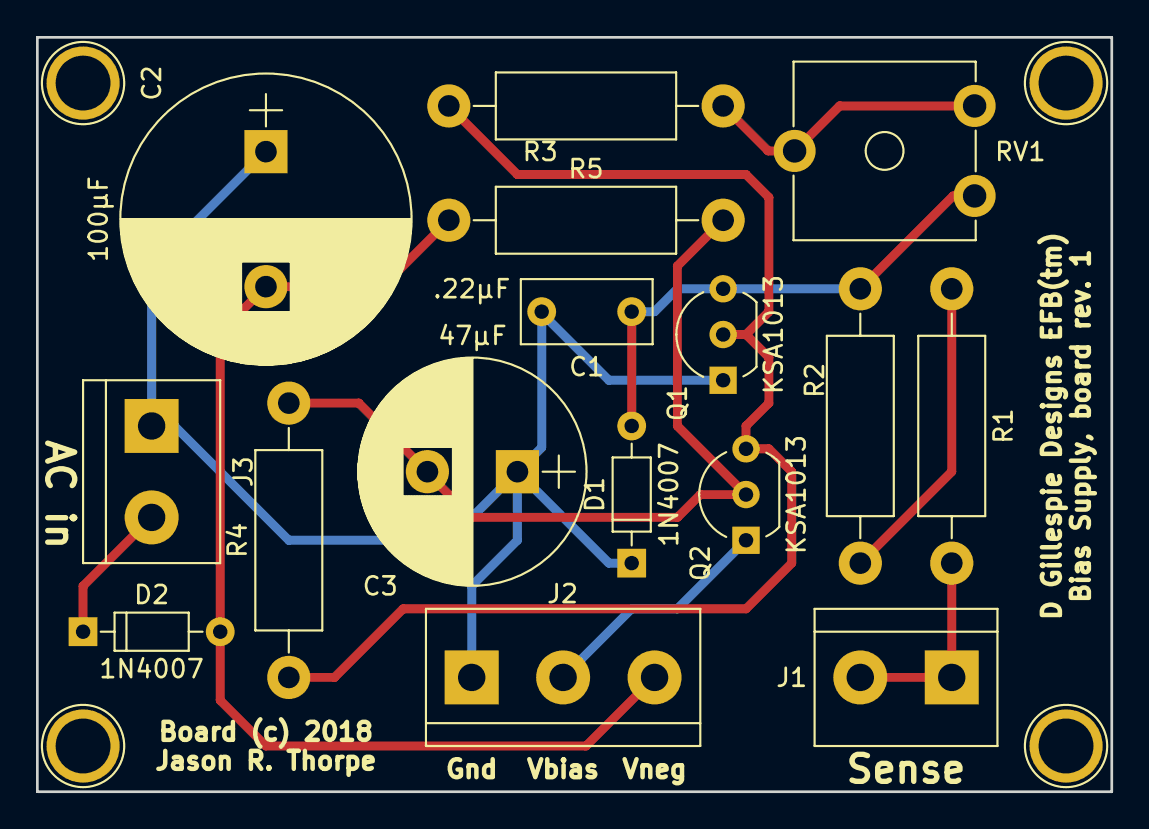
[picture p56: board EFB_Bias_Supply.kicad_pcb from above]

Board: 2 copper layers, 59.7 x 41.9 mm, 16 parts (0 on the bottom side), 10 nets.
