thorpej/Electronics/Tube_Audio/Helper_Circuits/Bias_Balance_Helper_x2/Bias_Balance_Helper_x2.kicad_pcb

## KiCad design Tube_Audio/Helper_Circuits/Bias_Balance_Helper_x2/Bias_Balance_Helper_x2.kicad_pcb (2018-09-16)

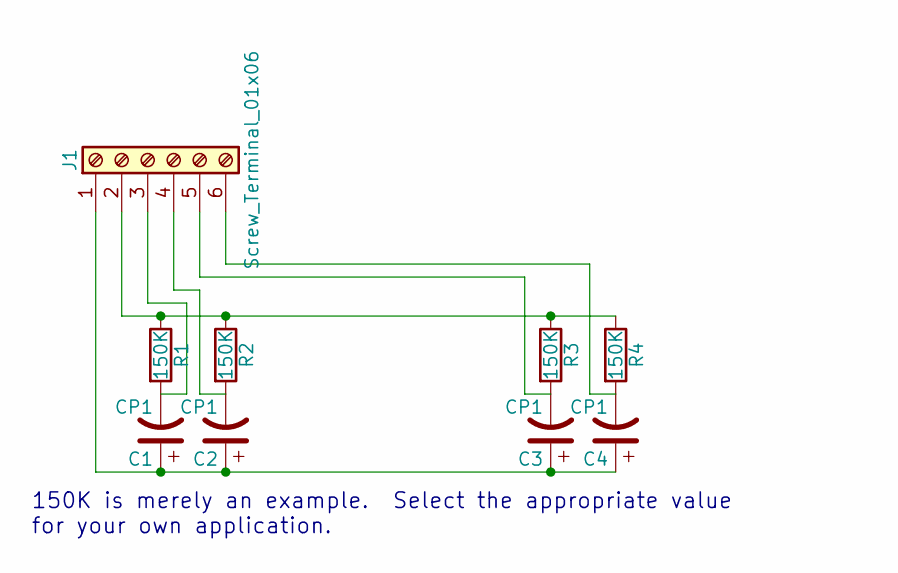
[picture p57: schematic Bias_Balance_Helper_x2.sch]

Parts:
C1, C2, C3, C4: CP1; CP_Radial_D10.0mm_P2.50mm
J1: Screw_Terminal_01x06; TerminalBlock_bornier-6_P5.08mm
R1, R2, R3, R4: 150K; R_Axial_DIN0207_L6.3mm_D2.5mm_P10.16mm_Horizontal

Connections:
unnamed: C1.1, C2.1, C3.1, C4.1, J1.1
unnamed: C1.2, J1.3, R1.2
unnamed: C2.2, J1.4, R2.2
unnamed: C3.2, J1.5, R3.2
unnamed: C4.2, J1.6, R4.2
unnamed: J1.2, R1.1, R2.1, R3.1, R4.1

Notes on the sheet:
150K is merely an example. Select the appropriate value for your own application.

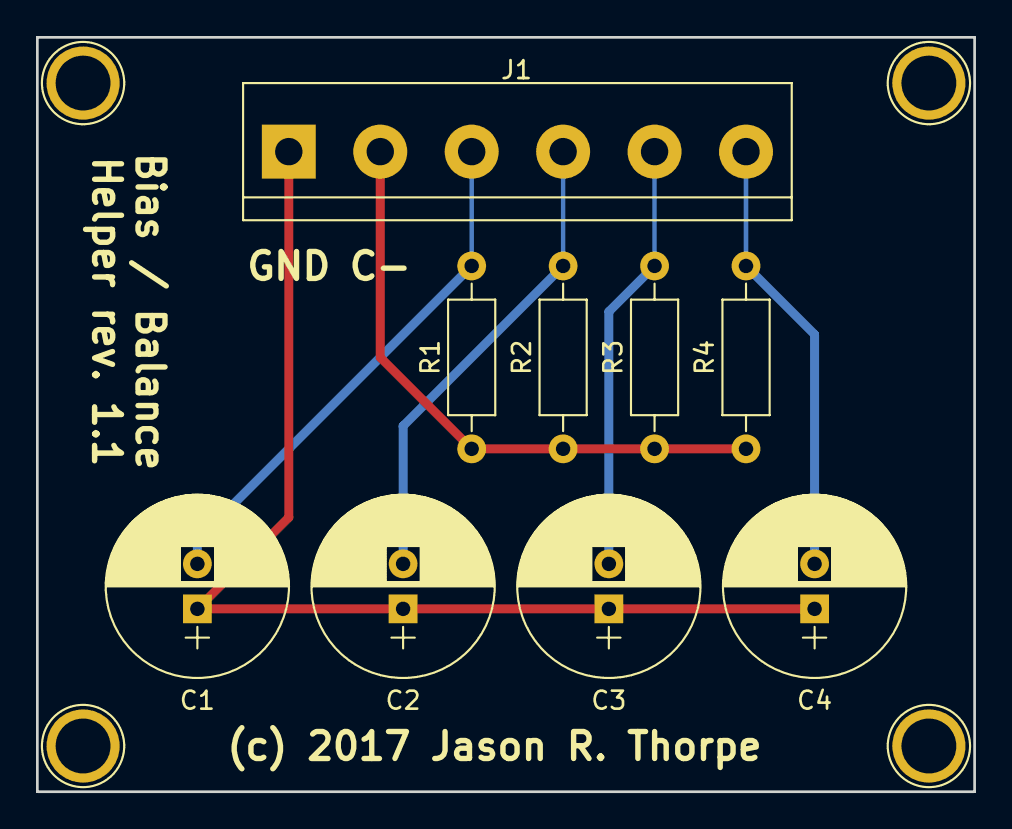
[picture p58: board Bias_Balance_Helper_x2.kicad_pcb from above]

Board: 2 copper layers, 52.1 x 41.9 mm, 13 parts (0 on the bottom side), 6 nets.

Other parts of the board:
Screw: 1pin
Screw#2, Screw#3, Screw#4: 1pin
