thorpej/Electronics/Tube_Misc/Nixie_IN-14_Breakout/Nixie_IN-14_Breakout.kicad_pcb

## KiCad design Tube_Misc/Nixie_IN-14_Breakout/Nixie_IN-14_Breakout.kicad_pcb (2018-04-12)

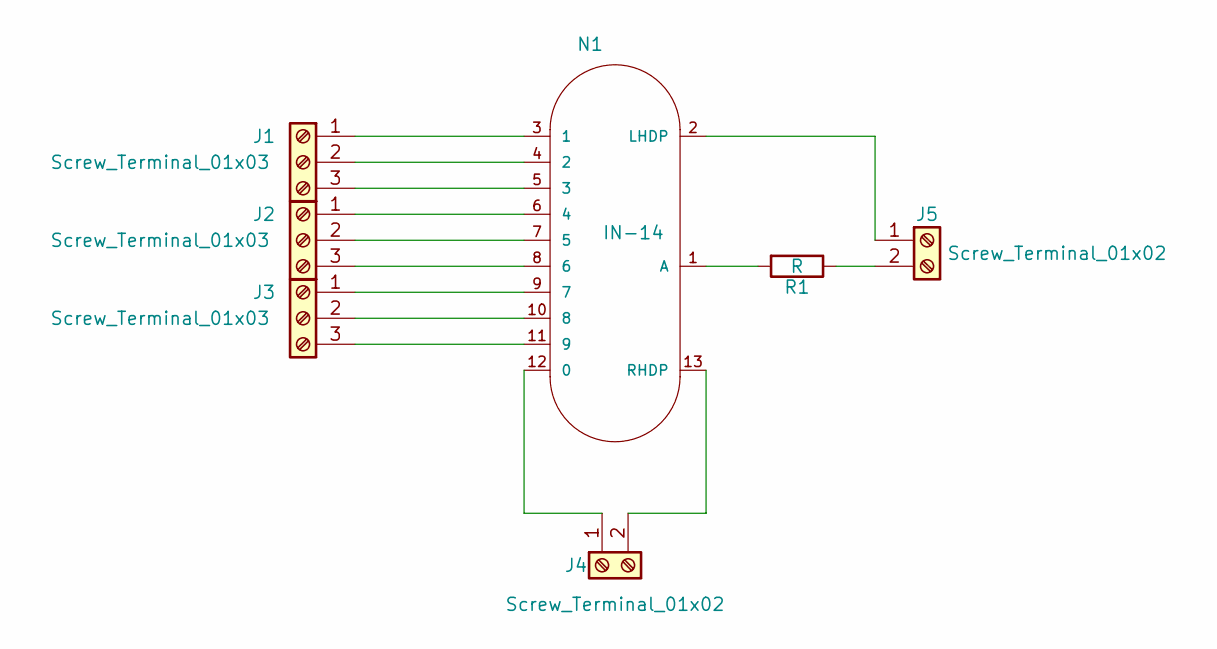
[picture p59: schematic Nixie_IN-14_Breakout.sch]

Parts:
J1, J2, J3: Screw_Terminal_01x03; TerminalBlock_bornier-3_P5.08mm
J4, J5: Screw_Terminal_01x02; TerminalBlock_bornier-2_P5.08mm
N1: IN-14; Nixie-IN-14
R1: R; R_Axial_DIN0414_L11.9mm_D4.5mm_P15.24mm_Horizontal

Connections:
unnamed: J1.1, N1.3 (1)
unnamed: J1.2, N1.4 (2)
unnamed: J1.3, N1.5 (3)
unnamed: J2.1, N1.6 (4)
unnamed: J2.2, N1.7 (5)
unnamed: J2.3, N1.8 (6)
unnamed: J3.1, N1.9 (7)
unnamed: J3.2, N1.10 (8)
unnamed: J3.3, N1.11 (9)
unnamed: J4.1, N1.12 (0)
unnamed: J4.2, N1.13 (RHDP)
unnamed: J5.1, N1.2 (LHDP)
unnamed: J5.2, R1.1
unnamed: N1.1 (A), R1.2

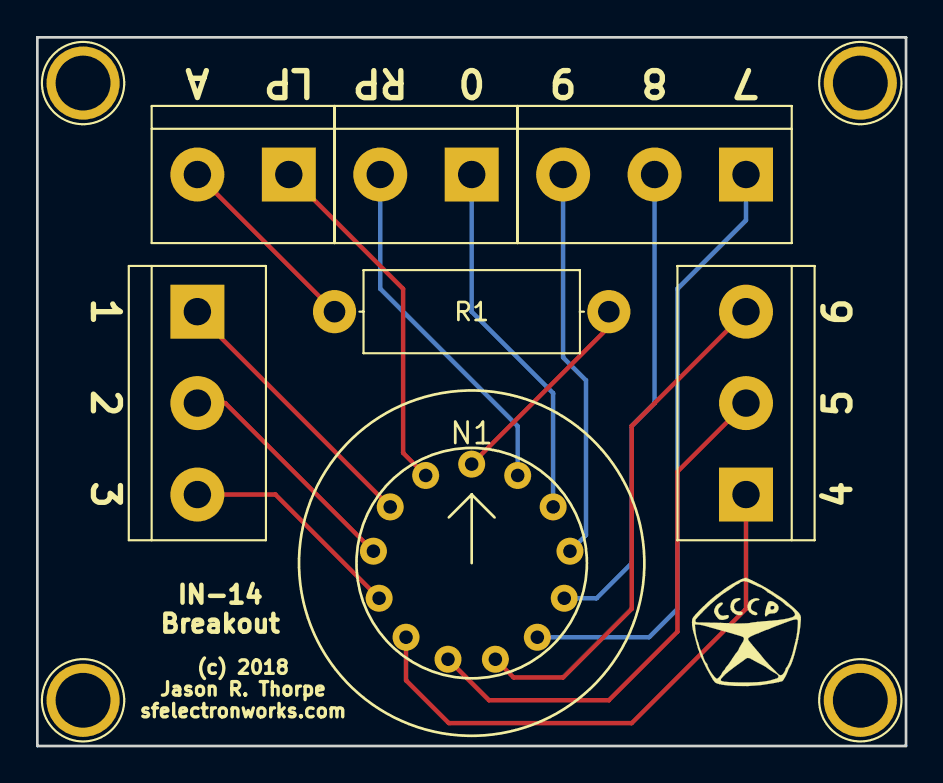
[picture p60: board Nixie_IN-14_Breakout.kicad_pcb from above]

Board: 2 copper layers, 48.3 x 39.4 mm, 7 parts (0 on the bottom side), 14 nets.
