thorpej/Electronics/(commit log)

2018-03-18 Add high-voltage warning.
2018-03-20 Initial commit of the adjustable bench power supply files.
2018-03-21 Add my 2 channel CCS Tail board.
    [CCS_Tail_x2-B.Cu.gbr, CCS_Tail_x2-B.Mask.gbr, CCS_Tail_x2-Edge.Cuts.gbr, CCS_Tail_x2-F.Cu.gbr, CCS_Tail_x2-F.Fab.gbr, CCS_Tail_x2-F.Mask.gbr, CCS_Tail_x2-F.SilkS.gbr, CCS_Tail_x2.drl]
2018-03-23 Add my IN-14 breadout board.
    [Nixie-IN-14-breakout-B.Cu.gbr, Nixie-IN-14-breakout-B.Mask.gbr, Nixie-IN-14-breakout-B.SilkS.gbr, Nixie-IN-14-breakout-Edge.Cuts.gbr, Nixie-IN-14-breakout-F.Cu.gbr, Nixie-IN-14-breakout-F.Fab.gbr, Nixie-IN-14-breakout-F.Mask.gbr, Nixie-IN-14-breakout-F.SilkS.gbr]
2018-03-30 Document the current-limiting resistor.
2018-03-30 Expand on how to select the correct current-limiting resistor.
2018-03-31 Add a link to a photo of the board in action.
2018-03-31 Fix a couple of typos.
2018-04-12 Initial version of a user-space driver for the Taos TSL2561 Lux sensor.
    This is initially targeted at NetBSD, and uses the NetBSD i2c
    API to access the device. But it should be pretty easily adapted
    to other platforms.
2018-04-12 Fix whitespace glitch in usage message.
    [tsltest.c]
2018-04-16 Add user-space drivers for generic 8-bit shift registers (e.g. SN74HC595) and the SN74141 BCD decoder / Nixie driver.
2018-05-27 In tsl256x_poweron(), verify that the power-on cycle completed by reading back the control register.
2018-05-27 Oops, fix a paste-o, and make tsl256x_read1() available. (I back-ported this change from another version of this driver.)
    [tsl256x.c]
2018-05-27 In tsl256x_get_sensor_data(), use a new internal tsl256x_set_gain0() internal function to adjust the gain in the auto-gain case; a side-effect of tsl256x_set_gain() is to disable auto-gain if the app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
2018-05-27 In tsl256x_set_integration_time(), if writing to the register fails, ensure that we power the device back off.
    [tsl256x.c]
2018-05-27 Note the existence of the tsllux(4) kernel-mode driver on NetBSD.
2018-08-26 Add CAD files for the EFB cathode regulator board.
    [EFB_Cathode_Regulator-B.Cu.gbr, EFB_Cathode_Regulator-B.Mask.gbr, EFB_Cathode_Regulator-B.SilkS.gbr, EFB_Cathode_Regulator-Edge.Cuts.gbr, EFB_Cathode_Regulator-F.Cu.gbr, EFB_Cathode_Regulator-F.Mask.gbr, EFB_Cathode_Regulator-F.SilkS.gbr, EFB_Cathode_Regulator.drl]
2018-09-16 Add Rev 1.1 of my bias-balance helper board.
    [Bias_Balance_Helper_x2-B.Cu.gbr, Bias_Balance_Helper_x2-B.Mask.gbr, Bias_Balance_Helper_x2-B.SilkS.gbr, Bias_Balance_Helper_x2-Edge.Cuts.gbr, Bias_Balance_Helper_x2-F.Cu.gbr, Bias_Balance_Helper_x2-F.Fab.gbr, Bias_Balance_Helper_x2-F.Mask.gbr, Bias_Balance_Helper_x2-F.SilkS.gbr]
2018-09-21 Add documentatation for my EFB Bias Supply board, along with the configuration calculator spreadsheet.
    [EFB_Bias_Supply_Calculator.xlsx]
2018-09-21 It's not the Qpoint voltage that's brought out to Vneg, it's the Raw_Neg_Voltage. Update the documentation and calculator to reflect this reality.
    [EFB_Bias_Supply_Calculator.xlsx]
2018-09-21 Use the resistance of the "Individul_Bias_Network" simulation as the Rnetwork resistance in the calculator example.
    [EFB_Bias_Supply_Calculator.xlsx]
2018-09-21 Add a simulation for a bias adjustment network that uses a single pot for each individual output tube in a stereo push-pull application.
2018-09-21 Some edits from Kevin, plus some extra verbiage about what changes would be needed for high bias voltage applications.
2018-09-22 Add node labels at each of the bias taps (the adjustment pot wipers). Also tidy up the the capacitors a little.
2018-09-23 Add KiCad files and resulting Gerber files for the EFB bias supply board.
    [EFB_Bias_Supply-B.Cu.gbr, EFB_Bias_Supply-B.Mask.gbr, EFB_Bias_Supply-B.SilkS.gbr, EFB_Bias_Supply-Edge.Cuts.gbr, EFB_Bias_Supply-F.Cu.gbr, EFB_Bias_Supply-F.Fab.gbr, EFB_Bias_Supply-F.Mask.gbr, EFB_Bias_Supply-F.SilkS.gbr]
2018-09-26 Clarify trademark status in all materials.
    [EFB_Bias_Supply-B.Cu.gbr, EFB_Bias_Supply-B.Mask.gbr, EFB_Bias_Supply-B.SilkS.gbr, EFB_Bias_Supply-Edge.Cuts.gbr, EFB_Bias_Supply-F.Cu.gbr, EFB_Bias_Supply-F.Fab.gbr, EFB_Bias_Supply-F.Mask.gbr, EFB_Bias_Supply-F.SilkS.gbr]
2018-09-26 Add a LICENSE file specific to EFB(tm) boards.
2018-10-03 Add my MOSFET pass regulator board.
    [MOSFET_Pass_Regulator-B.Cu.gbr, MOSFET_Pass_Regulator-B.Mask.gbr, MOSFET_Pass_Regulator-B.SilkS.gbr, MOSFET_Pass_Regulator-Edge.Cuts.gbr, MOSFET_Pass_Regulator-F.Cu.gbr, MOSFET_Pass_Regulator-F.Fab.gbr, MOSFET_Pass_Regulator-F.Mask.gbr, MOSFET_Pass_Regulator-F.SilkS.gbr]
2018-10-03 Better text to explain that you can't use the "capacitance multiplier" configuraiton if your peak-to-peak ripple is greater than your MOSFET's threshold voltage.
2018-11-25 Initial add of my user-space PCA9685 LED controller driver.
2018-11-26 Fix missing transaction start in pca9685_pulse_channel(). Also fix a typo in a comment.
    [pca9685.c]
2019-07-20 Fix dumb obo error.
    [nixie_display.c]
2019-07-20 GPIO pin state hygiene.
2019-07-21 Fix a silly bug in argument processing. Add a short delay after setting the display string in cycle mode, and report on the terminal what we're setting the display to.
    [nixietest.c]
2019-07-24 Full-on and Full-off settings were reversed. Oops!
    [pca9685.c]
2019-09-17 Add symbols for various IC, Nixies, power nodes, regulators, and valves I have lurking around.
2019-09-17 Add an Arduino Nano symbol.
2019-09-20 Add a symbol for my 2ChanCCSLoad board.
2019-09-20 Add a library for switches. First entry is for C&K A20403RNZQ 2-pole 4-position rotary switch.
2019-09-20 Add a +300V symbol.
2019-09-20 Footprint for leaded radial electrolytic, 25mm diameter, 12.5mm pin pitch. E.g. Nichicon UPT2D821MRD
2019-09-21 Add my 6AS7 pre-amp design. WIP -- not yet ready for fabrication.
    [STPre6080.kicad_pcb, STPre6080.sch, STPre6080Heaters.sch, STPre6080PCB.kicad_pcb, STPre6080PCB.sch, STPre6080PSU.kicad_pcb, STPre6080PSU.sch]
2019-09-21 Add my 9A / 9AJ Heater Helper board.
    [9A_9AJ_Heater_Helper-B_Cu.gbr, 9A_9AJ_Heater_Helper-B_Mask.gbr, 9A_9AJ_Heater_Helper-B_SilkS.gbr, 9A_9AJ_Heater_Helper-Edge_Cuts.gbr, 9A_9AJ_Heater_Helper-F_Cu.gbr, 9A_9AJ_Heater_Helper-F_Mask.gbr, 9A_9AJ_Heater_Helper-F_SilkS.gbr, 9A_9AJ_Heater_Helper-NPTH.drl]
2019-09-24 Checkpoint -- getting closer to laying out the tone control PCB.
    [STPre6080.sch, STPre6080PCB.sch, STPre6080PSU.kicad_pcb]
2019-09-24 A couple of small tweaks for laying out the PCB.
    [STPre6080PCB.sch]
2019-09-24 PCB layout complete for the pre-amp main board.
    [STPre6080PCB.kicad_pcb]
2019-09-24 Adjust ground plane top and bottom.
    [STPre6080PSU.kicad_pcb]
2019-09-24 Removed the heater circuit sheet -- that has been spun off into a separate project.
    [STPre6080.sch, STPre6080Heaters.sch, STPre6080PCB.sch]
2019-09-24 Remove accidentally committed dummy file.
    [STPre6080.kicad_pcb]
2019-09-24 Add a Danger - High Voltage symbol for F.SilkS
2019-09-24 Add high voltage warnings.
    [STPre6080PCB.kicad_pcb, STPre6080PSU.kicad_pcb]
2019-09-24 Final tweaks and Gerbers for the PCBs.
    [STPre6080PCB-B_Cu.gbr, STPre6080PCB-B_Mask.gbr, STPre6080PCB-B_SilkS.gbr, STPre6080PCB-Edge_Cuts.gbr, STPre6080PCB-F_Cu.gbr, STPre6080PCB-F_Mask.gbr, STPre6080PCB-F_SilkS.gbr, STPre6080PCB-NPTH.drl]
2019-09-24 Final checkpoint after sending them off for fabrication.
    [STPre6080PCB.kicad_pcb]
2019-09-25 Rev the CCS tail board -- use the Bourns 4-turn trim pots, and shrink the board a bit.
    [CCS_Tail_x2-B_Cu.gbr, CCS_Tail_x2-B_Mask.gbr, CCS_Tail_x2-Edge_Cuts.gbr, CCS_Tail_x2-F.Fab.gbr, CCS_Tail_x2-F_Cu.gbr, CCS_Tail_x2-F_Mask.gbr, CCS_Tail_x2-F_SilkS.gbr, CCS_Tail_x2-NPTH.drl]
2019-09-25 Add my 2-channel CCS plate load board, a companion to the 2-channel CCS tail board.
    [CCS_Load_x2-B_Cu.gbr, CCS_Load_x2-B_Mask.gbr, CCS_Load_x2-Edge_Cuts.gbr, CCS_Load_x2-F_Cu.gbr, CCS_Load_x2-F_Mask.gbr, CCS_Load_x2-F_SilkS.gbr, CCS_Load_x2-NPTH.drl, CCS_Load_x2-PTH.drl]
2019-09-25 2ChanCCSLoad -> CCS_Load_x2 to match the rev'd board.
2019-09-25 Add a symbol for my CCS_Tail_x2 board.
2019-09-29 Add LTSpice simulation files for the pre-amp circuit and the PSU.
2019-09-29 Fix up title block on PSU sheet.
    [STPre6080PCB.sch, STPre6080PSU.sch]
2019-09-30 Oops, the input buffer / tone controls are on a +250V rail in the final schematic, not a +300V rail. Adjust the simulation to correct this.
2019-10-01 Bump version, fix a comment.
    [eeprom_28.ino]
2019-10-08 Add 74HC165, tweak background on a couple of other symbols.
2019-10-08 Add a PCB template for a Rasperry Pi HAT. See:
    https://github.com/raspberrypi/hats/blob/master/hat-board-mechanical.pdf
    [Raspberry_Pi_HAT.kicad_pcb]
2019-10-09 Make the RPI connector J1.
    [Raspberry_Pi_HAT.kicad_pcb]
2019-10-10 Checkpoint WiP -- RAdLib -- a Raspberry Pi AdLib clone.
    [Bus_Interface.sch, Clock_Source.sch, RAdLib.kicad_pcb, RAdLib.sch]
2019-10-12 Add a couple of useful graphics.
2019-10-13 Checkpoint ... board is close to being done. Still need to tweak the ground plane.
    [Bus_Interface.sch, Clock_Source.sch, RAdLib.kicad_pcb, RAdLib.sch]
2019-10-13 Close to final?
    [RAdLib.kicad_pcb]
2019-10-14 Initial Raspberry Pi DT overlay for RAdLib.
2019-10-16 This should work with the H2+ and H5 flavors of the board, as well.
2019-10-22 Rework the clock to use a self-contained oscillator package. Remove dependencies on the 7404 in the bus interface.
    [Bus_Interface.sch, Clock_Source.sch, RAdLib.kicad_pcb, RAdLib.sch]
2019-10-22 Interrupt is now active-low.
2019-10-22 Fix the pin numbers on the pads of the Bourns pot.
2019-10-22 Reference LICENSE.txt.
    [9A_9AJ_Heater_Helper.kicad_pcb, 9A_9AJ_Heater_Helper.sch]
2019-10-22 Fix pin pitch.
2019-10-22 Update README to reflect the current revision of the board≥
2019-10-22 Add some capacitor footprints for the 6AS7 pre-amp board.
2019-10-22 IN-14 Nixie footprint.
2019-10-22 C&K V80212MS02Q footprint.
2019-10-23 Initial rework to simplify the bus interface (removing U202 and U203).
    [Bus_Interface.sch, RAdLib.kicad_pcb, RAdLib.sch]
2019-10-24 Additional tweaks, silly graphics.
    [RAdLib.kicad_pcb]
2019-10-29 Update the active filter stages after the DAC to work with the power supply constraints on the RPI. Document what needs to be done to the audio output section.
    [RAdLib.sch]
2019-10-30 Rework the audio output section as an AC-coupled emitter-follower.
    [Bus_Interface.sch, RAdLib.kicad_pcb, RAdLib.sch]
2019-10-30 Add a note about why the volume control is AC-coupled on either side.
2019-10-30 Use a more generic part # for the ID ROM.
    [Bus_Interface.sch, RAdLib.kicad_pcb]
2019-10-30 Update title block.
    [Bus_Interface.sch, RAdLib.kicad_pcb, RAdLib.sch]
2019-10-31 Gerbers for rev 1.0.
    [RAdLib-B_Cu.gbr, RAdLib-B_Mask.gbr, RAdLib-B_SilkS.gbr, RAdLib-Edge_Cuts.gbr, RAdLib-F_Cu.gbr, RAdLib-F_Mask.gbr, RAdLib-F_SilkS.gbr, RAdLib-NPTH.drl]
2019-12-01 Oops, syntax errors in the gpio declarations.
    [radlib-raspberrypi-overlay.dts]
2021-12-16 Add a Displays footprint library, and put a simple footprint for the Wurth WL-T7DS single-digit unit in there.
2021-12-16 Add an empty Connectors library.
2021-12-16 Symbol and footprint for the CUI PJ-097BH DC jack.
2021-12-16 Fix the pin names / visibility on the CUI DC jack.
2021-12-17 Add a footprint for the Alpha RV09AF-40 type potentiometers.
2021-12-17 Add a footprint for the NKK BB16AP switch.
2021-12-27 README.md: Add note about PCBs that will be done for this project.
2021-12-28 DB10x: Make the + and - pins power outputs.
2021-12-28 Add first pass at schematic for bench PSU meter panel power supply.
    [panel-supply.kicad_pcb, panel-supply.sch]
2021-12-28 DB10x: Correct the footprint.
2021-12-28 panel-supply: Small schematic tweaks made while laying out the PCB.
    [panel-supply.sch]
2021-12-29 Add a basic footprint for the Aavid Thermalloy ML33G TO-220 heat sink.
2021-12-29 Add a basic footprint for the Aavid 577202B04000G TO-220 heat sink.
2021-12-29 KWard PSU: First pass at panel supply PCB.
    [panel-supply.kicad_pcb]
2021-12-29 Correct footprint library name for the diode bridge.
2021-12-29 panel-supply: Add a note specifying Triad F5-12 for the transformer.
    [panel-supply.sch]
2021-12-29 Add a footprint to the 6550.
2021-12-29 Add the filament unit to the 6550.
2021-12-29 Add 10.16mm-pitch screw-type terminal blocks.
2021-12-29 Add a 4-position 10.16mm-pitch screw terminal block footprint.
2021-12-30 First pass at the 6550 pass array board.
    [pass-tube-array.kicad_pcb, pass-tube-array.sch]
2021-12-30 Add HV supply schematic. There will be no PCB for the HV supply.
    [hv-supply.kicad_pcb, hv-supply.sch]
2021-12-31 Add a C_Rect_L18.0mm_W18.0mm_P15.0mm footprint.
2021-12-31 Use 100K sharing resistors in the cap stacks of the B+ supply.
2021-12-31 Schematic and PCB for the screen supply and regulator board.
    [screen-supply-and-regulator.kicad_pcb, screen-supply-and-regulator.sch]
2021-12-31 Schematic and PCB for the PSU bias supply.
    [bias-supply.kicad_pcb, bias-supply.sch]
2022-01-01 Make the C- meter terminal a 3-position part, with a separate one for the GND reference.
    [bias-supply.kicad_pcb, bias-supply.sch]
2022-01-01 Reposition the measurements.
    [panel-supply.kicad_pcb]
2022-01-01 AC input for the B+ supply is "B+_120Vac".
    [hv-supply.sch]
2022-01-01 - Use bare mounting holes. - DANGER warning in all-caps.
    [pass-tube-array.kicad_pcb]
2022-01-01 Minor tweaks to the silk screen on the regulator board.
    [screen-supply-and-regulator.kicad_pcb, screen-supply-and-regulator.sch]
2022-01-01 Filament supply schematic.
    [filament-supply.kicad_pcb, filament-supply.sch]
2022-01-01 Note that the bias supply is connected to the Main 120Vac.
    [bias-supply.sch]
2022-01-01 Add a README for the panel supply board.
2022-01-01 Improve text comments.
    [panel-supply.sch]
2022-01-01 panel-supply: Final tweaks for 1.0. Generate Gerber files.
    [panel-supply-B_Cu.gbr, panel-supply-B_Mask.gbr, panel-supply-B_SilkS.gbr, panel-supply-Edge_Cuts.gbr, panel-supply-F_Cu.gbr, panel-supply-F_Mask.gbr, panel-supply-F_SilkS.gbr, panel-supply-NPTH.drl]
2022-01-02 Correct AC input value label, add some part numbers, tweak some text.
    [bias-supply.sch]
2022-01-02 Correct AC input value label, and change mounting holes to NPTH.
    [bias-supply.kicad_pcb]
2022-01-02 Generate bias-supply board Gerbers.
    [bias-supply-B_Cu.gbr, bias-supply-B_Mask.gbr, bias-supply-B_SilkS.gbr, bias-supply-Edge_Cuts.gbr, bias-supply-F_Cu.gbr, bias-supply-F_Mask.gbr, bias-supply-F_SilkS.gbr, bias-supply-NPTH.drl]
2022-01-02 Final tweaks for rev 1.0.
    [bias-supply-B_Cu.gbr, bias-supply-B_Mask.gbr, bias-supply-B_SilkS.gbr, bias-supply-Edge_Cuts.gbr, bias-supply-F_Cu.gbr, bias-supply-F_Mask.gbr, bias-supply-F_SilkS.gbr, bias-supply-NPTH.drl]
2022-01-02 README.md for the bias supply board.
2022-01-02 Add mounting hole measurements.
    [bias-supply.kicad_pcb]
2022-01-02 Add PDFs for bias supply schematic / pcb.
2022-01-02 Add board revsion (still 1.0) to the PCB silk screen.
    [panel-supply-B_Cu.gbr, panel-supply-B_Mask.gbr, panel-supply-B_SilkS.gbr, panel-supply-Edge_Cuts.gbr, panel-supply-F_Cu.gbr, panel-supply-F_Mask.gbr, panel-supply-F_SilkS.gbr, panel-supply-NPTH.drl]
2022-01-02 Call out the protection diodes.
2022-01-04 Add a footprint for the AES P-ST8-193 PC-mount octal tube socket.
2022-01-04 Tidy these octal footprints up a bit.
2022-01-04 Redo the pass tube array board, using the proper footprint for the AES ceramtic PC-mount octal socket.
    [pass-tube-array.kicad_pcb, pass-tube-array.sch]
2022-01-04 Generate Gerbers for pass tube array board
    [pass-tube-array-B_Cu.gbr, pass-tube-array-B_Mask.gbr, pass-tube-array-B_SilkS.gbr, pass-tube-array-Edge_Cuts.gbr, pass-tube-array-F_Cu.gbr, pass-tube-array-F_Mask.gbr, pass-tube-array-F_SilkS.gbr, pass-tube-array-NPTH.drl]
2022-01-05 Correct minor flaw in PCB.
    [pass-tube-array-B_Cu.gbr, pass-tube-array-B_Mask.gbr, pass-tube-array-B_SilkS.gbr, pass-tube-array-Edge_Cuts.gbr, pass-tube-array-F_Cu.gbr, pass-tube-array-F_Mask.gbr, pass-tube-array-F_SilkS.gbr, pass-tube-array-NPTH.drl]
2022-01-05 Generate pass tube array PDFs.
2022-01-05 README for the pass tube array board.
2022-01-05 Add the tube socket part #.
2022-01-05 Add my "snap-in capacitor stack" helper board.
    [SnapInCapStack-B_Cu.gbr, SnapInCapStack-B_Mask.gbr, SnapInCapStack-B_SilkS.gbr, SnapInCapStack-Edge_Cuts.gbr, SnapInCapStack-F_Cu.gbr, SnapInCapStack-F_Mask.gbr, SnapInCapStack-F_SilkS.gbr, SnapInCapStack-NPTH.drl]
2022-01-05 Add viewable images of the schematic / PCB.
    [9A_9AJ_Heater_Helper.kicad_pcb, 9A_9AJ_Heater_Helper.sch]
2022-01-05 SnapInCapStack: Round the corders of the board.
    [SnapInCapStack-B_Cu.gbr, SnapInCapStack-B_Mask.gbr, SnapInCapStack-B_SilkS.gbr, SnapInCapStack-Edge_Cuts.gbr, SnapInCapStack-F_Cu.gbr, SnapInCapStack-F_Mask.gbr, SnapInCapStack-F_SilkS.gbr, SnapInCapStack-NPTH.drl]
2022-01-05 Part # tweaks (to reflect currently-available components).
    [screen-supply-and-regulator.kicad_pcb, screen-supply-and-regulator.sch]
2022-01-06 Add JPG images of the PCBs.
2022-01-06 Spec United Chemi-Con E92L401VSN561MR65U caps for the first filter stage; the TDK parts previously listed are EoL.
    [hv-supply.sch]
2022-01-06 Update copyright, rev 1.0.
    [hv-supply.sch]
2022-01-06 Add a note about the power switch configuration for the B+ rail.
2022-01-06 Add PDF of the HV supply schematic.
2022-01-06 Regenerate for rounded corners.
    [SnapInCapStack-B_Cu.gbr, SnapInCapStack-B_Mask.gbr, SnapInCapStack-B_SilkS.gbr, SnapInCapStack-Edge_Cuts.gbr, SnapInCapStack-F_Cu.gbr, SnapInCapStack-F_Mask.gbr, SnapInCapStack-F_SilkS.gbr, SnapInCapStack-NPTH.drl]
2022-01-06 Add JPG image of PCB.
2022-01-06 Add a footprint for Rayex LB2 lugged relays.
2022-01-07 Inital add of design files for my Rasbperry Pi-based remote power controller.
    [RPI_Remote_Power_Controller.kicad_pcb, RPI_Remote_Power_Controller.sch]
2022-01-07 Add a symbol for Rayex LB2 DPDT relays.
2022-01-08 Initial device tree overlays.
2022-01-08 - We really are using ULN2003s. - Connect the ~RESET line of the MCP23008 to pin 40 of the GPIO header.
    [RPI_Remote_Power_Controller.kicad_pcb, RPI_Remote_Power_Controller.sch]
2022-01-08 Fits on 8.5 x 11.
    [RPI_Remote_Power_Controller.kicad_pcb]
2022-01-08 Add PDFs / JPGs of the schematic and PCB, and add a README describing what this thing is.
2022-01-08 Generate Gerbers.
    [RPI_Remote_Power_Controller-B_Cu.gbr, RPI_Remote_Power_Controller-B_Mask.gbr, RPI_Remote_Power_Controller-B_SilkS.gbr, RPI_Remote_Power_Controller-Edge_Cuts.gbr, RPI_Remote_Power_Controller-F_Cu.gbr, RPI_Remote_Power_Controller-F_Mask.gbr, RPI_Remote_Power_Controller-F_SilkS.gbr, RPI_Remote_Power_Controller-NPTH.drl]
2022-01-09 Increase trace clarance for the default net class to 0.3mm, and reroute several traces to meet new clearance requirements.
    [RPI_Remote_Power_Controller-B_Cu.gbr, RPI_Remote_Power_Controller-B_Mask.gbr, RPI_Remote_Power_Controller-B_SilkS.gbr, RPI_Remote_Power_Controller-Edge_Cuts.gbr, RPI_Remote_Power_Controller-F_Cu.gbr, RPI_Remote_Power_Controller-F_Mask.gbr, RPI_Remote_Power_Controller-F_SilkS.gbr, RPI_Remote_Power_Controller-NPTH.drl]
2022-01-16 Silkscreen corrections.
    [screen-supply-and-regulator.kicad_pcb]
2022-01-16 Fix hilarious layout mistake -- swap the locations of C1 and C2. No functional difference, but it's what I originally intended, and is a little more intuitive.
    [screen-supply-and-regulator.kicad_pcb]
2022-01-16 Move screw terminal labels further away from footprints to reduce the change they'll be obscrured by the terminal block.
    [screen-supply-and-regulator.kicad_pcb]
2022-04-21 EFB Bias Supply: Add PDFs / JPGs of the schematic / board.
2022-04-24 Add a Teensy 4.1 GPIO + power pins symbol.
2022-12-13 Added RPi Pico symbol / footprint (from RaspberryPi.org).
2022-12-14 Pure through-hole RPi Pico footprint.
2022-12-19 Add footprint for the Kobiconn_163-179PH 5.5 x 2.1 PCB-mount barrel jack.
2023-02-12 Add TR1863 UART.
2023-02-19 STX-3128-B: Use pin numbers from the data sheet, and put T/R/S on the silk screen.
2023-06-08 Tweak the GAL22V10 symbol -- more space around the pin name.
2023-06-25 Add symbols for the Ali Express FTDI break-out board that I like to use and the Adafruit FTDI Friend.
2023-06-26 Rename DIP-18_W10.16mm_Socket to Ali_Express_FTDI_Breakout and fix the pin width.
2023-07-17 Add SNES game connector symbol and footprint.
2024-02-08 Add a VERA module footprint. This is mainly a 2x12 pin header, but also has ghost locations for the mounting holes. This is still a work-in-progress.
2024-02-08 Add footprint to VERA module.
2024-02-08 Fix VERA mounting holes.
2024-02-08 Fix RESET pin number on VERA module.
2024-02-08 Add VERA module PCB template.
    [VERA_Module.kicad_pcb]
2025-06-26 Add a PGA169 socket footprint.
2025-06-26 Add SIMM footprints.
2025-06-28 Add a PGA68 footprint.
2025-06-29 Add PGA68 footprint to 68882
2025-06-29 Fix the /RESET pin on the 68882.
2026-07-29 Add some symbols for the MVME-buttress-board: - VME P1, VME P2 - Single-ended SCSI male IDC50 connector.
