thorpej/Electronics/(notices)

Notices in the files:
Tube_Audio/Helper_Circuits/Bias_Balance_Helper_x2/Bias_Balance_Helper_x2.kicad_pcb:
(c) 2017 Jason R. Thorpe
Tube_Audio/Helper_Circuits/SnapInCapStack/SnapInCapStack.kicad_pcb:
Copyright (c) 2019 Jason R. Thorpe. See LICENSE.txt.
Power_Supplies/KWard_Adjustable_Bench_Power_Supply/design-files/screen-supply-and-regulator/screen-supply-and-regulator.kicad_pcb:
Copyright (c) 2021 Jason R. Thorpe. See LICENSE.
Power_Supplies/KWard_Adjustable_Bench_Power_Supply/design-files/hv-supply/hv-supply.sch:
Copyright (c) 2017-2021 Kevin Ward and Jason R. Thorpe. See LICENSE.
Tube_Audio/6AS7_Pre_amp_Mk_I/STPre6080PSU.kicad_pcb:
Copyright 2019 Jason R. Thorpe. All rights reserved.
Power_Supplies/RPI_Remote_Power_Controller/RPI_Remote_Power_Controller.kicad_pcb:
Copyright (c) 2022 Jason R. Thorpe. See LICENSE.txt.
KiCad/PCB_Templates/VERA_Module.kicad_pcb:
Copyright 2024 Jason R. Thorpe. See LICENSE.
Power_Supplies/KWard_Adjustable_Bench_Power_Supply/design-files/panel-supply/panel-supply.sch:
Copyright (c) 2017-2022 Kevin Ward and Jason R. Thorpe. See LICENSE.
Tube_Audio/Helper_Circuits/CCS_Tail_x2/CCS_Tail_x2.sch:
Copyright 2017, 2019 Jason R. Thorpe. All rights reserved.
Tube_Audio/Helper_Circuits/CCS_Load_x2/CCS_Load_x2.kicad_pcb:
Copyright 2018, 2019 Jason R. Thorpe. All rights reserved.
Power_Supplies/MOSFET_Pass_Regulator/MOSFET_Pass_Regulator.kicad_pcb:
Board rev 1.1, (c) 2018 Jason R. Thorpe
Tube_Audio/Helper_Circuits/EFB_Bias_Supply/EFB_Bias_Supply.kicad_pcb:
Board (c) 2018
Power_Supplies/KWard_Adjustable_Bench_Power_Supply/design-files/panel-supply/panel-supply.kicad_pcb:
Copyright (c) 2021-2022 Jason R. Thorpe. See LICENSE.
Tube_Audio/Helper_Circuits/9A_9AJ_Heater_Helper/9A_9AJ_Heater_Helper.sch:
Copyright 2019 Jason R. Thorpe. See LICENSE.txt.
Tube_Audio/Helper_Circuits/EFB_Cathode_Regulator/EFB_Cathode_Regulator.kicad_pcb:
Board (c) 2018 Jason R. Thorpe.
